uw-acme/NANO_QLASER/documents/Diagrams/readme.md

This directory is for user-created documents such as Visio block diagrams, pdfs of those diagrams, Excel spreadsheets for board-to-board connections.
Basically, any useful documentation that we create.
