uw-acme/NANO_QLASER/documents/Diagrams/qlaser-clocks.pdf

## FMC216 Board

# ZCU102 and FMC216 clock, sync connections [HPC0]

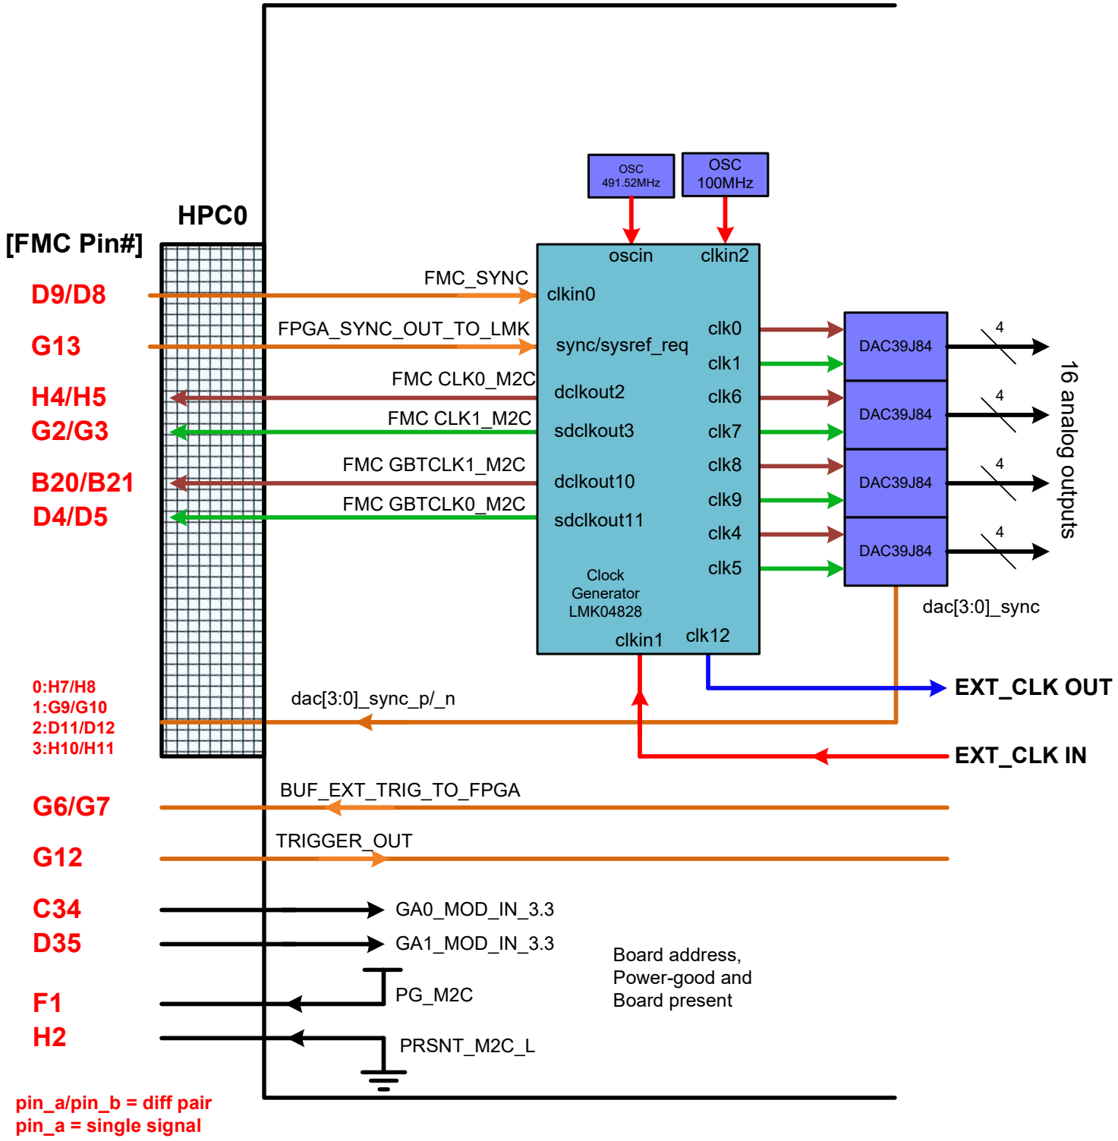
[picture p10: figure]
HPC0; DAC39J84; OSC 100MHz; EXT_CLK IN; EXT_CLK OUT; OSC 491.52MHz; FMC_SYNC; FPGA_SYNC_OUT_TO_LMK; FMC CLK1_M2C; FMC CLK0_M2C; FMC GBTCLK0_M2C; FMC GBTCLK1_M2C; dac[3:0]_sync; dac[3:0]_sync_p/_n 0:H7/H8 1:G9/G10 2:D11/D12 3:H10/H11; TRIGGER_OUT; PRSNT_M2C_L; GA1_MOD_IN_3.3; GA0_MOD_IN_3.3; clkin2; clkin1; oscin; clkin0; dclkout2; sdclkout3; dclkout10; sdclkout11; sync/sysref_req; BUF_EXT_TRIG_TO_FPGA G6/G7; clk12; clk0; clk1; clk6; clk7; clk8; clk9; clk4; clk5 Clock; Generator LMK04828; Board address, Power-good and; Board present; 16 analog outputs; [FMC Pin#]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
