uw-acme/NANO_QLASER/documents/Diagrams/FMC_connector_pinout.xlsx

Sheet: FMC216_connector_pinout
AV57.1 | FMC Pin | FMC216 Signal | FMC216 Dir | FPGA Pin | FPGA name | ZCU102 Net | I/O Stndrd | Notes
FMC0
CLK0_M2C_P | H4 | LLMK_DCLKOUT_2_P | Out | AA7 | P_FMC0_CLK0_M2C_P | FMC_HPC0_CLK0_M2C_P | LVDS | D-Clock
CLK0_M2C_N | H5 | LLMK_DCLKOUT_2_N | Out | AA6 | P_FMC0_CLK0_M2C_N | FMC_HPC0_CLK0_M2C_N | LVDS | D-Clock
CLK1_M2C_P | G2 | LLMK_SDCLKOUT_3_P | Out | T8 | P_FMC0_CLK1_M2C_P | FMC_HPC0_CLK1_M2C_P | LVDS | S-Clock
CLK1_M2C_N | G3 | LLMK_SDCLKOUT_3_N | Out | R8 | P_FMC0_CLK1_M2C_P | FMC_HPC0_CLK1_M2C_P | LVDS | S-Clock
GBTCLK0_M2C_P | D4 | LMK_SDCLK11_M2C_TO_FPGA_P | Out | G8 | P_FMC0_GBTCLK0_M2C_P | FMC_HPC0_GBTCLK0_M2C_P | LVDS | S-Clock
GBTCLK0_M2C_P | D5 | LMK_SDCLK11_M2C_TO_FPGA_N | Out | G7 | P_FMC0_GBTCLK0_M2C_N | FMC_HPC0_GBTCLK0_M2C_N | LVDS | S-Clock
GBTCLK1_M2C_P | B20 | LMK_DCLK10_M2C_TO_FPGA_P | Out | L8 | P_FMC0_GBTCLK1_M2C_P | FMC_HPC0_GBTCLK1_M2C_P | LVDS | DCLKOUT10_P is routed to the FPGA GBTCLK1_M2C_P
GBTCLK1_M2C_P | B21 | LMK_DCLK10_M2C_TO_FPGA_N | Out | L7 | P_FMC0_GBTCLK1_M2C_N | FMC_HPC0_GBTCLK1_M2C_N | LVDS | DCLKOUT10_N is routed to the FPGA GBTCLK1_M2C_N
DP0_C2M_P | C2 | DP0_C2M_P | In | G4 | P_FMC0_TXP_P[0] | FMC_HPC0_DP0_C2M_P | CML | DAC0_LANE0_P
DP0_C2M_N | C3 | DP0_C2M_N | In | G3 | P_FMC0_TXP_N[0] | FMC_HPC0_DP0_C2M_N | CML | DAC0_LANE0_N
DP1_C2M_P | A22 | DP1_C2M_P | In | H6 | P_FMC0_TXP_P[1] | FMC_HPC0_DP1_C2M_P | CML | DAC1_LANE0_P
DP1_C2M_N | A23 | DP1_C2M_N | In | H5 | P_FMC0_TXP_N[1] | FMC_HPC0_DP1_C2M_N | CML | DAC1_LANE0_N
DP2_C2M_P | A26 | DP2_C2M_P | In | F6 | P_FMC0_TXP_P[2] | FMC_HPC0_DP2_C2M_P | CML | DAC2_LANE0_P
DP2_C2M_N | A27 | DP2_C2M_N | In | F5 | P_FMC0_TXP_N[2] | FMC_HPC0_DP2_C2M_N | CML | DAC2_LANE0_N
DP3_C2M_P | A30 | DP3_C2M_P | In | K6 | P_FMC0_TXP_P[3] | FMC_HPC0_DP3_C2M_P | CML | DAC3_LANE0_P
DP3_C2M_N | A31 | DP3_C2M_N | In | K5 | P_FMC0_TXP_N[3] | FMC_HPC0_DP3_C2M_N | CML | DAC3_LANE0_N
DP4_C2M_P | A34 | DP4_C2M_P | In | M6 | P_FMC0_TXP_P[4] | FMC_HPC0_DP4_C2M_P | CML | DAC0_LANE1_P
DP4_C2M_N | A35 | DP4_C2M_N | In | M5 | P_FMC0_TXP_N[4] | FMC_HPC0_DP4_C2M_N | CML | DAC0_LANE1_N
DP5_C2M_P | A38 | DP5_C2M_P | In | P6 | P_FMC0_TXP_P[5] | FMC_HPC0_DP5_C2M_P | CML | DAC1_LANE1_P
DP5_C2M_N | A39 | DP5_C2M_N | In | P5 | P_FMC0_TXP_N[5] | FMC_HPC0_DP5_C2M_N | CML | DAC1_LANE1_N
DP6_C2M_P | B36 | DP6_C2M_P | In | R4 | P_FMC0_TXP_P[6] | FMC_HPC0_DP6_C2M_P | CML | DAC2_LANE1_P
DP6_C2M_N | B37 | DP6_C2M_N | In | R3 | P_FMC0_TXP_N[6] | FMC_HPC0_DP6_C2M_N | CML | DAC2_LANE1_N
DP7_C2M_P | B32 | DP7_C2M_P | In | N4 | P_FMC0_TXP_P[7] | FMC_HPC0_DP7_C2M_P | CML | DAC3_LANE1_P
DP7_C2M_N | B33 | DP7_C2M_N | In | N3 | P_FMC0_TXP_N[7] | FMC_HPC0_DP7_C2M_N | CML | DAC3_LANE1_N
LA00_P_CC | G6 | BUF_EXT_TRIG_TO_FPGA_P | Out | Y4 | P_FMC0_EXT_TRIG_IN_P | FMC_HPC0_LA00_CC_P | LVDS | From external trigger to FPGA
LA00_N_CC | G7 | BUF_EXT_TRIG_TO_FPGA_N | Out | Y3 | P_FMC0_EXT_TRIG_IN_N | FMC_HPC0_LA00_CC_N | LVDS | From external trigger to FPGA
LA01_P_CC | D8 | FPGA_SYNC_OUT_P | In | AB4 | P_FMC0_SYNC_OUT_P | FMC_HPC0_LA01_CC_P | LVDS | From FPGA to clock tree trigger
LA01_N_CC | D9 | FPGA_SYNC_OUT_N | In | AC4 | P_FMC0_SYNC_OUT_N | FMC_HPC0_LA01_CC_N | LVDS | From FPGA to clock tree trigger
LA02_P | H7 | DAC0_SYNC_P | Out | V2 | P_FMC0_SYNC_P[0] | FMC_HPC0_LA02_P | LVDS | Synchronization request to FPGA
LA02_N | H8 | DAC0_SYNC_N | Out | V1 | P_FMC0_SYNC_N[0] | FMC_HPC0_LA02_N | LVDS | Synchronization request to FPGA
LA03_P | G9 | DAC1_SYNC_P | Out | Y2 | P_FMC0_SYNC_P[1] | FMC_HPC0_LA03_P | LVDS | Synchronization request to FPGA
LA03_N | G10 | DAC1_SYNC_N | Out | Y1 | P_FMC0_SYNC_N[1] | FMC_HPC0_LA03_N | LVDS | Synchronization request to FPGA
LA04_P | H10 | DAC3_SYNC_P | Out | AA2 | P_FMC0_SYNC_P[3] | FMC_HPC0_LA04_P | LVDS | Synchronization request to FPGA
LA04_N | H11 | DAC3_SYNC_N | Out | AA1 | P_FMC0_SYNC_N[3] | FMC_HPC0_LA04_N | LVDS | Synchronization request to FPGA
LA05_P | D11 | DAC2_SYNC_P | Out | AB3 | P_FMC0_SYNC_P[2] | FMC_HPC0_LA05_P | LVDS | Synchronization request to FPGA
LA05_N | D12 | DAC2_SYNC_N | Out | AC3 | P_FMC0_SYNC_N[2] | FMC_HPC0_LA05_N | LVDS | Synchronization request to FPGA
LA06_P | C10 | FMC_CPLD_CTRL0_VADJ | I/O | AC2 | ? | FMC_HPC0_LA06_P | LVCMOS | CPLD Control Signal
LA06_N | C11 | FMC_CPLD_CTRL1_VADJ | I/O | AC1 | ? | FMC_HPC0_LA06_N | LVCMOS | CPLD Control Signal
LA07_P | H13 | FMC_CPLD_CTRL2_VADJ | I/O | U5 | ? | FMC_HPC0_LA07_P | LVCMOS | CPLD Control Signal
LA07_N | H14 | FMC_CPLD_CTRL3_VADJ | I/O | U4 | ? | FMC_HPC0_LA07_N | LVCMOS | CPLD Control Signal
LA08_P | G12 | TRIGGER_OUT | In | V4 | P_FMC0_TRIG_OUT ? | FMC_HPC0_LA08_P | LVCMOS | External Trigger output from FPGA
LA08_N | G13 | FPGA_SYNC_OUT_TO_LMK | In | V3 | P_FMC0_SYNC_LMK ? | FMC_HPC0_LA08_N | LVCMOS | SYNC from FPGA, connects to SYNC/SYSREF_REQ of LMK
GA0 | C34 | GA0_MOD_IN_3.3 | In | GND |  |  | LVCMOS | Card Global Address 0 from mezzanine connector
GA1 | D35 | GA1_MOD_IN_3.3 | In | GND |  |  | LVCMOS | Card Global Address 1 from mezzanine connector
GA0 | C34 | GA0_CC_OUT_3.3 | Out | GND |  |  | LVCMOS | Card Global Address 0 from CPLD to carrier connector
GA1 | D35 | GA1_CC_OUT_3.3 | Out | GND |  |  | LVCMOS | Card Global Address 1 from CPLD to carrier connector
TSRT_L | D34 | TRST_L | In | - | - |  | LVTTL | JTAG Reset in, (also passed through)
TCK | D29 | TCK | In | - | - |  | LVTTL | JTAG Clock in, (also passed through)
TMS | D33 | TMS | In | - | - |  | LVTTL | JTAG Test Mode Select (also passed through)
TDI | D30 | TDI | In | - | - |  | LVTTL | JTAG Data in (also passed through)
TDO | D31 | TDO | Out | - | - |  | LVTTL | JTAG Data Out (also passed through)
PRSNT_M2C_L | H2 | PRSNT_M2C_L | Out | - | - | FMC_HPC0_PRSNT_M2C_B | Ground | Tied to GND (FM216 is present). Controls JTAG switch.
PRSNT_M2C_L | H2 | PRSNT_M2C_CC_L | In | - | - |  | LVCMOS | Indicates that a stacked card is present (from carrier connector to CPLD)
PG_M2C | F1 | PG_M2C | Out | - | - | FMC_HPC0_PG_M2C | Open Drain | Indicate FMC216 power good status to carrier (4.7K pullup to 3.3V)
PG_C2M | D1 | PG_C2M | Out | - | - |  | CMOS | Indicates that Carrier power is OK
I2C_SCL | C30 | I2C_SCL | In | - | - |  | CMOS | I2C Bus Clock (also passed through)
I2C_SDA | C31 | I2C_SDA | I/O | - | - |  | Open | Drain I2C Bus Data (also passed through)
RES0 | B40 | RES0 | n/a | - | - |  | n/a | Passed thru no connection
CLK_DIR | B1 | CLK_DIR | Out | - | - |  | CMOS* | Driven by mezzanine, *pop option to tie high or low
Remapped
CLK2_BIDR_P | H4 | CLK0_M2C_P | I/O |  |  |  | LVDS | remapped signal for stacked operation
CLK2_BIDR_N | H5 | CLK0_M2C_N | I/O |  |  |  | LVDS | remapped signal for stacked operation
CLK3_BIDR_P | G2 | CLK1_M2C_P | I/O |  |  |  | LVDS | remapped signal for stacked operation
CLK3_BIDR_N | G3 | CLK1_M2C_N | I/O |  |  |  | LVDS | remapped signal for stacked operation
HA17_P_CC | G6 | LA00_P_CC | I/O |  |  |  | LVDS | remapped signal for stacked operation
HA17_N_CC | G7 | LA00_N_CC | I/O |  |  |  | LVDS | remapped signal for stacked operation
HA18_P | D8 | LA01_P_CC | I/O |  |  |  | LVDS | remapped signal for stacked operation
HA18_N | D9 | LA01_N_CC | I/O |  |  |  | LVDS | remapped signal for stacked operation
HA10_P | H7 | LA02_P | I/O |  |  |  | LVDS | remapped signal for stacked operation
HA10_N | H8 | LA02_N | I/O |  |  |  | LVDS | remapped signal for stacked operation
HA11_P | G9 | LA03_P | I/O |  |  |  | LVDS | remapped signal for stacked operation
HA11_N | G10 | LA03_N | I/O |  |  |  | LVDS | remapped signal for stacked operation
HA12_P | H10 | LA04_P | I/O |  |  |  | LVDS | remapped signal for stacked operation
HA12_N | H11 | LA04_N | I/O |  |  |  | LVDS | remapped signal for stacked operation
HA13_P | D11 | LA05_P | I/O |  |  |  | LVDS | remapped signal for stacked operation
HA13_N | D12 | LA05_N | I/O |  |  |  | LVDS | remapped signal for stacked operation
HA14_P | C10 | LA06_P | I/O |  |  |  | LVDS | remapped signal for stacked operation
HA14_N | C11 | LA06_N | I/O |  |  |  | LVDS | remapped signal for stacked operation
HA15_P | H13 | LA07_P | I/O |  |  |  | LVDS | remapped signal for stacked operation
HA15_N | H14 | LA07_N | I/O |  |  |  | LVDS | remapped signal for stacked operation
HA16_P | G12 | LA08_P | I/O |  |  |  | LVDS | remapped signal for stacked operation
HA16_N | G13 | LA08_N | I/O |  |  |  | LVDS | remapped signal for stacked operation

Sheet: FMC0-1-fpga-conn
AV57.1 | FMC Pin | FMC216 Signal | FMC216 Dir | FPGA Pin | FPGA name | ZCU102 Net | I/O Stndrd | Notes
FMC0
CLK0_M2C_P | H4 | LLMK_DCLKOUT_2_P | Out | AA7 | P_FMC0_CLK0_M2C_P | FMC_HPC0_CLK0_M2C_P | LVDS | D-Clock (for stacked card)
CLK0_M2C_N | H5 | LLMK_DCLKOUT_2_N | Out | AA6 | P_FMC0_CLK0_M2C_N | FMC_HPC0_CLK0_M2C_N | LVDS | D-Clock
CLK1_M2C_P | G2 | LLMK_SDCLKOUT_3_P | Out | T8 | P_FMC0_CLK1_M2C_P | FMC_HPC0_CLK1_M2C_P | LVDS | S-Clock (for stacked card)
CLK1_M2C_N | G3 | LLMK_SDCLKOUT_3_N | Out | R8 | P_FMC0_CLK1_M2C_P | FMC_HPC0_CLK1_M2C_P | LVDS | S-Clock
GBTCLK0_M2C_P | D4 | LMK_SDCLK11_M2C_TO_FPGA_P | Out | G8 | P_FMC0_GBTCLK0_M2C_P | FMC_HPC0_GBTCLK0_M2C_P | LVDS | S-Clock (REFCLK?)
GBTCLK0_M2C_P | D5 | LMK_SDCLK11_M2C_TO_FPGA_N | Out | G7 | P_FMC0_GBTCLK0_M2C_N | FMC_HPC0_GBTCLK0_M2C_N | LVDS | S-Clock
GBTCLK1_M2C_P | B20 | LMK_DCLK10_M2C_TO_FPGA_P | Out | L8 | P_FMC0_GBTCLK1_M2C_P | FMC_HPC0_GBTCLK1_M2C_P | LVDS | DCLKOUT10_P is routed to the FPGA GBTCLK1_M2C_P
GBTCLK1_M2C_P | B21 | LMK_DCLK10_M2C_TO_FPGA_N | Out | L7 | P_FMC0_GBTCLK1_M2C_N | FMC_HPC0_GBTCLK1_M2C_N | LVDS | DCLKOUT10_N is routed to the FPGA GBTCLK1_M2C_N
DP0_C2M_P | C2 | DP0_C2M_P | In | G4 | P_FMC0_TXP_P[0] | FMC_HPC0_DP0_C2M_P | CML | DAC0_LANE0_P
DP0_C2M_N | C3 | DP0_C2M_N | In | G3 | P_FMC0_TXP_N[0] | FMC_HPC0_DP0_C2M_N | CML | DAC0_LANE0_N
DP1_C2M_P | A22 | DP1_C2M_P | In | H6 | P_FMC0_TXP_P[1] | FMC_HPC0_DP1_C2M_P | CML | DAC1_LANE0_P
DP1_C2M_N | A23 | DP1_C2M_N | In | H5 | P_FMC0_TXP_N[1] | FMC_HPC0_DP1_C2M_N | CML | DAC1_LANE0_N
DP2_C2M_P | A26 | DP2_C2M_P | In | F6 | P_FMC0_TXP_P[2] | FMC_HPC0_DP2_C2M_P | CML | DAC2_LANE0_P
DP2_C2M_N | A27 | DP2_C2M_N | In | F5 | P_FMC0_TXP_N[2] | FMC_HPC0_DP2_C2M_N | CML | DAC2_LANE0_N
DP3_C2M_P | A30 | DP3_C2M_P | In | K6 | P_FMC0_TXP_P[3] | FMC_HPC0_DP3_C2M_P | CML | DAC3_LANE0_P
DP3_C2M_N | A31 | DP3_C2M_N | In | K5 | P_FMC0_TXP_N[3] | FMC_HPC0_DP3_C2M_N | CML | DAC3_LANE0_N
DP4_C2M_P | A34 | DP4_C2M_P | In | M6 | P_FMC0_TXP_P[4] | FMC_HPC0_DP4_C2M_P | CML | DAC0_LANE1_P
DP4_C2M_N | A35 | DP4_C2M_N | In | M5 | P_FMC0_TXP_N[4] | FMC_HPC0_DP4_C2M_N | CML | DAC0_LANE1_N
DP5_C2M_P | A38 | DP5_C2M_P | In | P6 | P_FMC0_TXP_P[5] | FMC_HPC0_DP5_C2M_P | CML | DAC1_LANE1_P
DP5_C2M_N | A39 | DP5_C2M_N | In | P5 | P_FMC0_TXP_N[5] | FMC_HPC0_DP5_C2M_N | CML | DAC1_LANE1_N
DP6_C2M_P | B36 | DP6_C2M_P | In | R4 | P_FMC0_TXP_P[6] | FMC_HPC0_DP6_C2M_P | CML | DAC2_LANE1_P
DP6_C2M_N | B37 | DP6_C2M_N | In | R3 | P_FMC0_TXP_N[6] | FMC_HPC0_DP6_C2M_N | CML | DAC2_LANE1_N
DP7_C2M_P | B32 | DP7_C2M_P | In | N4 | P_FMC0_TXP_P[7] | FMC_HPC0_DP7_C2M_P | CML | DAC3_LANE1_P
DP7_C2M_N | B33 | DP7_C2M_N | In | N3 | P_FMC0_TXP_N[7] | FMC_HPC0_DP7_C2M_N | CML | DAC3_LANE1_N
LA00_P_CC | G6 | BUF_EXT_TRIG_TO_FPGA_P | Out | Y4 | P_FMC0_EXT_TRIG_IN_P | FMC_HPC0_LA00_CC_P | LVDS | From external trigger to FPGA
LA00_N_CC | G7 | BUF_EXT_TRIG_TO_FPGA_N | Out | Y3 | P_FMC0_EXT_TRIG_IN_N | FMC_HPC0_LA00_CC_N | LVDS | From external trigger to FPGA
LA01_P_CC | D8 | FPGA_SYNC_OUT_P | In | AB4 | P_FMC0_SYNC_OUT_P | FMC_HPC0_LA01_CC_P | LVDS | From FPGA to clock tree trigger
LA01_N_CC | D9 | FPGA_SYNC_OUT_N | In | AC4 | P_FMC0_SYNC_OUT_N | FMC_HPC0_LA01_CC_N | LVDS | From FPGA to clock tree trigger
LA02_P | H7 | DAC0_SYNC_P | Out | V2 | P_FMC0_SYNC_P[0] | FMC_HPC0_LA02_P | LVDS | Synchronization request to FPGA
LA02_N | H8 | DAC0_SYNC_N | Out | V1 | P_FMC0_SYNC_N[0] | FMC_HPC0_LA02_N | LVDS | Synchronization request to FPGA
LA03_P | G9 | DAC1_SYNC_P | Out | Y2 | P_FMC0_SYNC_P[1] | FMC_HPC0_LA03_P | LVDS | Synchronization request to FPGA
LA03_N | G10 | DAC1_SYNC_N | Out | Y1 | P_FMC0_SYNC_N[1] | FMC_HPC0_LA03_N | LVDS | Synchronization request to FPGA
LA04_P | H10 | DAC3_SYNC_P | Out | AA2 | P_FMC0_SYNC_P[3] | FMC_HPC0_LA04_P | LVDS | Synchronization request to FPGA
LA04_N | H11 | DAC3_SYNC_N | Out | AA1 | P_FMC0_SYNC_N[3] | FMC_HPC0_LA04_N | LVDS | Synchronization request to FPGA
LA05_P | D11 | DAC2_SYNC_P | Out | AB3 | P_FMC0_SYNC_P[2] | FMC_HPC0_LA05_P | LVDS | Synchronization request to FPGA
LA05_N | D12 | DAC2_SYNC_N | Out | AC3 | P_FMC0_SYNC_N[2] | FMC_HPC0_LA05_N | LVDS | Synchronization request to FPGA
LA06_P | C10 | FMC_CPLD_CTRL0_VADJ | I/O | AC2 | ? | FMC_HPC0_LA06_P | LVCMOS | CPLD Control Signal
LA06_N | C11 | FMC_CPLD_CTRL1_VADJ | I/O | AC1 | ? | FMC_HPC0_LA06_N | LVCMOS | CPLD Control Signal
LA07_P | H13 | FMC_CPLD_CTRL2_VADJ | I/O | U5 | ? | FMC_HPC0_LA07_P | LVCMOS | CPLD Control Signal
LA07_N | H14 | FMC_CPLD_CTRL3_VADJ | I/O | U4 | ? | FMC_HPC0_LA07_N | LVCMOS | CPLD Control Signal
LA08_P | G12 | TRIGGER_OUT | In | V4 | P_FMC0_TRIG_OUT ? | FMC_HPC0_LA08_P | LVCMOS | External Trigger output from FPGA
LA08_N | G13 | FPGA_SYNC_OUT_TO_LMK | In | V3 | P_FMC0_SYNC_LMK ? | FMC_HPC0_LA08_N | LVCMOS | SYNC from FPGA, connects to SYNC/SYSREF_REQ of LMK
GA0 | C34 | GA0_MOD_IN_3.3 | In | GND |  |  | LVCMOS | Card Global Address 0 from mezzanine connector
GA1 | D35 | GA1_MOD_IN_3.3 | In | GND |  |  | LVCMOS | Card Global Address 1 from mezzanine connector
GA0 | C34 | GA0_CC_OUT_3.3 | Out | GND |  |  | LVCMOS | Card Global Address 0 from CPLD to carrier connector
GA1 | D35 | GA1_CC_OUT_3.3 | Out | GND |  |  | LVCMOS | Card Global Address 1 from CPLD to carrier connector
TSRT_L | D34 | TRST_L | In | - | - |  | LVTTL | JTAG Reset in, (also passed through)
TCK | D29 | TCK | In | - | - |  | LVTTL | JTAG Clock in, (also passed through)
TMS | D33 | TMS | In | - | - |  | LVTTL | JTAG Test Mode Select (also passed through)
TDI | D30 | TDI | In | - | - |  | LVTTL | JTAG Data in (also passed through)
TDO | D31 | TDO | Out | - | - |  | LVTTL | JTAG Data Out (also passed through)
PRSNT_M2C_L | H2 | PRSNT_M2C_L | Out | - | - | FMC_HPC0_PRSNT_M2C_B | Ground | Tied to GND (FM216 is present). Controls JTAG switch.
PRSNT_M2C_L | H2 | PRSNT_M2C_CC_L | In | - | - |  | LVCMOS | Indicates that a stacked card is present (from carrier connector to CPLD)
PG_M2C | F1 | PG_M2C | Out | - | - | FMC_HPC0_PG_M2C | Open Drain | Indicate FMC216 power good status to carrier (4.7K pullup to 3.3V)
PG_C2M | D1 | PG_C2M | Out | - | - |  | CMOS | Indicates that Carrier power is OK
I2C_SCL | C30 | I2C_SCL | In | - | - |  | CMOS | I2C Bus Clock (also passed through)
I2C_SDA | C31 | I2C_SDA | I/O | - | - |  | Open | Drain I2C Bus Data (also passed through)
RES0 | B40 | RES0 | n/a | - | - |  | n/a | Passed thru no connection
CLK_DIR | B1 | CLK_DIR | Out | - | - |  | CMOS* | Driven by mezzanine, *pop option to tie high or low
FMC1
CLK0_M2C_P | H4 | LLMK_DCLKOUT_2_P | Out | AE7 | P_FMC1_CLK0_M2C_P | FMC_HPC1_CLK0_M2C_P | LVDS | D-Clock
CLK0_M2C_N | H5 | LLMK_DCLKOUT_2_N | Out | AF7 | P_FMC1_CLK0_M2C_N | FMC_HPC1_CLK0_M2C_N | LVDS | D-Clock
CLK1_M2C_P | G2 | LLMK_SDCLKOUT_3_P | Out | P10 | P_FMC1_CLK1_M2C_P | FMC_HPC1_CLK1_M2C_P | LVDS | S-Clock
CLK1_M2C_N | G3 | LLMK_SDCLKOUT_3_N | Out | P9 | P_FMC1_CLK1_M2C_P | FMC_HPC1_CLK1_M2C_P | LVDS | S-Clock
GBTCLK0_M2C_P | D4 | LMK_SDCLK11_M2C_TO_FPGA_P | Out | G27 | P_FMC1_GBTCLK0_M2C_P | FMC_HPC1_GBTCLK0_M2C_P | LVDS | S-Clock
GBTCLK0_M2C_P | D5 | LMK_SDCLK11_M2C_TO_FPGA_N | Out | G28 | P_FMC1_GBTCLK0_M2C_N | FMC_HPC1_GBTCLK0_M2C_N | LVDS | S-Clock
GBTCLK1_M2C_P | B20 | LMK_DCLK10_M2C_TO_FPGA_P | Out | E27 | P_FMC1_GBTCLK1_M2C_P | FMC_HPC1_GBTCLK1_M2C_P | LVDS | DCLKOUT10_P is routed to the FPGA GBTCLK1_M2C_P
GBTCLK1_M2C_P | B21 | LMK_DCLK10_M2C_TO_FPGA_N | Out | E28 | P_FMC1_GBTCLK1_M2C_N | FMC_HPC1_GBTCLK1_M2C_N | LVDS | DCLKOUT10_N is routed to the FPGA GBTCLK1_M2C_N
DP0_C2M_P | C2 | DP0_C2M_P | In | F29 | P_FMC1_TXP_P[0] | FMC_HPC1_DP0_C2M_P | CML | DAC0_LANE0_P
DP0_C2M_N | C3 | DP0_C2M_N | In | F30 | P_FMC1_TXP_N[0] | FMC_HPC1_DP0_C2M_N | CML | DAC0_LANE0_N
DP1_C2M_P | A22 | DP1_C2M_P | In | D29 | P_FMC1_TXP_P[1] | FMC_HPC1_DP1_C2M_P | CML | DAC1_LANE0_P
DP1_C2M_N | A23 | DP1_C2M_N | In | D30 | P_FMC1_TXP_N[1] | FMC_HPC1_DP1_C2M_N | CML | DAC1_LANE0_N
DP2_C2M_P | A26 | DP2_C2M_P | In | B29 | P_FMC1_TXP_P[2] | FMC_HPC1_DP2_C2M_P | CML | DAC2_LANE0_P
DP2_C2M_N | A27 | DP2_C2M_N | In | B30 | P_FMC1_TXP_N[2] | FMC_HPC1_DP2_C2M_N | CML | DAC2_LANE0_N
DP3_C2M_P | A30 | DP3_C2M_P | In | A31 | P_FMC1_TXP_P[3] | FMC_HPC1_DP3_C2M_P | CML | DAC3_LANE0_P
DP3_C2M_N | A31 | DP3_C2M_N | In | A32 | P_FMC1_TXP_N[3] | FMC_HPC1_DP3_C2M_N | CML | DAC3_LANE0_N
DP4_C2M_P | A34 | DP4_C2M_P | In | K29 | P_FMC1_TXP_P[4] | FMC_HPC1_DP4_C2M_P | CML | DAC0_LANE1_P
DP4_C2M_N | A35 | DP4_C2M_N | In | K30 | P_FMC1_TXP_N[4] | FMC_HPC1_DP4_C2M_N | CML | DAC0_LANE1_N
DP5_C2M_P | A38 | DP5_C2M_P | In | J31 | P_FMC1_TXP_P[5] | FMC_HPC1_DP5_C2M_P | CML | DAC1_LANE1_P
DP5_C2M_N | A39 | DP5_C2M_N | In | J32 | P_FMC1_TXP_N[5] | FMC_HPC1_DP5_C2M_N | CML | DAC1_LANE1_N
DP6_C2M_P | B36 | DP6_C2M_P | In | H29 | P_FMC1_TXP_P[6] | FMC_HPC1_DP6_C2M_P | CML | DAC2_LANE1_P
DP6_C2M_N | B37 | DP6_C2M_N | In | H30 | P_FMC1_TXP_N[6] | FMC_HPC1_DP6_C2M_N | CML | DAC2_LANE1_N
DP7_C2M_P | B32 | DP7_C2M_P | In | G31 | P_FMC1_TXP_P[7] | FMC_HPC1_DP7_C2M_P | CML | DAC3_LANE1_P
DP7_C2M_N | B33 | DP7_C2M_N | In | G32 | P_FMC1_TXP_N[7] | FMC_HPC1_DP7_C2M_N | CML | DAC3_LANE1_N
LA00_P_CC | G6 | BUF_EXT_TRIG_TO_FPGA_P | Out | AE5 | P_FMC1_EXT_TRIG_IN_P | FMC_HPC1_LA00_CC_P | LVDS | From external trigger to FPGA
LA00_N_CC | G7 | BUF_EXT_TRIG_TO_FPGA_N | Out | AF5 | P_FMC1_EXT_TRIG_IN_N | FMC_HPC1_LA00_CC_N | LVDS | From external trigger to FPGA
LA01_P_CC | D8 | FPGA_SYNC_OUT_P | In | AJ6 | P_FMC1_SYNC_OUT_P | FMC_HPC1_LA01_CC_P | LVDS | From FPGA to clock tree trigger
LA01_N_CC | D9 | FPGA_SYNC_OUT_N | In | AJ5 | P_FMC1_SYNC_OUT_N | FMC_HPC1_LA01_CC_N | LVDS | From FPGA to clock tree trigger
LA02_P | H7 | DAC0_SYNC_P | Out | AD2 | P_FMC1_SYNC_P[0] | FMC_HPC1_LA02_P | LVDS | Synchronization request to FPGA
LA02_N | H8 | DAC0_SYNC_N | Out | AD1 | P_FMC1_SYNC_N[0] | FMC_HPC1_LA02_N | LVDS | Synchronization request to FPGA
LA03_P | G9 | DAC1_SYNC_P | Out | AH1 | P_FMC1_SYNC_P[1] | FMC_HPC1_LA03_P | LVDS | Synchronization request to FPGA
LA03_N | G10 | DAC1_SYNC_N | Out | AJ1 | P_FMC1_SYNC_N[1] | FMC_HPC1_LA03_N | LVDS | Synchronization request to FPGA
LA04_P | H10 | DAC3_SYNC_P | Out | AF2 | P_FMC1_SYNC_P[3] | FMC_HPC1_LA04_P | LVDS | Synchronization request to FPGA
LA04_N | H11 | DAC3_SYNC_N | Out | AF1 | P_FMC1_SYNC_N[3] | FMC_HPC1_LA04_N | LVDS | Synchronization request to FPGA
LA05_P | D11 | DAC2_SYNC_P | Out | AG3 | P_FMC1_SYNC_P[2] | FMC_HPC1_LA05_P | LVDS | Synchronization request to FPGA
LA05_N | D12 | DAC2_SYNC_N | Out | AH3 | P_FMC1_SYNC_N[2] | FMC_HPC1_LA05_N | LVDS | Synchronization request to FPGA
LA06_P | C10 | FMC_CPLD_CTRL0_VADJ | I/O | AH2 | ? | FMC_HPC1_LA06_P | LVCMOS | CPLD Control Signal
LA06_N | C11 | FMC_CPLD_CTRL1_VADJ | I/O | AJ2 | ? | FMC_HPC1_LA06_N | LVCMOS | CPLD Control Signal
LA07_P | H13 | FMC_CPLD_CTRL2_VADJ | I/O | AD4 | ? | FMC_HPC1_LA07_P | LVCMOS | CPLD Control Signal
LA07_N | H14 | FMC_CPLD_CTRL3_VADJ | I/O | AE4 | ? | FMC_HPC1_LA07_N | LVCMOS | CPLD Control Signal
LA08_P | G12 | TRIGGER_OUT | In | AD4 | P_FMC1_TRIG_OUT ? | FMC_HPC1_LA08_P | LVCMOS | External Trigger output from FPGA
LA08_N | G13 | FPGA_SYNC_OUT_TO_LMK | In | AE4 | P_FMC1_SYNC_LMK ? | FMC_HPC1_LA08_N | LVCMOS | SYNC from FPGA, connects to SYNC/SYSREF_REQ of LMK
GA0 | C34 | GA0_MOD_IN_3.3 | In | GND |  |  | LVCMOS | Card Global Address 0 from mezzanine connector
GA1 | D35 | GA1_MOD_IN_3.3 | In | GND |  |  | LVCMOS | Card Global Address 1 from mezzanine connector
GA0 | C34 | GA0_CC_OUT_3.3 | Out | GND |  |  | LVCMOS | Card Global Address 0 from CPLD to carrier connector
GA1 | D35 | GA1_CC_OUT_3.3 | Out | GND |  |  | LVCMOS | Card Global Address 1 from CPLD to carrier connector
TSRT_L | D34 | TRST_L | In | - | - |  | LVTTL | JTAG Reset in, (also passed through)
TCK | D29 | TCK | In | - | - |  | LVTTL | JTAG Clock in, (also passed through)
TMS | D33 | TMS | In | - | - |  | LVTTL | JTAG Test Mode Select (also passed through)
TDI | D30 | TDI | In | - | - |  | LVTTL | JTAG Data in (also passed through)
TDO | D31 | TDO | Out | - | - |  | LVTTL | JTAG Data Out (also passed through)
PRSNT_M2C_L | H2 | PRSNT_M2C_L | Out | - | - | FMC_HPC0_PRSNT_M2C_B | Ground | Tied to GND (FM216 is present). Controls JTAG switch.
PRSNT_M2C_L | H2 | PRSNT_M2C_CC_L | In | - | - |  | LVCMOS | Indicates that a stacked card is present (from carrier connector to CPLD)
PG_M2C | F1 | PG_M2C | Out | - | - | FMC_HPC0_PG_M2C | Open Drain | Indicate FMC216 power good status to carrier (4.7K pullup to 3.3V)
PG_C2M | D1 | PG_C2M | Out | - | - |  | CMOS | Indicates that Carrier power is OK
I2C_SCL | C30 | I2C_SCL | In | - | - |  | CMOS | I2C Bus Clock (also passed through)
I2C_SDA | C31 | I2C_SDA | I/O | - | - |  | Open | Drain I2C Bus Data (also passed through)
RES0 | B40 | RES0 | n/a | - | - |  | n/a | Passed thru no connection
CLK_DIR | B1 | CLK_DIR | Out | - | - |  | CMOS* | Driven by mezzanine, *pop option to tie high or low
