uw-acme/NANO_QLASER/documents/VhdlCodingStyle.docx

Title: | VHDL Coding Styles

CHANGE HISTORY:

Revision | Description of Change | Effective Date
A | Initial release. | Initial Release

# 1. Introduction

### Purpose

The purpose of the following guidelines is to ensure that code is developed in a way that is easy to maintain and understand by different engineers.

### Scope

This document is intended to be used by engineers that are developing FPGA and ASIC code in VHDL although the general principles also apply to writing Verilog code (if you enjoy spending time debugging instead of letting the compiler do it for you. 😊.)

# 2. VHDL CODING Guidelines

## Language version

Write code that complies with VHDL-2008. [Or whatever version supersedes it]

## Naming

Naming is very important. A good name helps the reader understand your code with less effort. We all make assumptions when we see a name. If our assumptions are correct, then we can read code more smoothly. If your assumptions are incorrect then when we discover that fact, we must pause and mentally adjust. Try to build names so that the most important information comes first.

Example: The data output bus from a FIFO in the bs block should be named ‘bs_fifo_dout’ not ‘dout_bs_fifo’ or ‘dout_fifo_bs’. Think of the name as having a hierarchy of its own from most important to least important, or most general to most specific.

A name should indicate the purpose or function of the object and not its type.

Example: an 8-bit loadable counter used for addressing should be called cnt_address (its function) rather than ‘cnt_load8’ (its type).

All names shall be lower case except for constants, generics and enumerations, which shall be upper case.

### Signal Names

Use all lowercase letters and underscores "_" to improve legibility.

Use _i as the ending for internal nets in a block that also drive an output port. Do not use _i for interrupts or integers. Use _intr or _interrupt at the end for an interrupt.

Use _n for active low signals. (…but never use them.)

Use _d to add to the end of a signal which has been delayed by one clock. Use d1, d2, etc., for additional pipeline delays. But in general, use an array if there are more than 2 delays.

All clock names should begin with clk_ if it is followed by an alpha numeric name. The underscore is optional for clk followed by a number (i.e. clk100). Don't hide ‘clk’ in the middle or at the end. Use clk_in, clk_pci, clk_avi, clk_1, clk_2, clk_192d, clk40mhz, etc., not pciclk, mclock, sclk, etc. If a signal is a clock, then that is its most important feature and you want to know that first. What it is clocking is the next most important feature. The clock frequency is the least important piece of information and can often change during the design process so avoid using it as a part of the name whenever possible.

Within a block with only one clock you can just use the name clk.

To identify signals in a block that are coming from another clock domain and need to be synchronized, you can use _clk_name suffix to indicate a signal that is in the clk_name domain.

Use *_msync for identifying metastability synchronizers. Ideally, there would be a function in a common package that would implement the metastability synchronizers. This would ensure a consistent name style that would make it easy to search and find all synchronizers.

For differential signal pairs, assign the positive polarity signal without any suffix. Have the tool insert the negative polarity signal.

### Port Name

Use _pad and _core for I/O block names, rather than using _in or _out suffixes on port names just to indicate the ports direction. It’s ok to use in and _out if they are describing function and not just port direction such as data_in and data_out since they distinguish between the data going in and the data going out.

Port names across the hierarchy do not have to match exactly, but there should be consistency in the name and the differences should make sense. In general, as a name goes up the hierarchy it needs to become more specific to identify which block it is generated from.

Opinions vary on whether it is a good idea to try to keep net names and therefore port names the same across different levels of hierarchy. I don't think that it's necessary. If it adds to readability, then fine but does a top level block really need to know that the error port on a major block at the top level of a design is ‘ps_fifo_xyz_overflow_err’ or just that it is the ps block error output.(‘ps_err’)

### Variables

Use v_ prefix for variable names.

Don’t use variables in a process unless it makes the code simpler and easier to understand. Variables can’t be seen in the simulator waveform, so they make debugging more difficult. With today’s optimized compilers having signals don’t make the compiler slow down appreciably.

### Type and Record Type Names

Type definitions begin with t_ and record type definitions begin with t_rec_.

Type definitions of an array for a specific purpose can use the t_arr_ prefix, e.g:

constant MAX_BURST_LEN : integer := 32; -- 16-bit words

type t_arr_burst is array (0 to MAX_BURST_LEN-1) of std_logic_vector(31 downto 0);

Arrays of standard logic vectors can be defined for a more general use. These can be defined in a common package and might be used for different sorts of signals in more than one place. These can be defined using the format t_arr_slv<bits>, where <bits> is the vector size. For example:

type t_arr_slv32 is array (natural range <>) of std_logic_vector(31 downto 0);

type t_arr_slv16 is array (natural range <>) of std_logic_vector(15 downto 0);

signal my_arr : t_arr_slv32(5 downto 0);

The naming is still general to detailed. When you see t_arr_slv32 you think - "It’s a type, it’s an array, it’s a sort of std_logic_vector and the words are 32-bit".

### Constants, Generics and Enumerated Types

Constants, Generics and Enumerations should always be UPPER CASE.

It is recommended to always use the ‘G_’ prefix for generics.

It is recommended to always use the ‘S_’ prefix for enumerations that are state-machine state names.

A ‘C_’ prefix could be used for constant names but if we restrict upper-case usage to constants, generics and enumerated type values then the ‘C_’ is not really required.

Constant names should start by telling you something about the constant e.g.

-- Block select bits

constant BSEL_VID : integer := 0;

constant BSEL_SDCARD : integer := 1;

constant BSEL_INTERRUPT : integer := 2;

-- Register addresses

constant ADR_REG_CTRL : std_logic_vector(15 downto 0):= 0x1000; -- address of control reg

constant ADR_REG_STATUS : std_logic_vector(15 downto 0):= 0x1800; -- address of status reg

constant ADR_REG_TIMER0 : std_logic_vector(15 downto 0):= 0x2000; -- address of...

constant ADR_DRV_TIMER1 : std_logic_vector(15 downto 0):= 0x2800; -- address of...

Enumerated types

type t_state_sys is (S_SYS_START, S_SYS_WAIT, S_SYS_SHUTDOWN, S_SYS_SHUT_DONE);

There should not be hardcoded numbers ('magic numbers') embedded in the code. Instead use constants instead of putting in the code. All zero and all one values are the only exceptions.

Instead of this:

reg_avo_length_pframe <= "1001110000";

Do this: define a constant at the top of the file then assign the constant in the original line.

constant FRAME_LENGTH_MAX : std_logic_vector( 9 downto 0) := conv_std_logic_vector(624, 10);

reg_avo_length_pframe <= FRAME_LENGTH_MAX;

To avoid magic numbers in the constant declaration, define the constant as an integer and set the width at the time of assignment.

constant RD_FIFO_ALMOST_EMPTY : integer := 8;

if (fifo_level <= to_unsigned(RD_FIFO_ALMOST_EMPTY, fifo_level’length)) then

### Types, Constants and Packages

Types and constants that are only used within one file should be declared in that file (not in a separate package).

Types and constants that are used by multiple files but are confined to a major block (whose files are in one directory or sub-directories) should be put in a package file in that block’s directory.

Types and constants that are used by multiple blocks that span different directories should be put in a package that resides in a separate top-level directory (i.e. packages).

### Name Declaration Comments

Every port, signal, constant, type, etc. (except obvious ones like clock and reset) should have a comment describing the purpose or function of that object.

### Process Names

Use prefix pr_ for process names. It is helpful if the rest of the process name refers to the output signal of the process, if there is just one, or to the overall function of the process. Spend some time picking names. This will pay off when looking at simulator or synthesis tool output transcripts when debugging.

If the clock frequency is important, do pr_clk_rate_function. For example, pr_clk_48_gen.

If a process is long, it helps readability to add the process name to the end statement. For example,

end process pr_clk_48_gen;

### Architecture Names

Use rtl as the architecture name for synthesizable code.

Do not use design. The name is trying to tell the reader something about the design style. Normally use ‘rtl’ (register transfer language) since this is the commonest coding style. Use ‘behave’ or ‘behavioral’ if that really is the style of code. You can use ‘struct’ or ‘structural’ for an architecture if the contents simply connect block instances together with no additional logic. If you have different architectures of RTL code, then use names like ‘rtl_ram4k’ and ‘rtl_ram8k’

If the code uses vendor-specific macrocells or attributes, then you can use the architecture rtl_vendor e.g. a file with a Xilinx DLL instantiated in it has the architecture name rtl_xilinx.

Use behave for an architecture name that is typically not synthesizable, such as a testbench model.

Use empty for architectures that do nothing except drive their outputs to 1s or 0s. The file name for this architecture should be entity_empty.vhd.

Use dummy for architectures that have limited functionality, i.e. a CPU that can read and write registers but nothing else. The file name for this architecture should be entity_dummy.vhd.

When creating a new entity – drive all outputs to some default value if the functionality is not completed yet.

### Packages

Package names should have _pkg suffix. Package file names should be xx_pkg.vhd

### Components & Instances

Use u_xx for the instantiated name of an instance of entity xx. (This is a common convention in board level schematics and some of us are old enough to have done ASIC and FPGA designs with schematics and we are used to it. So there. The ‘u_’ is also not typically used in any other way and makes it easy to search for instantiated components.

In general, it is better to infer components, unless there is some specific reason why you want to make sure you get a specific component.

Try to avoid component declarations – instead, use the entity type of component instantiation:

u_myblock: entity work.myblock;

For vendor tool generated IP, put the component declaration in either a component package or in the file in which it is instantiated, and use

u_ram_my_seq: ram_my_seq;

Use functional IP names rather generic names. For instance, if generating a 256-word x 8-bit RAM for a sequencer, use ram_my_seq, rather than ram_sp_256x8.

Port-to-signal connections in a component instantiation should be specified with named association rather than positional association.(Added especially for Verilog-using scum. You know who you are)

### Generated Logic

Use prefix g_ for generate block labels.

For example:

g_xxx : for I in 0 to 3 generate

### State Machines

State machines should use enumerated types to define the states using t_state or t_state_xxx to define the enumeration. The state variable should be named state or state_xxx if there is more than one state machine in the file.

e.g. : type t_state_sys is (S_SYS_START, S_SYS_WAIT, S_SYS_SHUTDOWN, S_SYS_DONE);

### Summary of Naming Prefixes

Prefix | Use/Meaning
u_ | Instantiated components
g_ | Generate block labels
pr_ | Process names
v_ | Variable names
t_ | Type definition names
trec_ | Record type definition names
clk_ | Port or signal clock names
reset_ | Port or signal reset names
cnt_xx | A counter signal. E.g. cnt_packet, cnt_addr
G_ | An entity generic
S_ | A state name in a state-machine enumerated type
C_ | A constant (optional)
tb_ | Testbench file names

### Summary of Naming Suffixes

Prefix | Use/Meaning
_pkg.vhd | Package file name
_clk_name | Signal belonging to clock domain clk_name
_d or _d1, _d2 | Pipeline delayed versions of a signal
_msync1, _msync2 | Metastabilizing synchronizer, or s_xx_d1, s_xx_d2
_n | Asserted low signal
_i | Internal signal
n | Integer-type signal e.g.

## Coding styles

In general, if the code seems to contain a lot of replication, then there is probably a better and more maintainable way of doing it.

### Whitespace

Use 4 spaces for indentation – DO NOT use tabs.

Use consistent indentation throughout your code. It can get very confusing to the reader when the indentation is incorrect.

Only put one statement per line.

Apply consistent use of blank lines. Aim for a clean look in your code

### Line Length

It is preferred to keep the line lengths to approximately 80 – 100 characters. Going over 140 characters can start to impact the readability of the code.

### Comments in General

Use them; they are as important as the code that is compiled. Make them accurate and maintain them. The only thing worse than no comments are incorrect comments. Comments like "-- architecture rtl of blocka" or “-- std_logic_vector(5 downto 0)” or “-- adds 1 to the count” do not add value. You can optionally put type declaration comments in component instantiations.

Every process should have a comment. You wrote this process for a reason. What is the reason?

Comments are meant to help others understand what the code is doing.

Do not add lots of comments that do not apply directly to the code in the file. Long descriptions probably belong in the FPGA Specification.

### Comments on Port Signals

Port signals in component packages do not need comments.

Port signals in entity declarations must have normal comments. Organize signals into functional groups. It’s good (but not required) to use a blank line between functional groups. The elements of each port declaration should align vertically in the same functional group, but each functional group may have independent alignment.

Port signals in instances do not have to have comments. However, it is often very helpful for someone new to the design to see ‘in’ or ‘out’ as a comment, especially for top-level ports.

### Resets

Reset should be named reset or have a reset_ prefix.

Registers should use synchronous resets when possible.

All registers should be reset, unless there is some compelling reason not to.

Sometimes it is desirable to have a software-controlled reset that resets all the state machines and logic except for registers that are programmed by the CPU. This signal shall be named reset_dp.

### Signal Definition

In RTL, signals should not be given initial values when the signal is defined. This design technique is not portable. If the signal is a register, initialize it using reset. It’s OK to do this in the testbench.

### Active Low Signals

Don't use active low signals unless absolutely necessary. If there are input pads that are active low, just invert them as soon as you can. If an IP block has an active low port, then make sure you use _n on the end of the signal even if the IP port name doesn't. Some Xilinx memory blocks have an active low reset called reset. Drive this with a signal called reset_n.

### State machines

Use enumerated types for the state variable or signal. Then you can see the state names in the simulator and SignalTap or ChipScope. The type name is the state variable name with a t_ prefix. You can still get specific bit patterns for each state if you want to use them for debugging. The state names begin with S_ (enumerations are uppercase). If there is only one state machine in a file, use state for the variable name, otherwise use state_<name> format, where <name> describes the state machine.

-- Enumerated type for the system state variable

type t_state_sys is (S_SYS_START, S_SYS_WAIT, S_SYS_SHUTDOWN, S_SYS_DONE);

attribute enum_encoding of t_state_sys : type is "00 01 10 11"; -- optional

signal state_sys : t_state_sys;

There are two main methods of writing finite state machines (FSMs) in VHDL:

- Single synchronous process that does everything using one state variable signal.
- Two processes, one synch, one combinational, using a current state and a next state signal.

In general, use the first method. If practical, include registered control logic in the FSM process, so that the branch condition code is not duplicated in 2 process and so that the code is easier to understand.

Use two handshaking FSMs rather than an FSM within an FSM, unless trivial.

The main point is that the state machine is understandable and maintainable by someone other than you. Styles that make the code size smaller are generally better and more maintainable. If a single state machine is getting long and complicated, then maybe it’s better to break it up into smaller ones.

State machines should have all states defined. When using enum types and case statements have a “when others” state. This provides a way for the state machine to recover if ever gets in an undefined state.

### Port Record Types

Port record types should be used sparingly and only when they will aid in the use and understanding of the design. They should not be use in the ports of the top-level entity.

A record type for a CPU bus:

-- Record type for the CPU bus

type t_rec_cpubus is record

cs : std_logic_vector(15 downto 0);

rd : std_logic;

wr : std_logic;

adr : std_logic_vector(27 downto 0);

idat : std_logic_vector(31 downto 0);

odat : std_logic_vector(31 downto 0);

ack : std_logic;

end record;

signal cpubus : t_rec_cpubus;

### Process Sensitivity Lists

Clocked processes with a synchronous reset should only have the clock in the sensitivity list.

Clocked processes with an asynchronous reset should only have the clock and the async reset in the sensitivity list before the clock. NOTE: this is stated for completeness, but in general, all registers should use synchronous resets, not asynchronous resets.

Avoid inferred latches with a complete list or use ‘process (all)’.

Write processes so that they do not need a huge sensitivity list.

### Common Functions Like Rounding and Saturation

Common functions should be put into a package so that multiple blocks can use the same functions. This will ensure that there is a consistency in the way that rounding and saturation are done.

### Common Error & Status Strategy

Implement a common way across the ASIC/FPGAs in a product to latch and report error and status conditions. Ensure that the documentation makes it clear for the software engineer to be able to follow an interupt to all of its possible causes.

In general, prevent counters, pointers, FIFOs, etc from overflowing.

In general, attempt to detect and flag error conditions.

### Test Features and Overrides

Ensure that if there are lockout mechanisms, that there are also test features which allow the lockouts to be overridden.

### Stale or Commented Out Code

Remove old code and signals that are not used.

Do not just comment out code – remove it. Configuration management should be used to go back and look at prior versions of the code.

Preferably have a tool which checks this in simulation or a Linting tool which detects this.

### Signals in an Unknown State

In general, all signals should always be driven to known state unless there’s a good reason not to be. When this cannot be avoided, then attempt to control the spread of the unknown signals by conditioning those signals with ones that are known. For example, a RAM output may be unknown, so that RAM output should not be the default value muxed onto a CPU read back bus.

### Use Arrays and Loops

Use array variables instead of replicating variables. Also use looping with these arrays instead of having replicated code. Use upper-case for loop variables. For example, use:

Constant SC_MAX_LINE : integer := 4;

type t_arr_sc_lines is array (0 to SC_MAX_LINE) of std_logic_vector(31 downto 0);

signal arr_sc_lines : t_arr_sc_lines;

arr_sc_lines(0) <= new_line;

for I in 1 to SC_MAX_LINE loop

arr_sc_lines(I) <= arr_sc_lines(I – 1);

end loop;

Instead of:

signal sc_lines0 : std_logic_vector(31 downto 0);

signal sc_lines1 : std_logic_vector(31 downto 0);

signal sc_lines2 : std_logic_vector(31 downto 0);

signal sc_lines3 : std_logic_vector(31 downto 0);

sc_lines0 <= new_line;

sc_line1 <= sc_lines0;

scline2 <= sc_line1;

scline3 <= sc_line2;

### Generate Statements

Use generate statements to create arrays of components rather than individually replicating them. The purpose for doing this is to make the code more understandable and maintainable – if this causes the code to become convoluted due to strange port mapping of bit, then maybe a generate statement isn’t the way to go.

### File Naming

VHDL filenames should match the entity or package name with a .vhd extension.

If there is a file with an alternative architecture then it should append the architecture name to the basename of the file. For example, the file containing the dummy architecture for blocka would be blocka_dummy.vhd.

In general, the architecture and entity definitions for an entity should be in one file named entity.vhd. Names of testbench files should use the ‘tb_’ prefix.

### No Internal Tri-states

Enough said.

### Multiple Clocks

Preferably there is only one clock per entity. (Even better – only one clock in the entire FPGA.) If there is more than one clock, then the clock domains should be easily identifiable.

### RAM Enables

Enables on RAMs often provide a power down feature so the enables should always be controlled so that the RAMs are not enabled when they are not actively being read or written.

### Use of Libraries

When using packages from a library that the source is compiled into, use “work” instead of the library name:

use work.my_pkg;

Don’t use:

library quark;

use quark.my_pkg;

Work has the special meaning of the current library.

### Use of Clock Edge Functions for Clocked Processes

Clocked processes should use the newer rising_edge() and falling_edge() functions instead of the older “clk = 1 and clk’event”. The newer method is easier to read and is easier to search on to find clocked processes. It also makes it much easier to find negative edge clocked processes. Although the falling edge clocked processes should be avoided.

### Reasonable Limits on Process, Function and File Sizes

Excessively long processes, functions and/or file sizes are not very conducive to understanding or maintenance of the code. Break things up logically so they are easily understood by others.

### End of Lines

Each source code line should end with a Line Feed ASCII character (0x0A) only, instead of Carriage Return and Line Feed ASCII characters (0x0D 0x0A). Unix instead of DOS endings.

### Hold vs. Latch

When a synchronous process samples a signal at one time and clears it at another, it helps to name the signal with the suffix ‘_hold’. Do not use ‘_latch’. The string “latch” is misleading for a synchronous design.

## Coding Examples

Note use of whitespace and column alignment.

### CPU Registers – Read/Write Control

Use a single process to implement CPU reading and writing of registers.

Define your register addresses in constants either locally in the file, in a package for the block or in a package for the device.

At the top of the architecture:

-- Register addresses

constant ADR_CTLSTATUS : std_logic_vector (3 downto 0) := X"0";

constant ADR_CMDIDX : std_logic_vector (3 downto 0) := X"1";

constant ADR_CMDARG : std_logic_vector (3 downto 0) := X"2";

Register access process:

-- Write and read registers

pr_regs_rw : process(clk)

begin

if rising_edge(clk) then

if (reset = '1') then

reg_ctrlstatus <= (others=>'0');

reg_cmdidx <= (others=>'0');

reg_cmsarg <= (others=>'0');

regbus_rd_dat <= (others=>'0');

regbus_rd_dv <= '0';

elsif (regbus_sel = '1') and (regbus_wr = '1') then

case regbus_adr is

when ADR_CTLSTATUS => reg_ctrlstatus <= regbus_wr_dat(29 downto 0);

when ADR_CMDIDX => reg_cmdidx <= regbus_wr_dat(12 downto 0);

when ADR_CMDARG => reg_cmdarg <= regbus_wr_dat;

when others => null;

end case;

regbus_rd_dat <= (others=>'0');

elsif (sd_reg_sel = '1') and (regbus_wr = '0') then

case regbus_adr is

when ADR_CTLSTATUS => regbus_rd_dat <= reg_ctrlstatus;

when ADR_CMDIDX => regbus_rd_dat <= reg_cmdidx;

when ADR_CMDARG => regbus_rd_dat <= reg_cmdarg;

when others => regbus_rd_dat <= CODE_ERROR_ADR; -- (from package)

end case;

regbus_rd_dv <= '1';

else

regbus_rd_dv <= ‘0’;

end if;

end if;

end process;

Outside of the register read/write process assign the register bits to individual signals.

-- Assign register bits (37 signals)

sd_rdfifo_flush <= reg_ctrlstatus(29);

sd_wrfifo_flush <= reg_ctrlstatus(28);

clr_sd_xmit_dat_done <= reg_ctrlstatus(27);

clr_sd_rcv_dat_done <= reg_ctrlstatus(26);

sd_rate_select <= reg_ctrlstatus(25 downto 24);

rcvd_dat3_crc_err <= reg_ctrlstatus(23);

sd_fpga_core_en <= reg_ctrlstatus(0);

sd_cmd_go_reg <= reg_cmdidx(12);

sd_cmd_exp_resp(31) <= reg_cmdidx(8);

sd_cmd_index <= reg_cmdidx(5 downto 0);

sd_cmd_argument <= reg_cmdarg;

### Use ‘range for Signal Declarations

When creating signals that that are functionally related to another signal port (i.e. they will have the same bit width range), then use the ‘range to replicate the range of another signal or port.

entity top is

…

data_in : in std_logic_vector(12 downto 0);

…

signal my_data_in : std_logic_vector(data_in’range);

This will reduce the number of places that have to be modified if the width of the input changes.

### Use IEEE Standard Functions Where Possible

Don’t recreate a function that already exists in IEEE packages. However, see guidelines below for arithmetic functions. See appendix in this document.

### For Arithmetic Functions, Use ieee.numeric_std Package

For all arithmetic functions use the newer ieee.numeric_std package. It is preferred to declare all signals and ports that represent signed or unsigned values as the appropriate signed or unsigned types (except at the top level of the chip, where all ports should be std_logic or std_logic_vector). Doing so will minimize the amount of type conversion and help clarify the type of value that is represented.

numeric_std provides +, -, *, /, rem, mod, <, >, <=, >=, =, /=, shift_left, shift_right, rotate_left, rotate_right, resize and conversion functions.

### Do not Use std_logic_arith, std_logic_unsigned or std_logic_signed

These packages are non-standard and were deprecated in 1993 (!!). They were vendor specific libraries (from Cadence, Mentor or Synopsys) and should never have been compiled into the IEEE libraries.

### Use resize() to Extend Signals

When assigning a shorter signal to a longer one, use the resize() function rather than hard coding a fixed length bit vector of zeros. For example, use:

rd_dat <= resize(my_signed_val, 32);

rd_dat <= resize(my_unsigned_val, 32);

or better yet:

rd_dat <= resize(my_signed_val, rd_dat’length);

rd_dat <= resize(my_unsigned_val, rd_dat’length);

### Use *_reduce() Functions in IEEE Packages for std_logic_vectors

The std_logic_misc package defines the reduce logic functions for std_logic_vectors as follows:

any_bit_set <= or_reduce(my_slv)

## Productivity Tools

## Find X’s in Simulation - TODO

Have a script that can find and report all X’s a number of clocks after reset. The tool would need a way to know when to stop looking, so that it doesn’t go into vendor cells. It would also need a way to indicated known X’s – i.e. a suppression file.

# 3. IEEE Package Functions

PACKAGE std_logic_1164 IS

FUNCTION "and" ( l : std_ulogic; r : std_ulogic ) RETURN UX01;

FUNCTION "nand" ( l : std_ulogic; r : std_ulogic ) RETURN UX01;

FUNCTION "or" ( l : std_ulogic; r : std_ulogic ) RETURN UX01;

FUNCTION "nor" ( l : std_ulogic; r : std_ulogic ) RETURN UX01;

FUNCTION "xor" ( l : std_ulogic; r : std_ulogic ) RETURN UX01;

function "xnor" ( l : std_ulogic; r : std_ulogic ) return ux01;

FUNCTION "not" ( l : std_ulogic ) RETURN UX01;

FUNCTION "and" ( l, r : std_logic_vector ) RETURN std_logic_vector;

FUNCTION "and" ( l, r : std_ulogic_vector ) RETURN std_ulogic_vector;

FUNCTION "nand" ( l, r : std_logic_vector ) RETURN std_logic_vector;

FUNCTION "nand" ( l, r : std_ulogic_vector ) RETURN std_ulogic_vector;

FUNCTION "or" ( l, r : std_logic_vector ) RETURN std_logic_vector;

FUNCTION "or" ( l, r : std_ulogic_vector ) RETURN std_ulogic_vector;

FUNCTION "nor" ( l, r : std_logic_vector ) RETURN std_logic_vector;

FUNCTION "nor" ( l, r : std_ulogic_vector ) RETURN std_ulogic_vector;

FUNCTION "xor" ( l, r : std_logic_vector ) RETURN std_logic_vector;

FUNCTION "xor" ( l, r : std_ulogic_vector ) RETURN std_ulogic_vector;

function "xnor" ( l, r : std_logic_vector ) return std_logic_vector;

function "xnor" ( l, r : std_ulogic_vector ) return std_ulogic_vector;

FUNCTION "not" ( l : std_logic_vector ) RETURN std_logic_vector;

FUNCTION "not" ( l : std_ulogic_vector ) RETURN std_ulogic_vector;

FUNCTION To_bit ( s : std_ulogic; xmap : BIT := '0') RETURN BIT;

FUNCTION To_bitvector ( s : std_logic_vector ; xmap : BIT := '0') RETURN BIT_VECTOR;

FUNCTION To_bitvector ( s : std_ulogic_vector; xmap : BIT := '0') RETURN BIT_VECTOR;

FUNCTION To_StdULogic ( b : BIT ) RETURN std_ulogic;

FUNCTION To_StdLogicVector ( b : BIT_VECTOR ) RETURN std_logic_vector;

FUNCTION To_StdLogicVector ( s : std_ulogic_vector ) RETURN std_logic_vector;

FUNCTION To_StdULogicVector ( b : BIT_VECTOR ) RETURN std_ulogic_vector;

FUNCTION To_StdULogicVector ( s : std_logic_vector ) RETURN std_ulogic_vector;

FUNCTION To_X01 ( s : std_logic_vector ) RETURN std_logic_vector;

FUNCTION To_X01 ( s : std_ulogic_vector ) RETURN std_ulogic_vector;

FUNCTION To_X01 ( s : std_ulogic ) RETURN X01;

FUNCTION To_X01 ( b : BIT_VECTOR ) RETURN std_logic_vector;

FUNCTION To_X01 ( b : BIT_VECTOR ) RETURN std_ulogic_vector;

FUNCTION To_X01 ( b : BIT ) RETURN X01;

FUNCTION To_X01Z ( s : std_logic_vector ) RETURN std_logic_vector;

FUNCTION To_X01Z ( s : std_ulogic_vector ) RETURN std_ulogic_vector;

FUNCTION To_X01Z ( s : std_ulogic ) RETURN X01Z;

FUNCTION To_X01Z ( b : BIT_VECTOR ) RETURN std_logic_vector;

FUNCTION To_X01Z ( b : BIT_VECTOR ) RETURN std_ulogic_vector;

FUNCTION To_X01Z ( b : BIT ) RETURN X01Z;

FUNCTION To_UX01 ( s : std_logic_vector ) RETURN std_logic_vector;

FUNCTION To_UX01 ( s : std_ulogic_vector ) RETURN std_ulogic_vector;

FUNCTION To_UX01 ( s : std_ulogic ) RETURN UX01;

FUNCTION To_UX01 ( b : BIT_VECTOR ) RETURN std_logic_vector;

FUNCTION To_UX01 ( b : BIT_VECTOR ) RETURN std_ulogic_vector;

FUNCTION To_UX01 ( b : BIT ) RETURN UX01;

FUNCTION rising_edge (SIGNAL s : std_ulogic) RETURN BOOLEAN;

FUNCTION falling_edge (SIGNAL s : std_ulogic) RETURN BOOLEAN;

FUNCTION Is_X ( s : std_ulogic_vector ) RETURN BOOLEAN;

FUNCTION Is_X ( s : std_logic_vector ) RETURN BOOLEAN;

FUNCTION Is_X ( s : std_ulogic ) RETURN BOOLEAN;

END std_logic_1164;

package std_logic_misc is

function AND_REDUCE (ARG: STD_LOGIC_VECTOR) return UX01;

function NAND_REDUCE(ARG: STD_LOGIC_VECTOR) return UX01;

function OR_REDUCE (ARG: STD_LOGIC_VECTOR) return UX01;

function NOR_REDUCE (ARG: STD_LOGIC_VECTOR) return UX01;

function XOR_REDUCE (ARG: STD_LOGIC_VECTOR) return UX01;

function XNOR_REDUCE(ARG: STD_LOGIC_VECTOR) return UX01;

function AND_REDUCE (ARG: STD_ULOGIC_VECTOR) return UX01;

function NAND_REDUCE(ARG: STD_ULOGIC_VECTOR) return UX01;

function OR_REDUCE (ARG: STD_ULOGIC_VECTOR) return UX01;

function NOR_REDUCE (ARG: STD_ULOGIC_VECTOR) return UX01;

function XOR_REDUCE (ARG: STD_ULOGIC_VECTOR) return UX01;

function XNOR_REDUCE(ARG: STD_ULOGIC_VECTOR) return UX01;

end std_logic_misc;

PACKAGE numeric_std IS

function "abs" (ARG: SIGNED) return SIGNED;

function "-" (ARG: SIGNED) return SIGNED;

function "+" (L, R: UNSIGNED) return UNSIGNED;

function "+" (L, R: SIGNED) return SIGNED;

function "+" (L: UNSIGNED; R: NATURAL) return UNSIGNED;

function "+" (L: NATURAL; R: UNSIGNED) return UNSIGNED;

function "+" (L: INTEGER; R: SIGNED) return SIGNED;

function "+" (L: SIGNED; R: INTEGER) return SIGNED;

function "-" (L, R: UNSIGNED) return UNSIGNED;

function "-" (L, R: SIGNED) return SIGNED;

function "-" (L: UNSIGNED;R: NATURAL) return UNSIGNED;

function "-" (L: NATURAL; R: UNSIGNED) return UNSIGNED;

function "-" (L: SIGNED; R: INTEGER) return SIGNED;

function "-" (L: INTEGER; R: SIGNED) return SIGNED;

function "*" (L, R: UNSIGNED) return UNSIGNED;

function "*" (L, R: SIGNED) return SIGNED;

function "*" (L: UNSIGNED; R: NATURAL) return UNSIGNED;

function "*" (L: NATURAL; R: UNSIGNED) return UNSIGNED;

function "*" (L: SIGNED; R: INTEGER) return SIGNED;

function "*" (L: INTEGER; R: SIGNED) return SIGNED;

function "/" (L, R: UNSIGNED) return UNSIGNED;

function "/" (L, R: SIGNED) return SIGNED;

function "/" (L: UNSIGNED; R: NATURAL) return UNSIGNED;

function "/" (L: NATURAL; R: UNSIGNED) return UNSIGNED;

function "/" (L: SIGNED; R: INTEGER) return SIGNED;

function "/" (L: INTEGER; R: SIGNED) return SIGNED;

function "rem" (L, R: UNSIGNED) return UNSIGNED;

function "rem" (L, R: SIGNED) return SIGNED;

function "rem" (L: UNSIGNED; R: NATURAL) return UNSIGNED;

function "rem" (L: NATURAL; R: UNSIGNED) return UNSIGNED;

function "rem" (L: SIGNED; R: INTEGER) return SIGNED;

function "rem" (L: INTEGER; R: SIGNED) return SIGNED;

function "mod" (L, R: UNSIGNED) return UNSIGNED;

function "mod" (L, R: SIGNED) return SIGNED;

function "mod" (L: UNSIGNED; R: NATURAL) return UNSIGNED;

function "mod" (L: NATURAL; R: UNSIGNED) return UNSIGNED;

function "mod" (L: SIGNED; R: INTEGER) return SIGNED;

function "mod" (L: INTEGER; R: SIGNED) return SIGNED;

function ">" (L, R: UNSIGNED) return BOOLEAN;

function ">" (L, R: SIGNED) return BOOLEAN;

function ">" (L: NATURAL; R: UNSIGNED) return BOOLEAN;

function ">" (L: INTEGER; R: SIGNED) return BOOLEAN;

function ">" (L: UNSIGNED; R: NATURAL) return BOOLEAN;

function ">" (L: SIGNED; R: INTEGER) return BOOLEAN;

function "<" (L, R: UNSIGNED) return BOOLEAN;

function "<" (L, R: SIGNED) return BOOLEAN;

function "<" (L: NATURAL; R: UNSIGNED) return BOOLEAN;

function "<" (L: INTEGER; R: SIGNED) return BOOLEAN;

function "<" (L: UNSIGNED; R: NATURAL) return BOOLEAN;

function "<" (L: SIGNED; R: INTEGER) return BOOLEAN;

function "<=" (L, R: UNSIGNED) return BOOLEAN;

function "<=" (L, R: SIGNED) return BOOLEAN;

function "<=" (L: NATURAL; R: UNSIGNED) return BOOLEAN;

function "<=" (L: INTEGER; R: SIGNED) return BOOLEAN;

function "<=" (L: UNSIGNED; R: NATURAL) return BOOLEAN;

function "<=" (L: SIGNED; R: INTEGER) return BOOLEAN;

function ">=" (L, R: UNSIGNED) return BOOLEAN;

function ">=" (L, R: SIGNED) return BOOLEAN;

function ">=" (L: NATURAL; R: UNSIGNED) return BOOLEAN;

function ">=" (L: INTEGER; R: SIGNED) return BOOLEAN;

function ">=" (L: UNSIGNED; R: NATURAL) return BOOLEAN;

function ">=" (L: SIGNED; R: INTEGER) return BOOLEAN;

function "=" (L, R: UNSIGNED) return BOOLEAN;

function "=" (L, R: SIGNED) return BOOLEAN;

function "=" (L: NATURAL; R: UNSIGNED) return BOOLEAN;

function "=" (L: INTEGER; R: SIGNED) return BOOLEAN;

function "=" (L: UNSIGNED; R: NATURAL) return BOOLEAN;

function "=" (L: SIGNED; R: INTEGER) return BOOLEAN;

function "/=" (L, R: UNSIGNED) return BOOLEAN;

function "/=" (L, R: SIGNED) return BOOLEAN;

function "/=" (L: NATURAL; R: UNSIGNED) return BOOLEAN;

function "/=" (L: INTEGER; R: SIGNED) return BOOLEAN;

function "/=" (L: UNSIGNED; R: NATURAL) return BOOLEAN;

function "/=" (L: SIGNED; R: INTEGER) return BOOLEAN;

function SHIFT_LEFT (ARG: UNSIGNED; COUNT: NATURAL) return UNSIGNED;

function SHIFT_RIGHT (ARG: UNSIGNED; COUNT: NATURAL) return UNSIGNED;

function SHIFT_LEFT (ARG: SIGNED; COUNT: NATURAL) return SIGNED;

function SHIFT_RIGHT (ARG: SIGNED; COUNT: NATURAL) return SIGNED;

function ROTATE_LEFT (ARG: UNSIGNED; COUNT: NATURAL) return UNSIGNED;

function ROTATE_RIGHT (ARG: UNSIGNED; COUNT: NATURAL) return UNSIGNED;

function ROTATE_LEFT (ARG: SIGNED; COUNT: NATURAL) return SIGNED;

function ROTATE_RIGHT (ARG: SIGNED; COUNT: NATURAL) return SIGNED;

function "sll" (ARG: UNSIGNED; COUNT: INTEGER) return UNSIGNED;

function "sll" (ARG: SIGNED; COUNT: INTEGER) return SIGNED;

function "srl" (ARG: UNSIGNED; COUNT: INTEGER) return UNSIGNED;

function "srl" (ARG: SIGNED; COUNT: INTEGER) return SIGNED;

function "rol" (ARG: UNSIGNED; COUNT: INTEGER) return UNSIGNED;

function "rol" (ARG: SIGNED; COUNT: INTEGER) return SIGNED;

function "ror" (ARG: UNSIGNED; COUNT: INTEGER) return UNSIGNED;

function "ror" (ARG: SIGNED; COUNT: INTEGER) return SIGNED;

function RESIZE (ARG: SIGNED; NEW_SIZE: NATURAL) return SIGNED;

function RESIZE (ARG: UNSIGNED; NEW_SIZE: NATURAL) return UNSIGNED;

function TO_INTEGER (ARG: UNSIGNED) return NATURAL;

function TO_INTEGER (ARG: SIGNED) return INTEGER;

function TO_UNSIGNED (ARG, SIZE: NATURAL) return UNSIGNED;

function TO_SIGNED (ARG: INTEGER; SIZE: NATURAL) return SIGNED;

function "not" (L: UNSIGNED) return UNSIGNED;

function "and" (L, R: UNSIGNED) return UNSIGNED;

function "or" (L, R: UNSIGNED) return UNSIGNED;

function "nand" (L, R: UNSIGNED) return UNSIGNED;

function "nor" (L, R: UNSIGNED) return UNSIGNED;

function "xor" (L, R: UNSIGNED) return UNSIGNED;

function "xnor" (L, R: UNSIGNED) return UNSIGNED;

function "not" (L: SIGNED) return SIGNED;

function "and" (L, R: SIGNED) return SIGNED;

function "or" (L, R: SIGNED) return SIGNED;

function "nand" (L, R: SIGNED) return SIGNED;

function "nor" (L, R: SIGNED) return SIGNED;

function "xor" (L, R: SIGNED) return SIGNED;

function "xnor" (L, R: SIGNED) return SIGNED;

function STD_MATCH (L, R: STD_ULOGIC) return BOOLEAN;

function STD_MATCH (L, R: UNSIGNED) return BOOLEAN;

function STD_MATCH (L, R: SIGNED) return BOOLEAN;

function STD_MATCH (L, R: STD_LOGIC_VECTOR) return BOOLEAN;

function STD_MATCH (L, R: STD_ULOGIC_VECTOR) return BOOLEAN;

function TO_01 (S: UNSIGNED; XMAP: STD_LOGIC := '0') return UNSIGNED;

function TO_01 (S: SIGNED; XMAP: STD_LOGIC := '0') return SIGNED;

# 4. Appendix

## Abbreviations

General rule is not to abbreviate if the name is short or if it ends up cryptic. It’s OK to not abbreviate; for example, master vs. mstr. Do not remove one character to shorten a 5+ character word if it ends up being cryptic. For instance, changing ‘burst’ to ‘brst’ has one thinking of ‘b_reset’, ‘branch_state’, etc. and offers no significant savings in length.

Example abbreviations:

enable : ena

disable : dis

reset : rst

block : blk

control : ctrl

status : stat

command : cmd

register : reg

definition : defn

information : info

configuration : cfg/config

revision : rev

initialization : init

select : sel

clock : clk

address : addr/adr

data : data

strobe : stb

input : in

output : out

write : wr

read : rd

array : arr

pointer : ptr

index : idx

count : cnt

counter : cntr

header : hdr

delay : dly

coefficient : coef/coeff

format : fmt

sample : smp/smpl

trigger : trig

detection : det

threshold : thresh

round : rnd

saturate : sat

result : rslt

buffer : buff

burst : burst

blank : blank

compress : cmpr

decompress : decmpr

encode : enc

decode : dec if context clear from decrement : dec

load : ld

increment : inc/incr

decrement : dec/decr

decimate : decim

accumulator : acc

multiplier : mult

divisor : div

average : avg

interrupt : int

interval : interv

frequency : freq

period : per

amplitude : amp/ampl

random : rand not rndm

sequence : seq

period : per

count : cnt

length : len

size : size

width : width not wd, looks like word

filter : filter not flt, looks like float/fleet/fillet/flat

default : default not dflt, looks like deflate

notify : notify not ntfy, looks like not-fully/nifty

test : tst

shift : shift not shft

shift_reg : sreg

time : time perhaps use count instead

depth : depth

idle : idle

overflow : ovfl

underflow : undfl

empty : empty/mt

almostfull : af

full : full

master : mstr

slave : slave slv is standard_logic_vector

start : start not strt, looks like straight

stop : stop

flag : flag

data : data

error : err

locked : locked

software : sw

hardware : hw

request : req

grant : gnt

arbitrate : arb

packet : pkt

on : on

off : off

offset : ofs

wobbler : wob

calibration : cal

number : num

first : first/1

second : sec(time) or second/2(number)

Rev: A VHDL Coding Styles Page: 14 of 24
