uw-acme/NANO_QLASER/documents/PulseChannel.pdf

External Trigger
(pushbutton)

read addr

JESD204B
differential data to
HPC FMC
connector, then to
Abaco board

100 Mhz CPU bus for register setting and RAM loading

Common
to all
channels

read addr

JESD
204B

Tx,Phy AXI-STREAM

Pulse Channel Control
process pr_sm_pulse_channel

CPU Trigger
(from PS)

RAM
dout

RAM
dout

start_pulse

24-bit
counter

=

# Laser Control FPGA Block Diagram of one JESD DAC channel (FPGA contains 32 channels)

Pulse Position table is loaded with up to eight 24-bit pulse start times.
(Pulse durations too?)

Waveform table is loaded with up to 1024 16-bit DAC values that define the pulse shape.

Pulse Channel Control waits for a CPU trigger or an External trigger. Once a trigger is seen it reads address 0 from the PulsePosition table. When the external 24-bit count reached the table value a start_pulse is generated and the controller then reads the entire waveform table in one burst. The table output is converted into an AXI stream and sent to the JESD Transmit block.
The read address of the Pulse Position table is incremented and the Controller waits for the next start_pulse the outpus the waveform table again.

The data_to_stream block uses a FIFO to buffer the waveform data and supplies AXI-stream data to the JESD block. The JESD block could apply ‘backpressure’ using the axi_s bus tready signal to pause the data.

CPU bus
(cs,rd,wr,addr, din,dout

AXI-Stream bus

UW code blocks

Xilinx IP blocks (addnl license)

Xilinx IP blocks (Standard)

JESD bus

qlaser_dacs_pulse_channel

data_to_stream

comparator

RAM
PulsePosition
table
8w x 24-bit

axi_stream
t_ready

sm
fifo

FIFO RAM Waveform table
1024w x 16-bit

fifo_ready fifo_write

status?
