uw-acme/NANO_QLASER/documents/TB_PulseChannel.pdf

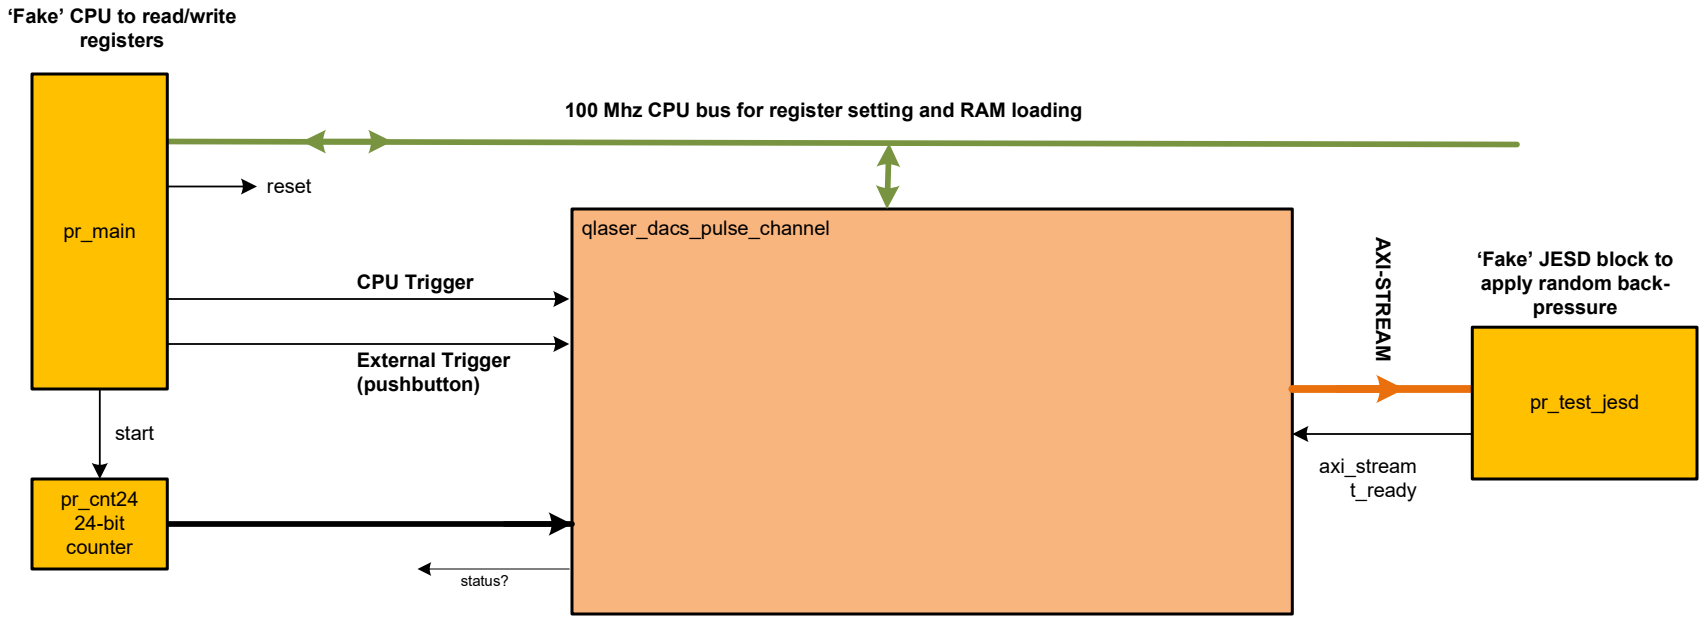
[picture p24: figure]
External Trigger (pushbutton); pr_cnt24 24-bit counter; axi_stream t_ready; status?; pr_test_jesd; ‘Fake’ JESD block to apply random back- pressure; pr_main; ‘Fake’ CPU to read/write registers; qlaser_dacs_pulse_channel; reset; start

100 Mhz CPU bus for register setting and RAM loading | AXI-STREAM CPU Trigger

# Laser Control FPGA Test bench for one JESD DAC channel

The pr_main proess:c

Generates the reset signal.
Tests the register and RAM read/write then programs the RAMs. Generates the counter ‘start’ and the trigger to the pulse_channel block.

Observe waveform data on AXI-Stream output.

pr_test_jesd block could keep ‘tready’ high initially then after intial debugging could apply backpressure to test that feature.

Second step would be to use a model of the JESD block to replace pr_test_jesd

Third step would be to use a VHDL generate statement to instantiate 32 copies of the pulse channel block.

CPU bus
(cs,rd,wr,addr, din,dout

AXI-Stream bus

UW code blocks

Xilinx IP blocks (addnl license)

Xilinx IP blocks (Standard)

Process to generate
100MHz clock for all
testbench blocks

pr_clk

clk
