uw-acme/NANO_QLASER/tools/xilinx/zcu102/jesd0.pdf

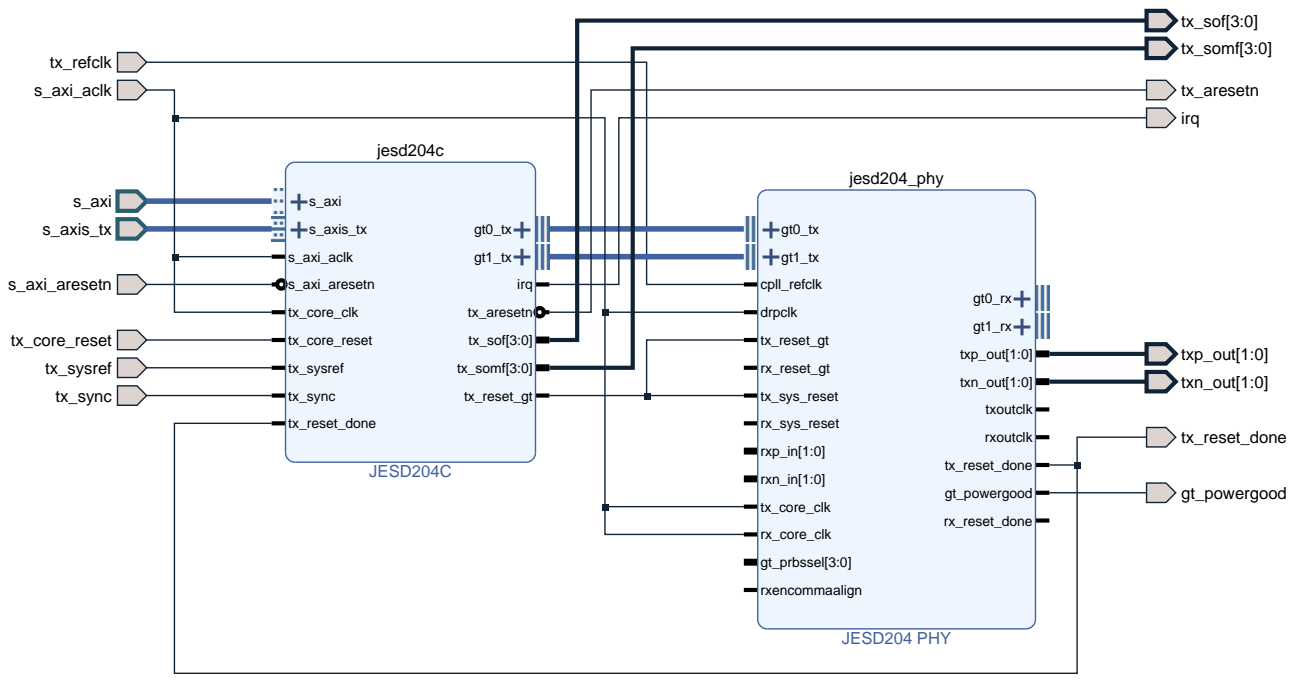
[picture p25: figure]
tx_refclk s_axi_aclk; s_axi s_axis_tx; s_axi_aresetn; tx_core_reset tx_sysref tx_sync; jesd204c; JESD204C; s_axi; s_axis_tx; s_axi_aclk; tx_core_clk; tx_core_reset; tx_sysref; irq; tx_aresetn; tx_sof[3:0]; tx_somf[3:0]; tx_sync; tx_reset_gt; tx_reset_done; jesd204_phy; JESD204 PHY; cpll_refclk; drpclk; rx_reset_gt; tx_sys_reset; rx_sys_reset; txp_out[1:0]; txn_out[1:0]; rxp_in[1:0]; rxn_in[1:0]; rx_core_clk; txoutclk; rxoutclk; gt_prbssel[3:0]; gt_powergood; rx_reset_done; rxencommaalign; tx_sof[3:0] tx_somf[3:0]; tx_aresetn irq; txp_out[1:0] txn_out[1:0]
