uw-acme/NANO_QLASER/documents/Laser-Control-Board-Usage.pdf

# Laser Control FPGA Block Diagram 32 DC 12-bit, 32 Pulse 0-1 (3.3V)

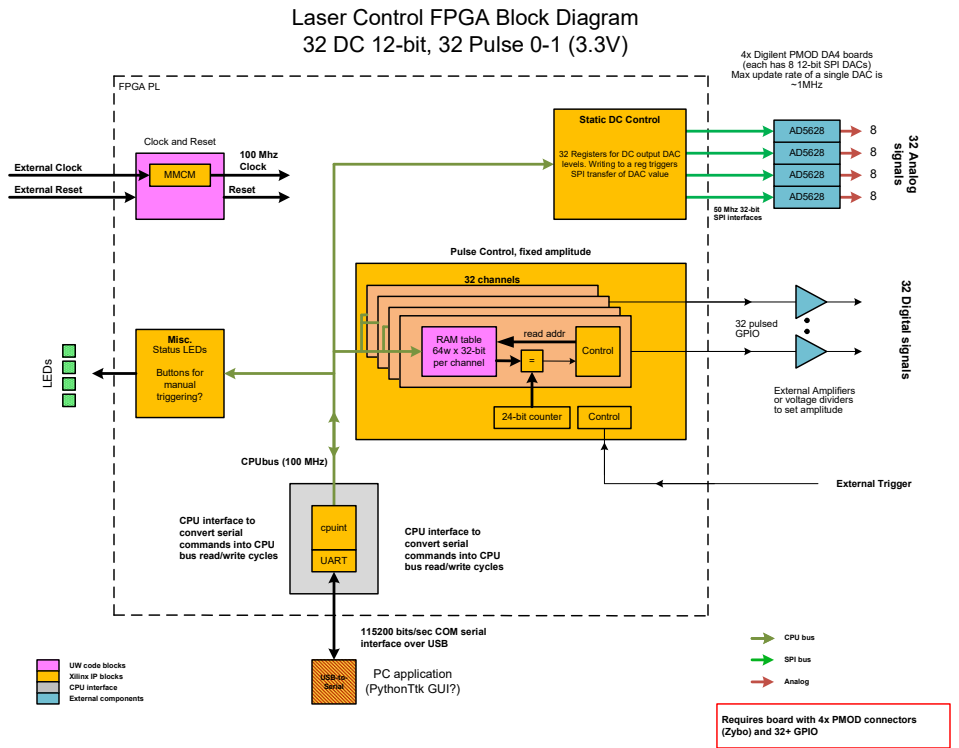
[picture p32: page 1]
USB-to- Serial; UART; FPGA PL; PC application (PythonTtk GUI?); 32 pulsed GPIO; CPUbus (100 MHz); 50 Mhz 32-bit; SPI interfaces; 32 Analog signals; ~1MHz; External Clock; External Reset; 100 Mhz Clock; Reset; SPI transfer of DAC value; 32 Digital signals; MMCM; External Trigger; cpuint; Status LEDs; Buttons for manual triggering?; Misc.; 24-bit counter; 32 channels LEDs; Control; RAM table 64w x 32-bit; per channel; read addr; CPU bus; SPI bus; Analog

4x Digilent PMOD DA4 boards
(each has 8 12-bit SPI DACs)
Max update rate of a single DAC is

Static DC Control

Clock and Reset

32 Registers for DC output DAC
levels. Writing to a reg triggers

Pulse Control, fixed amplitude

External Amplifiers
or voltage dividers
to set amplitude

CPU interface to
convert serial
commands into CPU
bus read/write cycles

115200 bits/sec COM serial
interface over USB

UW code blocks
Xilinx IP blocks
CPU interface
External components

Requires board with 4x PMOD connectors
(Zybo) and 32+ GPIO

# 32 DC 12-bit, 4 Pulse 14-bit

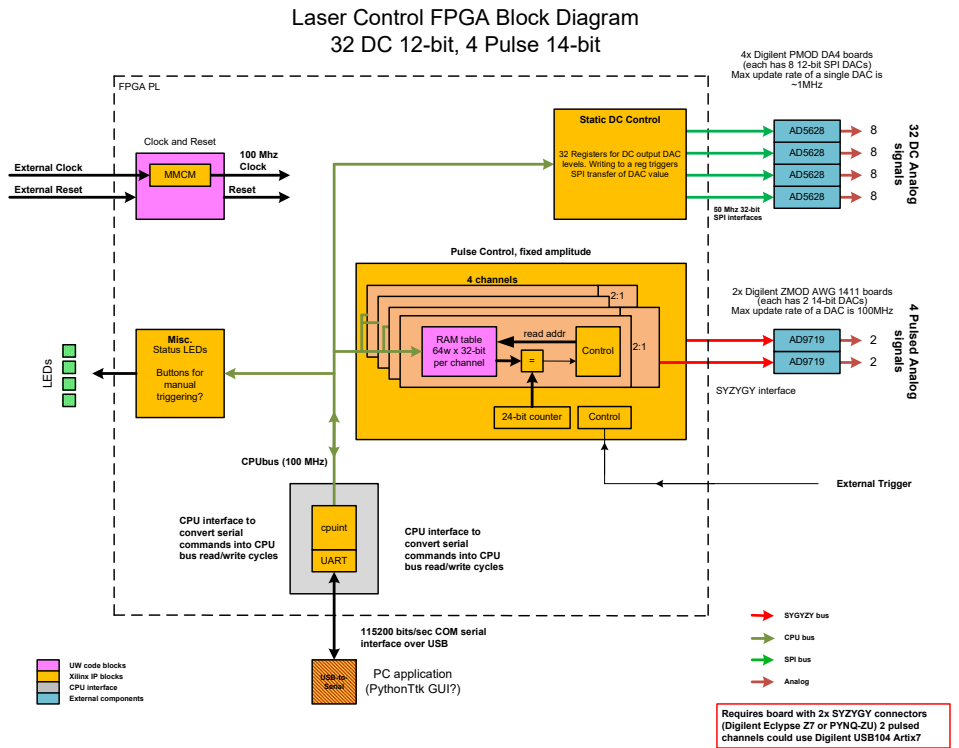
[picture p33: page 2]
USB-to-; UART; FPGA PL; PC application; CPUbus (100 MHz); CPU bus; 50 Mhz 32-bit; SPI interfaces; 32 DC Analog signals; ~1MHz; External Clock; External Reset; 100 Mhz Clock; Reset; SPI transfer of DAC value; 4 Pulsed Analog signals; MMCM; External Trigger; cpuint; Status LEDs; Buttons for manual triggering?; Misc.; 24-bit counter; 4 channels LEDs; Control; RAM table 64w x 32-bit; per channel; read addr; SYZYGY interface; SPI bus; Analog; SYGYZY bus

(each has 8 12-bit SPI DACs)
Max update rate of a single DAC is

Static DC Control

Clock and Reset

32 Registers for DC output DAC
levels. Writing to a reg triggers

Pulse Control, fixed amplitude

2x Digilent ZMOD AWG 1411 boards
(each has 2 14-bit DACs)
Max update rate of a DAC is 100MHz

CPU interface to
convert serial
commands into CPU
bus read/write cycles

115200 bits/sec COM serial
interface over USB

UW code blocks
Xilinx IP blocks

Requires board with 2x SYZYGY connectors
(Digilent Eclypse Z7 or PYNQ-ZU) 2 pulsed
channels could use Digilent USB104 Artix7

# 32 DC 12-bit, 32 Pulse 16-bit

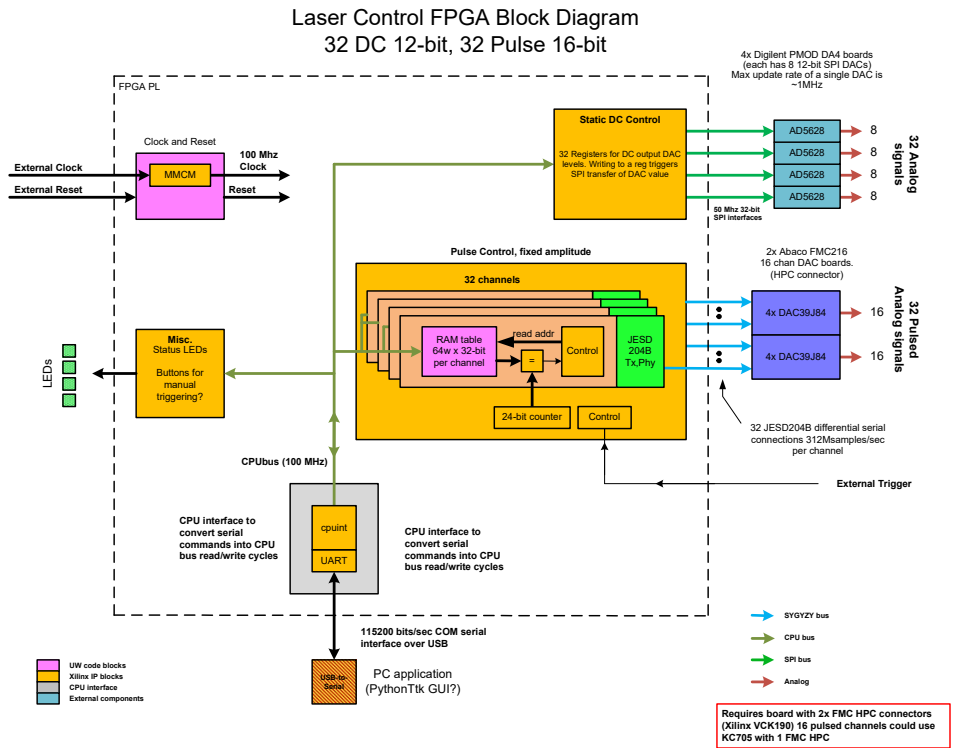
[picture p34: page 3]
JESD 204B Tx,Phy; USB-to-; UART; FPGA PL; PC application; CPUbus (100 MHz); CPU bus; SPI bus; Analog; 50 Mhz 32-bit; SPI interfaces; 32 Analog signals; ~1MHz; External Clock; External Reset; 100 Mhz Clock; Reset; SPI transfer of DAC value; 32 Pulsed Analog signals; MMCM; External Trigger; cpuint; Status LEDs; Buttons for manual triggering?; Misc.; 32 channels LEDs; Control; RAM table 64w x 32-bit; per channel; read addr; 24-bit counter; 4x DAC39J84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

(each has 8 12-bit SPI DACs)
Max update rate of a single DAC is

Static DC Control

Clock and Reset

32 Registers for DC output DAC
levels. Writing to a reg triggers

Pulse Control, fixed amplitude

2x Abaco FMC216
16 chan DAC boards.
(HPC connector)

CPU interface to
convert serial
commands into CPU
bus read/write cycles

115200 bits/sec COM serial
interface over USB

UW code blocks
Xilinx IP blocks

Requires board with 2x FMC HPC connectors
(Xilinx VCK190) 16 pulsed channels could use
KC705 with 1 FMC HPC

### 2x Digilent PMOD DA4 boards (each has 8 12-bit SPI DACs)

(4x $25)

8

AD5628

### 4 Pulsed Analog signals 2x Digilent ZMOD AWG 1411 boards (each has 2 14-bit DACs)

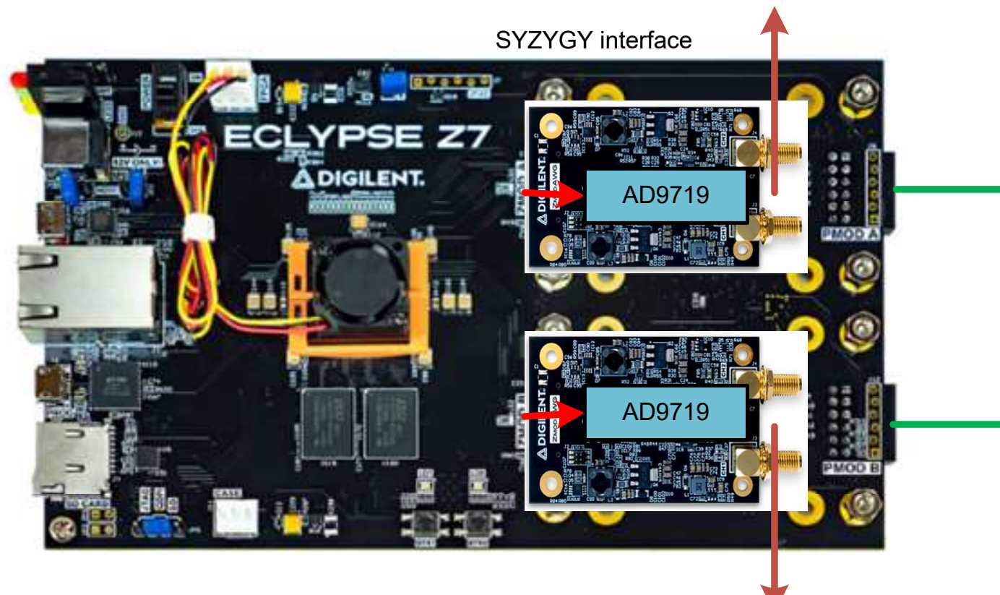
[picture p35: figure]
SYZYGY interface

2

2

8 16 DC Analog signalsAD5628

# Eclypse Z7 + 2x AWG1411 + 2x PMOD DA4 16 DC 12-bit, 4 Pulse 14-bit analog

### (Eclypse + 2x AWG1411 $600)

8

# Xilinx ZCU102 + 2x Abaco FMC216 + 4x PMOD DA4 32 DC 12-bit, 32 Pulse 16-bit analog

### 4x Digilent PMOD DA4 boards (each has 8 12-bit SPI DACs)

(4x $25)

8

AD5628

8 32 DC Analog signals

8

### 32 Pulsed Analog signals 2x Abaco FMC216 boards (each has 16 16-bit DACs)

(2x $6,000)
16 16

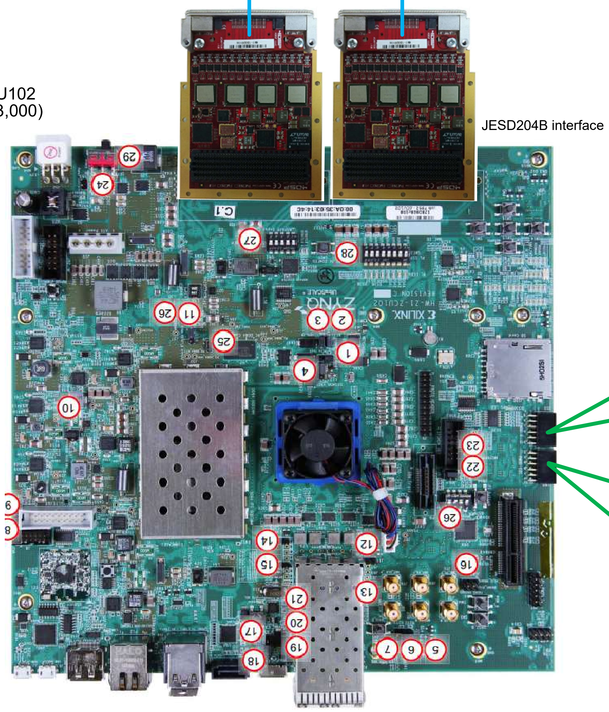
[picture p36: figure]
JESD204B interface

### Xilinx ZCU102 (Free or $3,000)

8

# Xilinx KC705 + 1x Abaco FMC216 + 4x PMOD DA4 32 DC 12-bit, 16 Pulse 16-bit analog

### 4x Digilent PMOD DA4 boards (each has 8 12-bit SPI DACs) Max update rate of a single DAC is ~1MHz

(4x $25)

8

AD5628

8 32 DC Analog signals

8

### 16 Pulsed Analog signals

### Abaco FMC216 board 16 16-bit DACs

### Xilinx XM105 FMC Debug header board ($160)

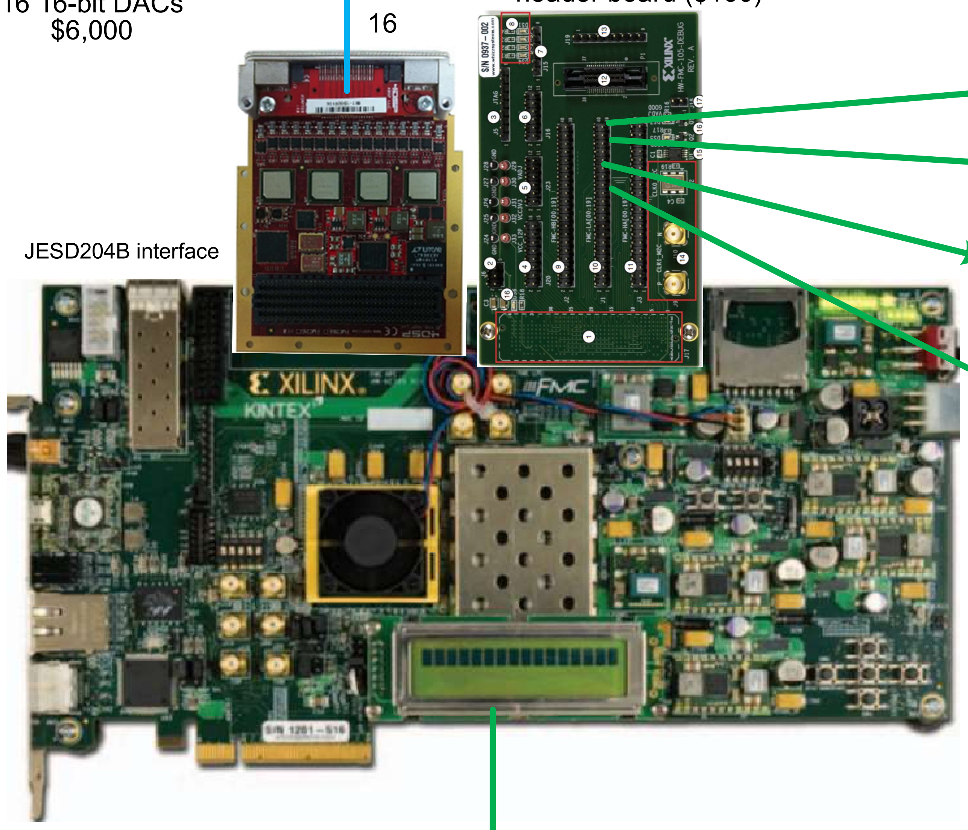
[picture p37: figure]
JESD204B interface

### 7 GPIO for PMODs also available on LCD header instead of XM105
