uw-acme/NANO_QLASER/src/python/Experiment1.xlsx

 | Dur1 | Amp1 | Dur2 | Amp2 | Dur3 | Amp3 | Dur4 | Amp4 | Dur5 | Amp5 | Dur6 | Amp6 | Dur7 | Amp7 | Dur8 | Amp8 | Dur9 | Amp9 | Dur10 | Amp10 | Dur11 | Amp11 | Dur12 | Amp12 | Dur13 | Amp13 | Dur14 | Amp14 | Dur15 | Amp15 | Dur16 | Amp16 | Dur17 | Amp17 | Dur18 | Amp18 | Dur19 | Amp19 | Dur20 | Amp20 | Dur21 | Amp21 | Dur22 | Amp22 | Dur23 | Amp23 | Dur24 | Amp24 | Dur25 | Amp25 | Dur26 | Amp26 | Dur27 | Amp27 | Dur28 | Amp28 | Dur29 | Amp29 | Dur30
Channel 0 | 5 | 1.1 | 10 | 0 | end
Channel 1 | 3 | 1.2 | end
Channel 2 | 5 | 1.3 | end
Channel 3 | 7 | 1.4 | end
Channel 4 | 9 | 1.5 | end
Channel 5 | 11 | 1.6 | end
Channel 6 | 13 | 1.7 | end
Channel 7 | 15 | 1.8 | end
Channel 8 | 17 | 1.9 | end
Channel 9 | 2 | 2 | end
Channel 10 | 2 | 2.1 | end
Channel 11 | 2 | 2.2 | end
Channel 12 | 2 | 2.3 | end
Channel 13 | 2 | 2.4 | end
Channel 14 | 2 | 2.5 | end
Channel 15 | 2 | 2.6 | end
Channel 16 | 2 | 2.7 | end
Channel 17 | 2 | 2.8 | end
Channel 18 | 2 | 2.9 | end
Channel 19 | 2 | 3 | end
Channel 20 | 2 | 3.1 | end
Channel 21 | 2 | 3.2 | end
Channel 22 | 2 | 3.3 | end
Channel 23 | 2 | 3.4 | end
Channel 24 | 2 | 3.5 | end
Channel 25 | 2 | 3.6 | end
Channel 26 | 2 | 3.7 | end
Channel 27 | 2 | 3.8 | end
Channel 28 | 2 | 3.9 | end
Channel 29 | 2 | 4 | end
Channel 30 | 2 | 4.1 | end
Channel 31 | 2 | 4.2 | end
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
