uw-acme/NANO_QLASER/(threads)

Thread 6 (2025-04-26):

sustain value shuold not be in rise/fall states

eyhc1, 2025-04-26:
selfnote:
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. The final value  should be in the sustain stage immediately. Right now that value will stay in rise for 1 extra cycle then to the flat top
