uw-acme/NANO_QLASER/documents/Project-overview.pdf

# Xilinx ZCU102 + 2x Abaco FMC216 + 4x PMOD DA4 32 DC 12-bit, 32 Pulse 16-bit analog

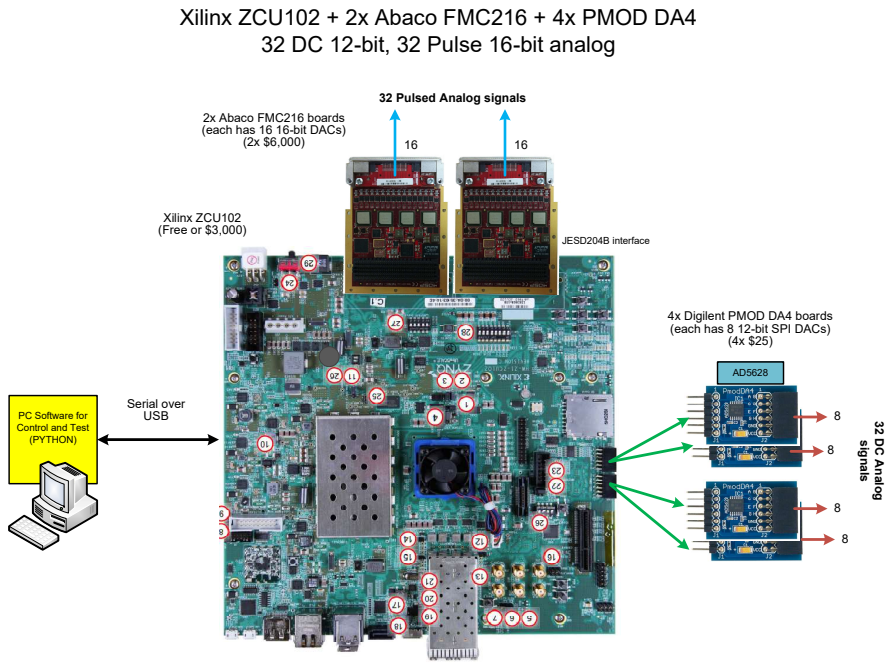
[picture p56: page 1]
8 32 DC Analog signals; JESD204B interface; Xilinx ZCU102 (Free or $3,000); Serial over USB

32 Pulsed Analog signals

2x Abaco FMC216 boards
(each has 16 16-bit DACs)

4x Digilent PMOD DA4 boards
(each has 8 12-bit SPI DACs)

PC Software for
Control and Test
(PYTHON)

# Eclypse Z7 + 2x AWG1411 + 2x PMOD DA4 16 DC 12-bit, (Optional 4 Pulse 14-bit analog)

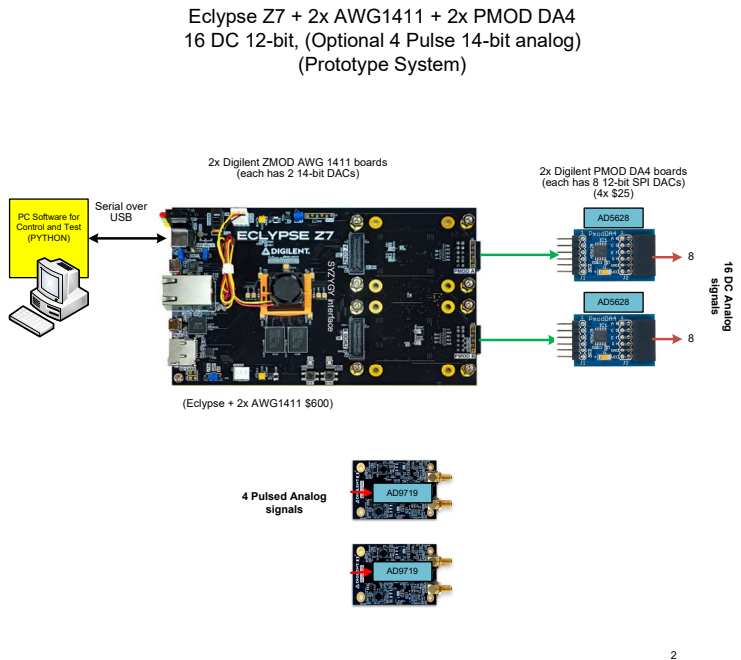
[picture p57: page 2]
4 Pulsed Analog signals; 8 16 DC Analog signalsAD5628; (Prototype System); (Eclypse + 2x AWG1411 $600); Serial over USB

2x Digilent ZMOD AWG 1411 boards
(each has 2 14-bit DACs)
AD9719 SYZYGY interface

2x Digilent PMOD DA4 boards
(each has 8 12-bit SPI DACs)

PC Software for
Control and Test
(PYTHON)

# (Backup) Xilinx KC705 + 1x Abaco FMC216 + 4x PMOD DA4 32 DC 12-bit, 16 Pulse 16-bit analog

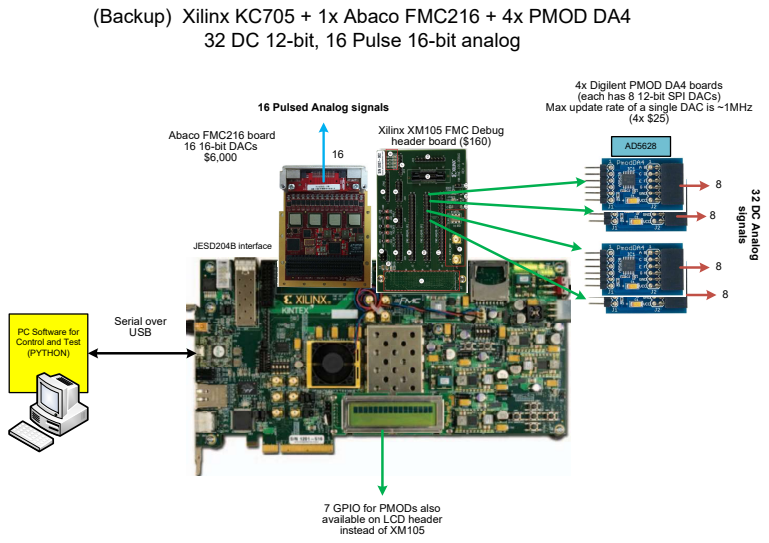
[picture p58: page 3]
8 32 DC Analog signals; Abaco FMC216 board 16 16-bit DACs $6,000; JESD204B interface; Serial over USB

4x Digilent PMOD DA4 boards
(each has 8 12-bit SPI DACs)
Max update rate of a single DAC is ~1MHz

16 Pulsed Analog signals

Xilinx XM105 FMC Debug
header board ($160)

PC Software for
Control and Test
(PYTHON)

7 GPIO for PMODs also
available on LCD header
instead of XM105

# Laser Control Project Components

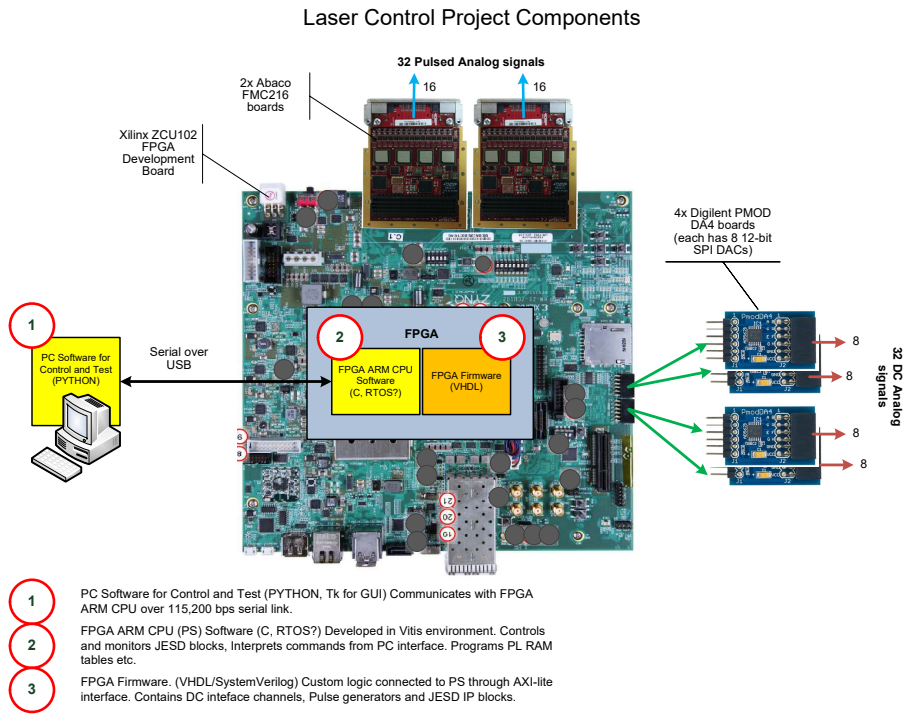
[picture p59: page 4]
8 32 DC Analog signals; Serial over USB; Xilinx ZCU102 FPGA Development Board; 2x Abaco FMC216 boards; FPGA Firmware (VHDL); FPGA

32 Pulsed Analog signals

4x Digilent PMOD
DA4 boards
(each has 8 12-bit
SPI DACs)

PC Software for
Control and Test
(PYTHON)

FPGA ARM CPU
Software
(C, RTOS?)

PC Software for Control and Test (PYTHON, Tk for GUI) Communicates with FPGA
ARM CPU over 115,200 bps serial link.
FPGA ARM CPU (PS) Software (C, RTOS?) Developed in Vitis environment. Controls
and monitors JESD blocks, Interprets commands from PC interface. Programs PL RAM
tables etc.
FPGA Firmware. (VHDL/SystemVerilog) Custom logic connected to PS through AXI-lite
interface. Contains DC inteface channels, Pulse generators and JESD IP blocks.

1. Xilinx (AMD) UltraScale+ FPGA data sheets. ZCU102 Development board user manual.
2. VHDL.
3. Vivado 2022.1 and Modelsim. Create project and bitfile to blink LED. Simulate then make bitfile to test.
4. Version Control with Github. Inspect existing code. Run simulations.
5. Initial use of a serial to parallel (cpuint) block in the FPGA to receive read/write commands.
6. Replacement by UART in hard CPU in the ZCU102 board.
7. Use of Python/Tkinter to create a user interface to control the system.
8. The use of the JESD serial interface standard to transfer data, at high speed, to 32 16-bit DACs. 64 signals

# replace 512 parallel data lines. JESD documents, Abaco FMC216 manual

9. The use of the I2C bus to program DACs and Clock generators on FMC216 boards. Embedded C programming. Xilinx IP manual, TRM. Datasheets for DAC and Clock generator.
10. The use of software running on the FPGA PS CPU to perform initial setup and interpret higher level commands instead of sending detailed register read/write commands serially from the PC.

# Things you need to know

# Project goal is to construct a pulse generator for controlling quantum computer elements

# Laser Control FPGA Block Diagram ZCU102, 32 DC 12-bit, 32 Pulse 16-bit

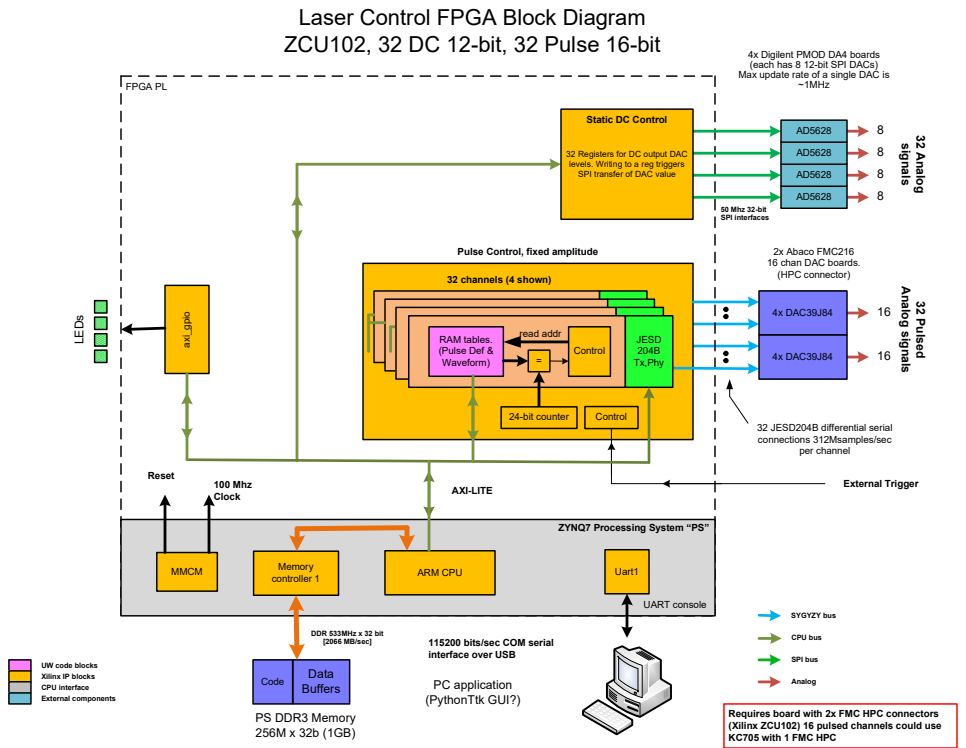
[picture p60: page 6]
JESD 204B Tx,Phy; FPGA PL; CPU bus; SPI bus; Analog; 50 Mhz 32-bit; SPI interfaces; 32 Analog signals; ~1MHz; 100 Mhz Clock; Reset; SPI transfer of DAC value; 32 Pulsed Analog signals; External Trigger axi_gpio; Control; RAM tables. (Pulse Def &; Waveform); read addr; 24-bit counter; 4x DAC39J84; 32 JESD204B differential serial connections 312Msamples/sec per channel; SYGYZY bus; Data Buffers Code; ARM CPU; PS DDR3 Memory 256M x 32b (1GB); Uart1; UART console; DDR 533MHz x 32 bit [2066 MB/sec]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

Static DC Control

32 Registers for DC output DAC
levels. Writing to a reg triggers

Pulse Control, fixed amplitude

2x Abaco FMC216
16 chan DAC boards.
(HPC connector)

32 channels (4 shown) LEDs

ZYNQ7 Processing System “PS”

115200 bits/sec COM serial
interface over USB

UW code blocks
Xilinx IP blocks
CPU interface
External components

Requires board with 2x FMC HPC connectors
(Xilinx ZCU102) 16 pulsed channels could use
KC705 with 1 FMC HPC

Pulse Channel Control
process pr_sm_pulse_channel External Trigger (pushbutton)

read addr

JESD204B
differential data to
HPC FMC
connector, then to
Abaco board

100 Mhz CPU bus for register setting and RAM loading

Common
to all
channels
read addr | AXI-STREAM

CPU Trigger
(from PS)

RAM
dout

RAM dout

start_pulse

24-bit
counter

=

Pulse Definition table is loaded with up to 256 128-bit pulse definitions. A pulse definition consists of :
Pulse start time
Pulse waveform table start address and table length.
Gain factor and time factor.

Waveform table is loaded with up to 4096 16-bit DAC values that define the pulse shape.

Pulse Channel Control waits for a CPU trigger or an External trigger. Once a trigger is seen it reads the first definition from the Pulse table. When the external 24-bit count reached the table value a start_pulse is generated and the controller then reads the requested waveform table using the start address and time factor from the definition table. The waveform table output is scaled by the gain factor and converted into an AXI stream and sent to the JESD Transmit block.

The read address of the Pulse definition table is incremented and the Controller waits for the next start_pulse to the output the next pulse.

The data_to_stream block uses a FIFO to buffer the waveform data and supplies AXI-stream data to the JESD block. The JESD block could apply ‘backpressure’ using the axi_s bus tready signal to pause the data.

CPU bus
(sel,wr,addr, din,dout

AXI-Stream bus

UW code blocks

Xilinx IP blocks (addnl license)

Xilinx IP blocks (Standard)

JESD bus

qlaser_dacs_pulse_channel

data_to_stream

comparator

axi_stream
t_ready

RAM Waveform table
4096w x 16-bit

fifo_write

status?

X

gain_factor Round

time_factor
waveform

RAM Pulse
Definition table
1024w x 128-bit

JESD
204B
Tx,Phy

# Laser Control FPGA Block Diagram of one JESD DAC channel

# Pulse Definition for JESD DAC channel

Pulse 0 | Pulse 1

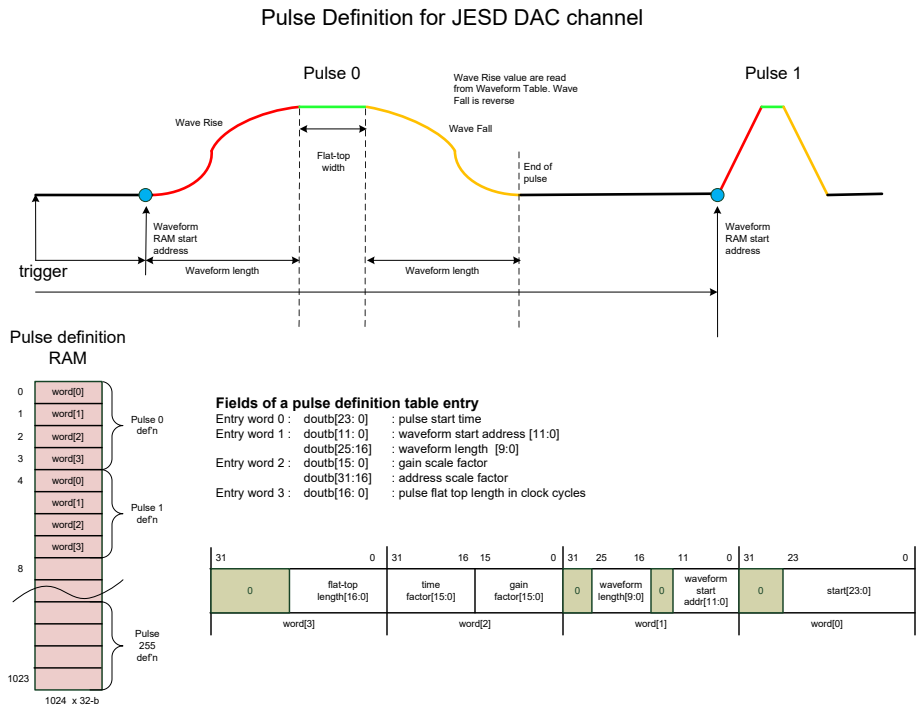
[picture p61: page 8]
Entry word 0 : doutb[23: 0]; : pulse start time; Entry word 1 : doutb[11: 0]; : waveform start address [11:0]; doutb[25:16]; : waveform length [9:0]; Entry word 2 : doutb[15: 0]; : gain scale factor; doutb[31:16]; : address scale factor; Entry word 3 : doutb[16: 0]; : pulse flat top length in clock cycles; word[3]; word[2]; word[1]; word[0]; waveform start addr[11:0]; start[23:0] waveform length[9:0]; gain factor[15:0]; flat-top length[16:0]; time factor[15:0]; Pulse 0 def’n; Pulse 1 def’n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

Wave Rise value are read
from Waveform Table. Wave
Fall is reverse

Wave Fall Wave Rise

Fields of a pulse definition table entry
