uw-acme/NANO_QLASER/documents/Qcontrol_FPGA_Block_Diagram.pdf

# Laser Control FPGA Block Diagram ZCU102, 32 DC 12-bit, 32 Pulse 16-bit

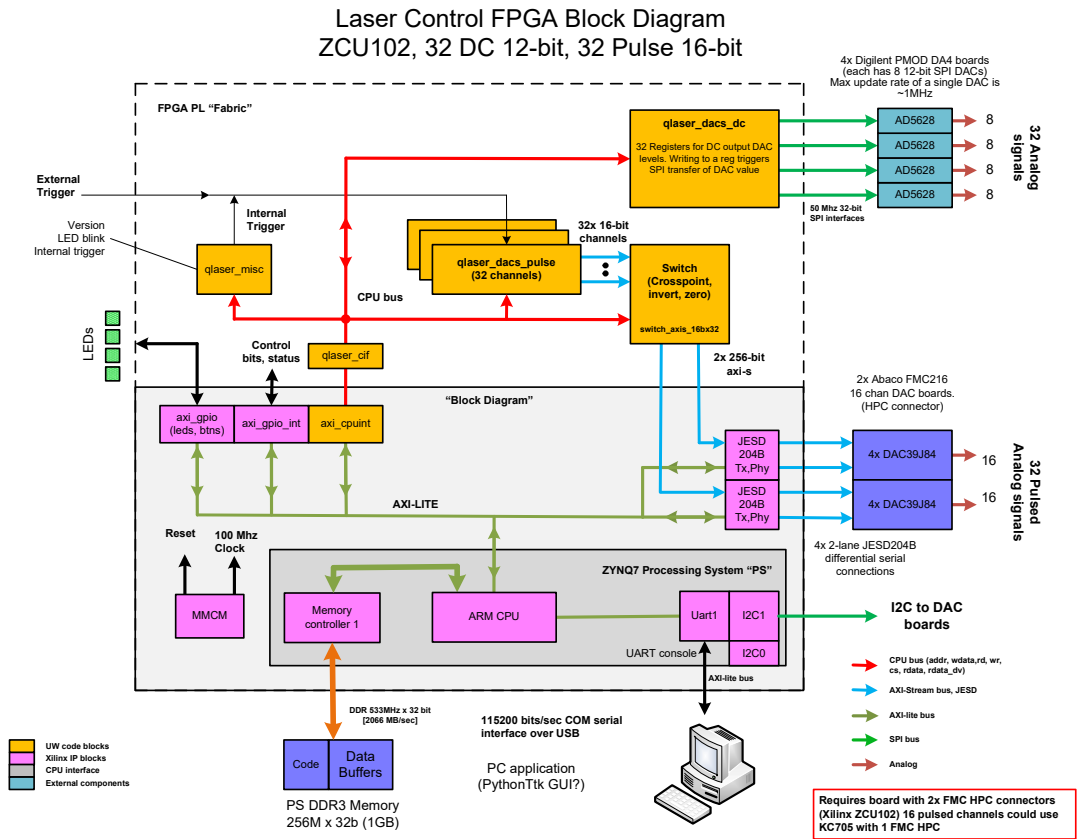
[picture p62: page 1]
SPI bus; Analog; 50 Mhz 32-bit; SPI interfaces; 32 Analog signals; ~1MHz; 100 Mhz Clock; Reset; SPI transfer of DAC value; 32 Pulsed Analog signals; qlaser_dacs_dc; External Trigger; 32x 16-bit channels LEDs; 16 ⁴x DAC39J84; 16 4x DAC39J84; 4x 2-lane JESD204B differential serial connections; Data Buffers Code; PS DDR3 Memory 256M x 32b (1GB); UART console; DDR 533MHz x 32 bit [2066 MB/sec]; Memory controller 1; AXI-LITE; PC application (PythonTtk GUI?); JESD 204B Tx,Phy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

FPGA PL “Fabric”

32 Registers for DC output DAC
levels. Writing to a reg triggers

2x Abaco FMC216
16 chan DAC boards.
(HPC connector)

ZYNQ7 Processing System “PS”

CPU bus (addr, wdata,rd, wr,
cs, rdata, rdata_dv)

AXI-lite bus

AXI-Stream bus, JESD

115200 bits/sec COM serial
interface over USB

UW code blocks
Xilinx IP blocks
CPU interface
External components

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
