uw-acme/NANO_QLASER/documents/eclypse_z7_sch_b2.pdf

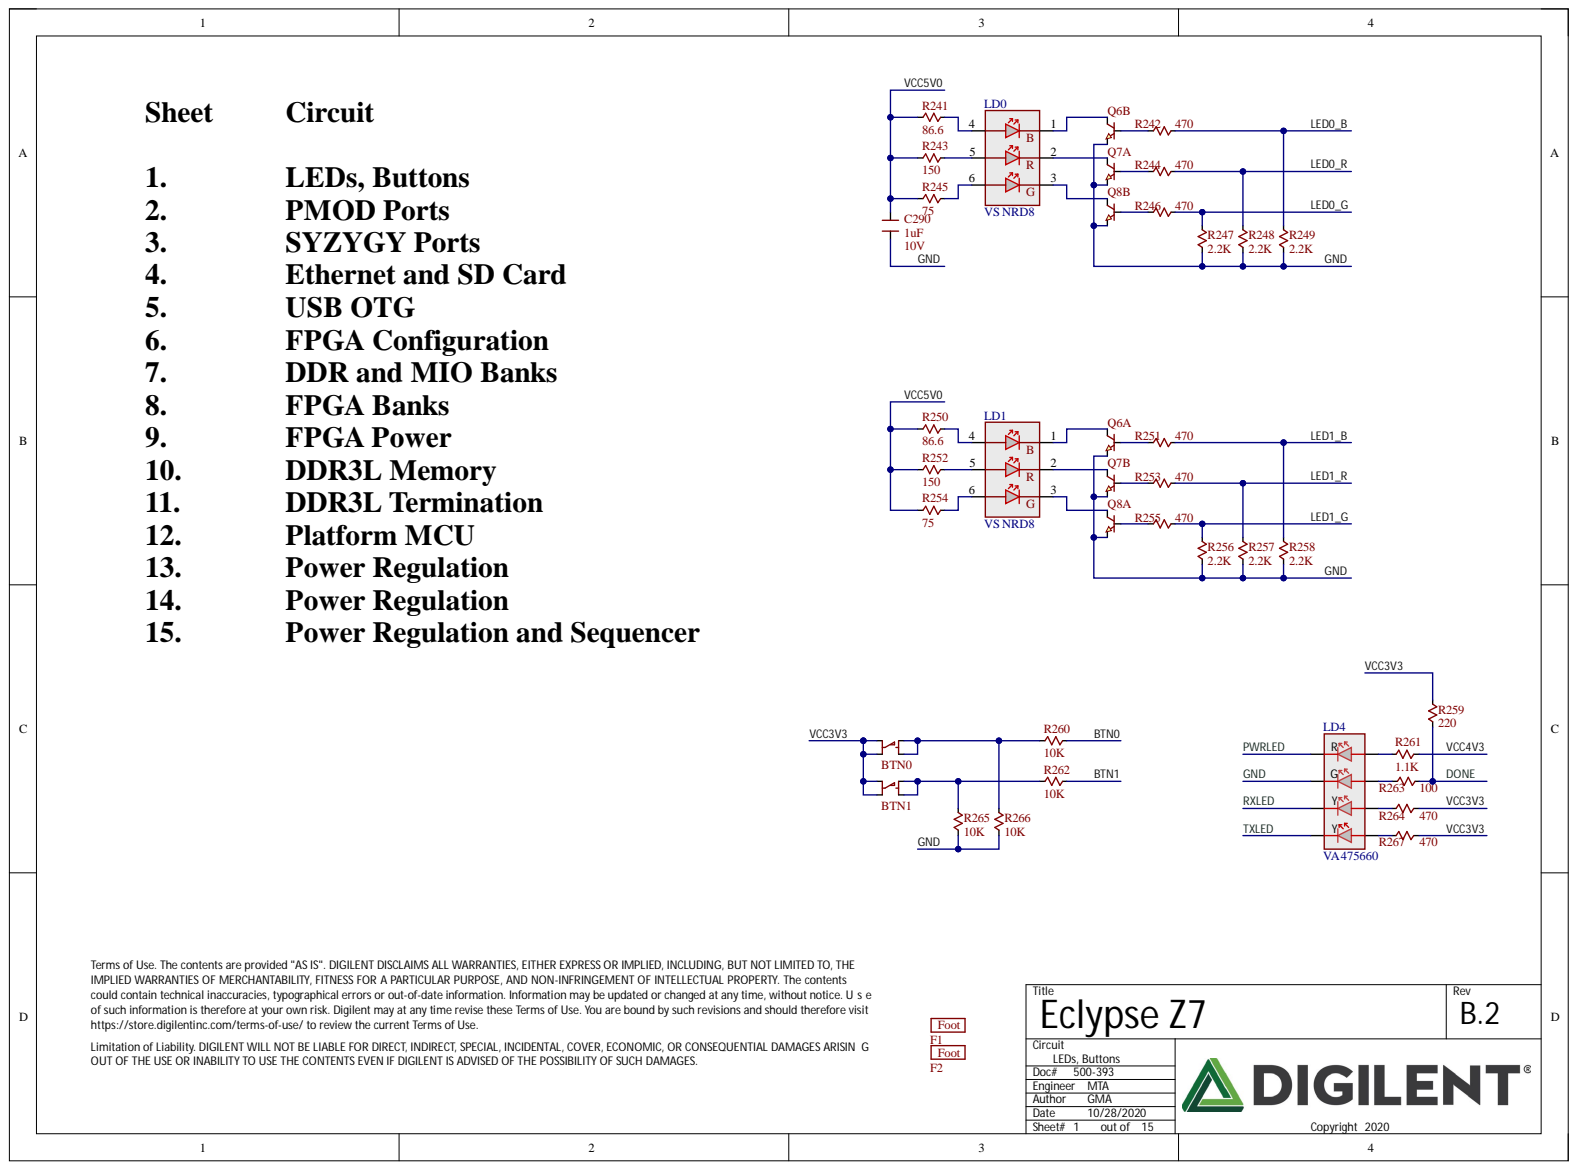
[picture p63: page 1]

1. LEDs, Buttons
2. PMOD Ports
3. SYZYGY Ports
4. Ethernet and SD Card
5. USB OTG
6. FPGA Configuration
7. DDR and MIO Banks
8. FPGA Banks
9. FPGA Power
10. DDR3L Memory
11. DDR3L Termination
12. Platform MCU

13. Power Regulation
14. Power Regulation
15. Power Regulation and Sequencer

Terms of Use. The contents are provided "AS IS". DIGILENT DISCLAIMS ALL WARRANTIES, EITHER EXPRESS OR IMPLIED, INCLUDING, BUT NOT LIMITED TO, THE
IMPLIED WARRANTIES OF MERCHANTABILITY, FITNESS FOR A PARTICULAR PURPOSE, AND NON-INFRINGEMENT OF INTELLECTUAL PROPERTY. The contents
could contain technical inaccuracies, typographical errors or out-of-date information. Information may be updated or changed at any time, without notice. Use
of such information is therefore at your own risk. Digilent may at any time revise these Terms of Use. You are bound by such revisions and should therefore visit
https://store.digilentinc.com/terms-of-use/ to review the current Terms of Use.
Limitation of Liability. DIGILENT WILL NOT BE LIABLE FOR DIRECT, INDIRECT, SPECIAL, INCIDENTAL, COVER, ECONOMIC, OR CONSEQUENTIAL DAMAGES ARISING
OUT OF THE USE OR INABILITY TO USE THE CONTENTS EVEN IF DIGILENT IS ADVISED OF THE POSSIBILITY OF SUCH DAMAGES.

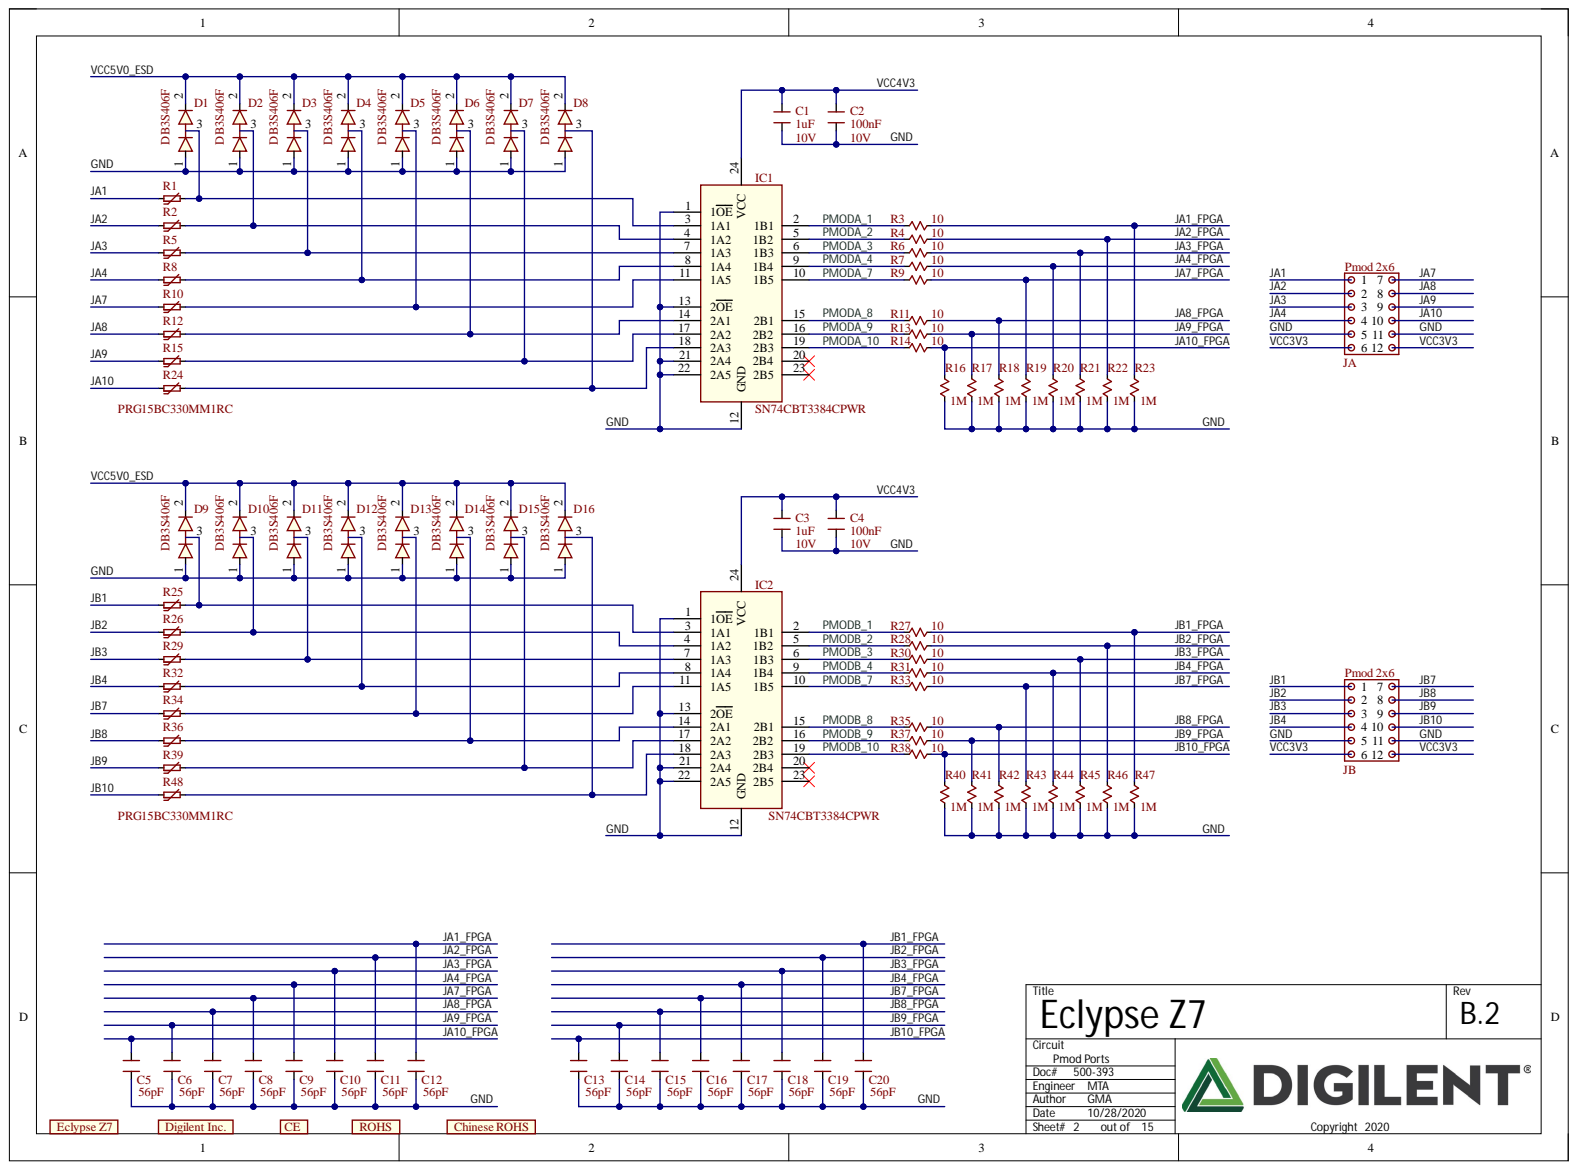
[picture p64: page 2]

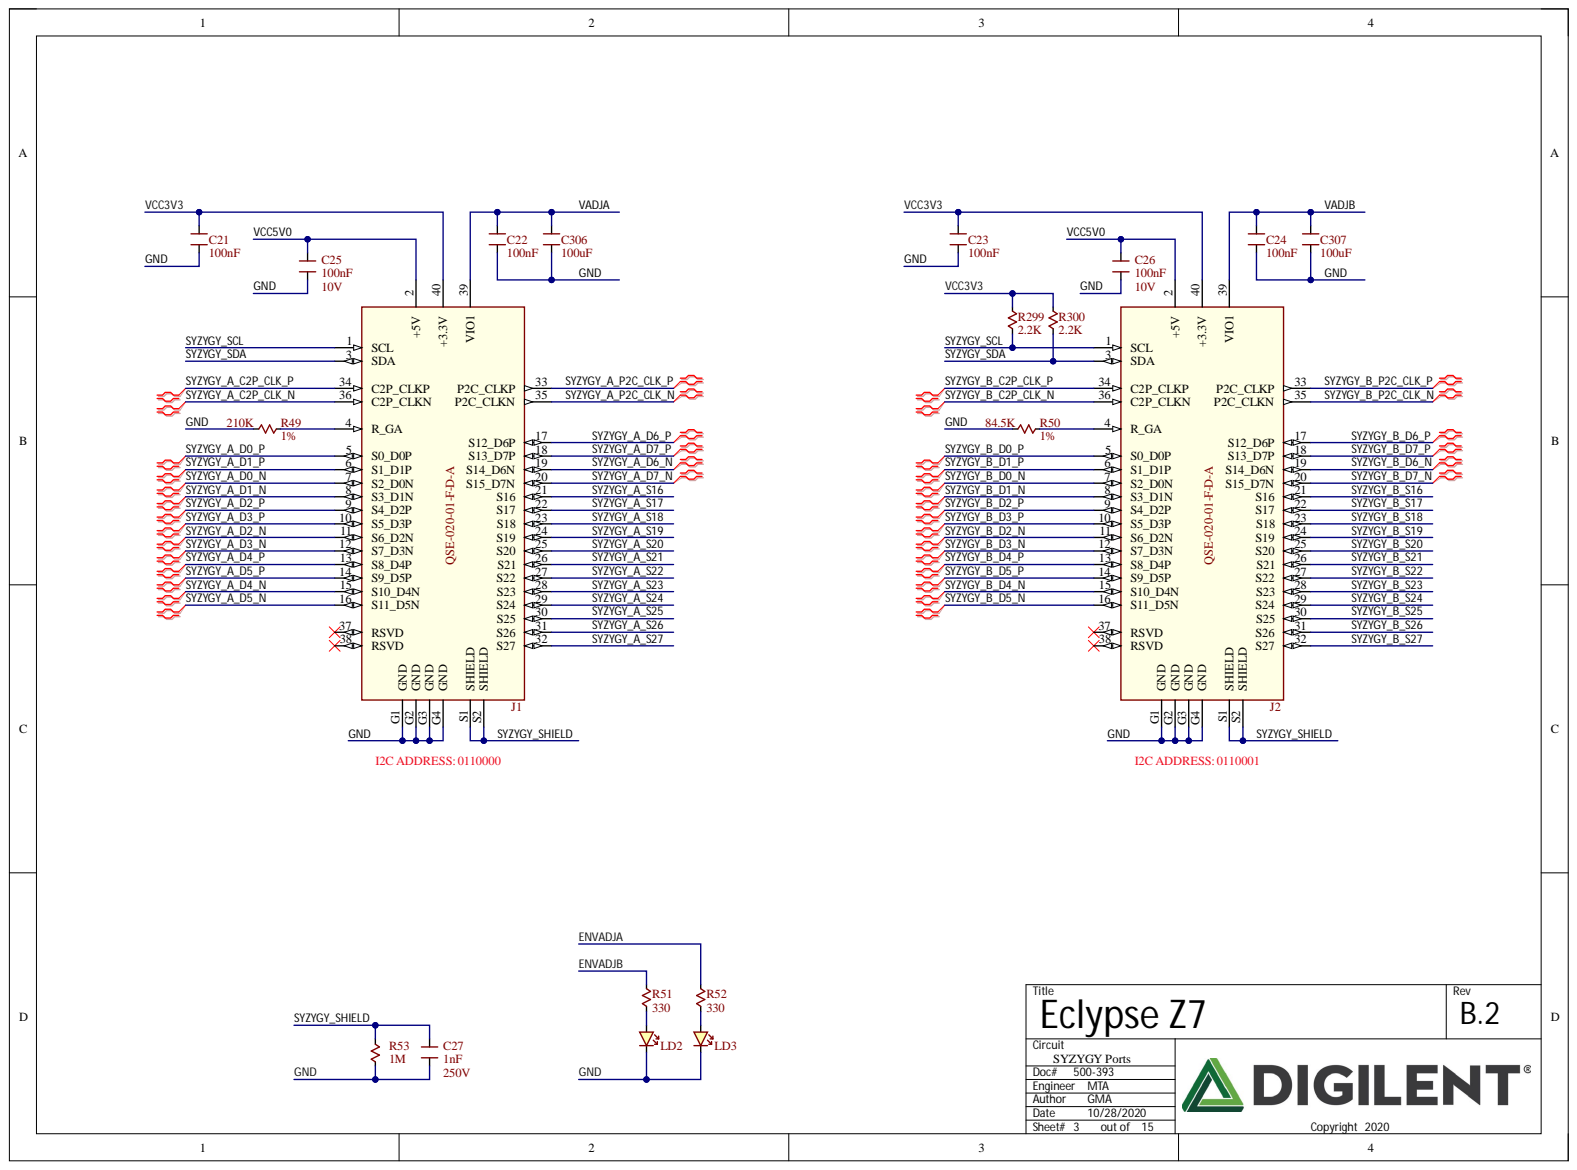
[picture p65: page 3]

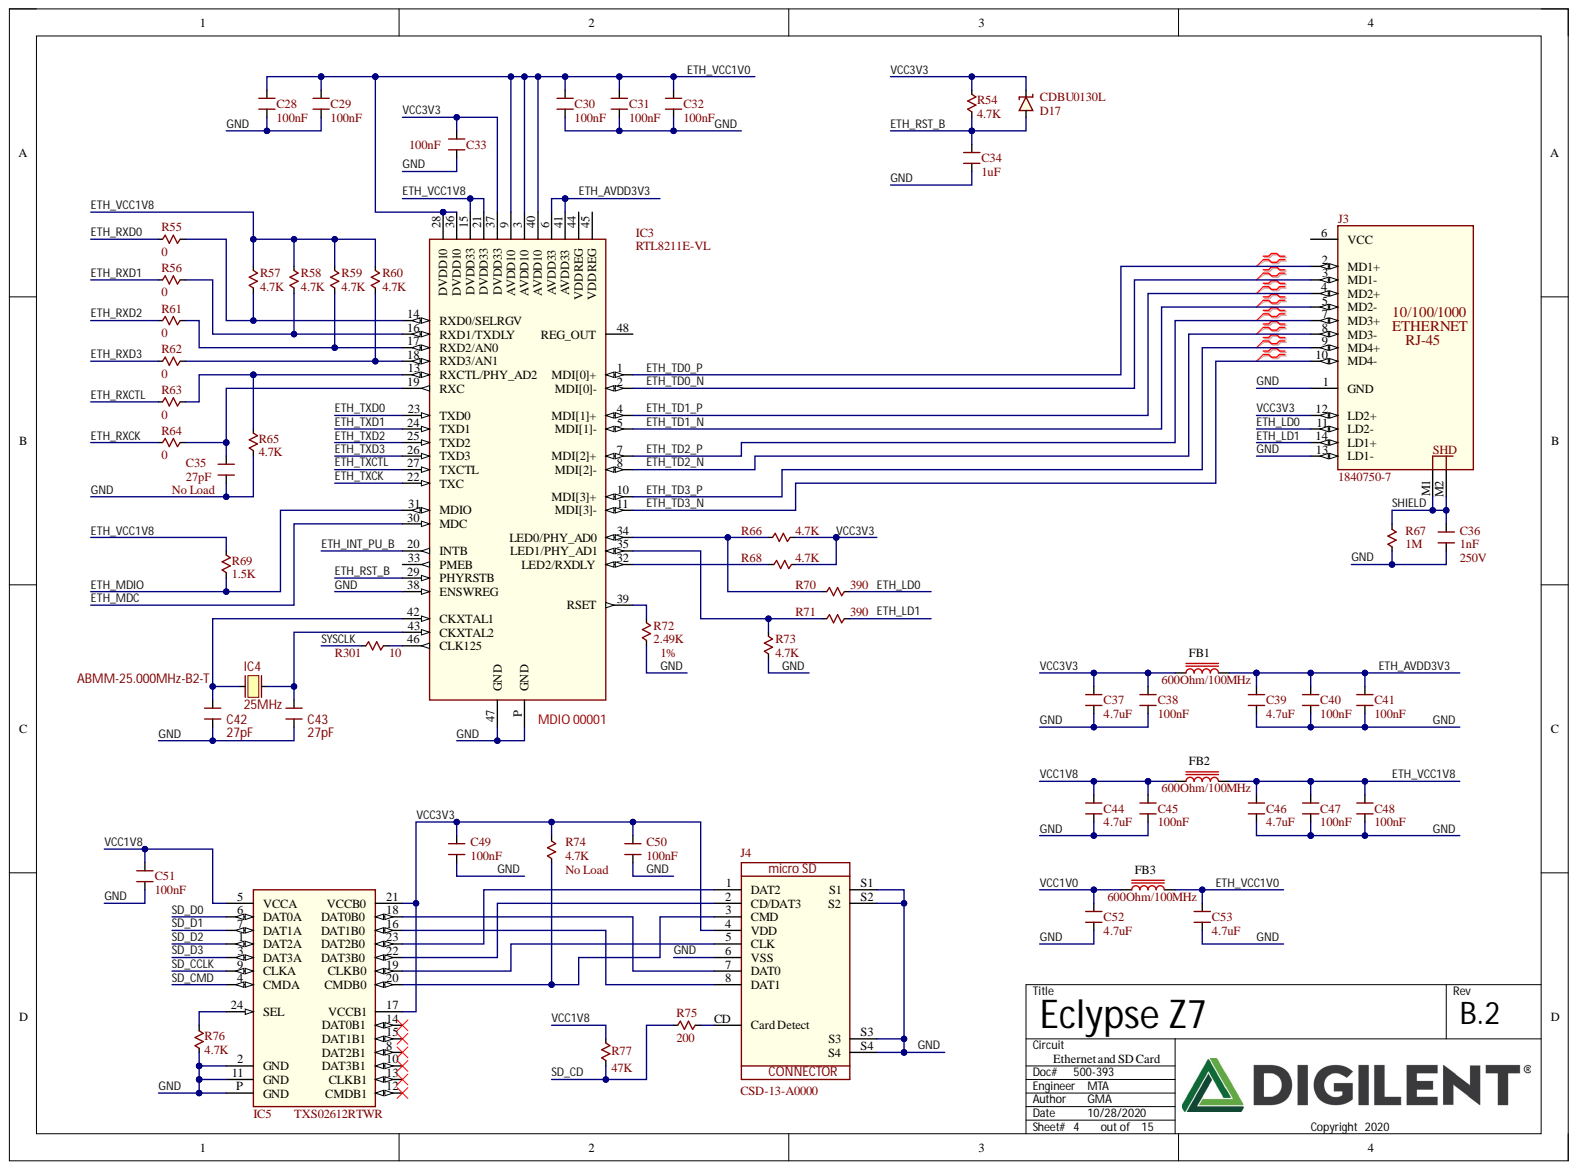
[picture p66: page 4]

RXC 19 | | ETH_TD0_N | | GND

ETH_TXD0 R65 | | TXD0 23 | | ETH_TD1_P | | VCC3V3 | LD2+ 12

Ethernet and SD Card 47K

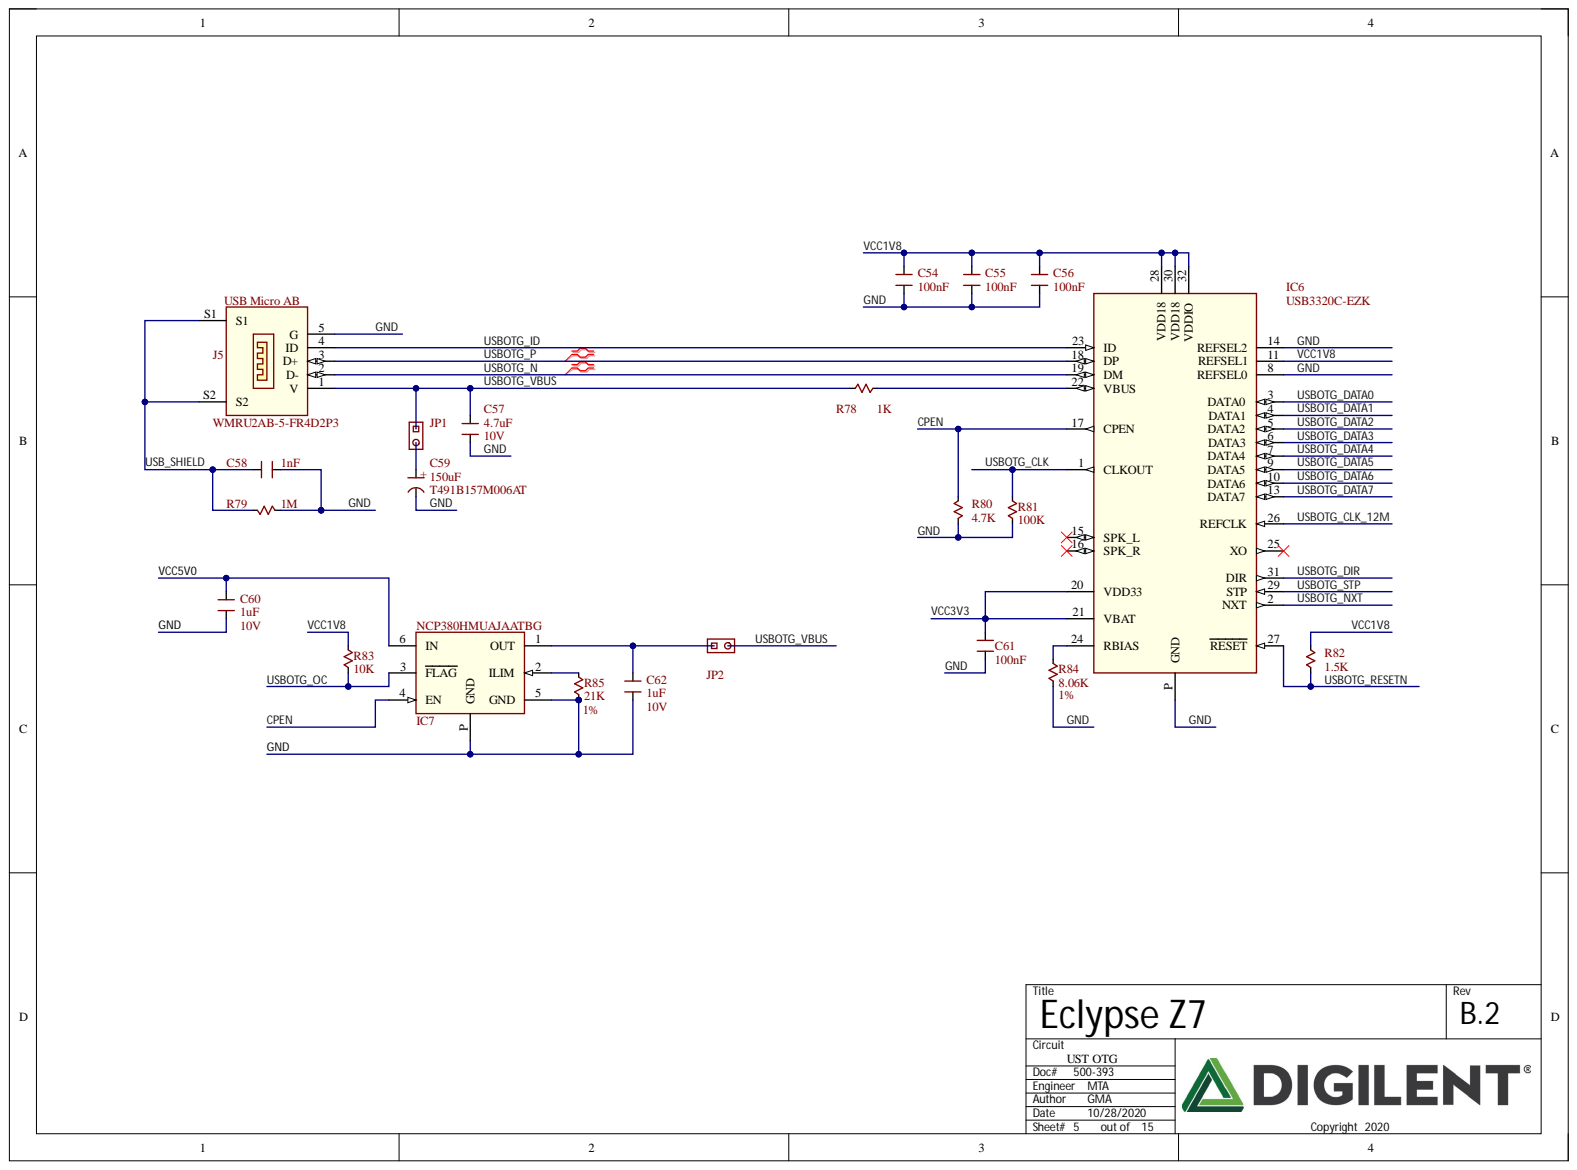
[picture p67: page 5]

GND

USB OTG_O C

Eclypse Z7
Author Date Doc# Circuit

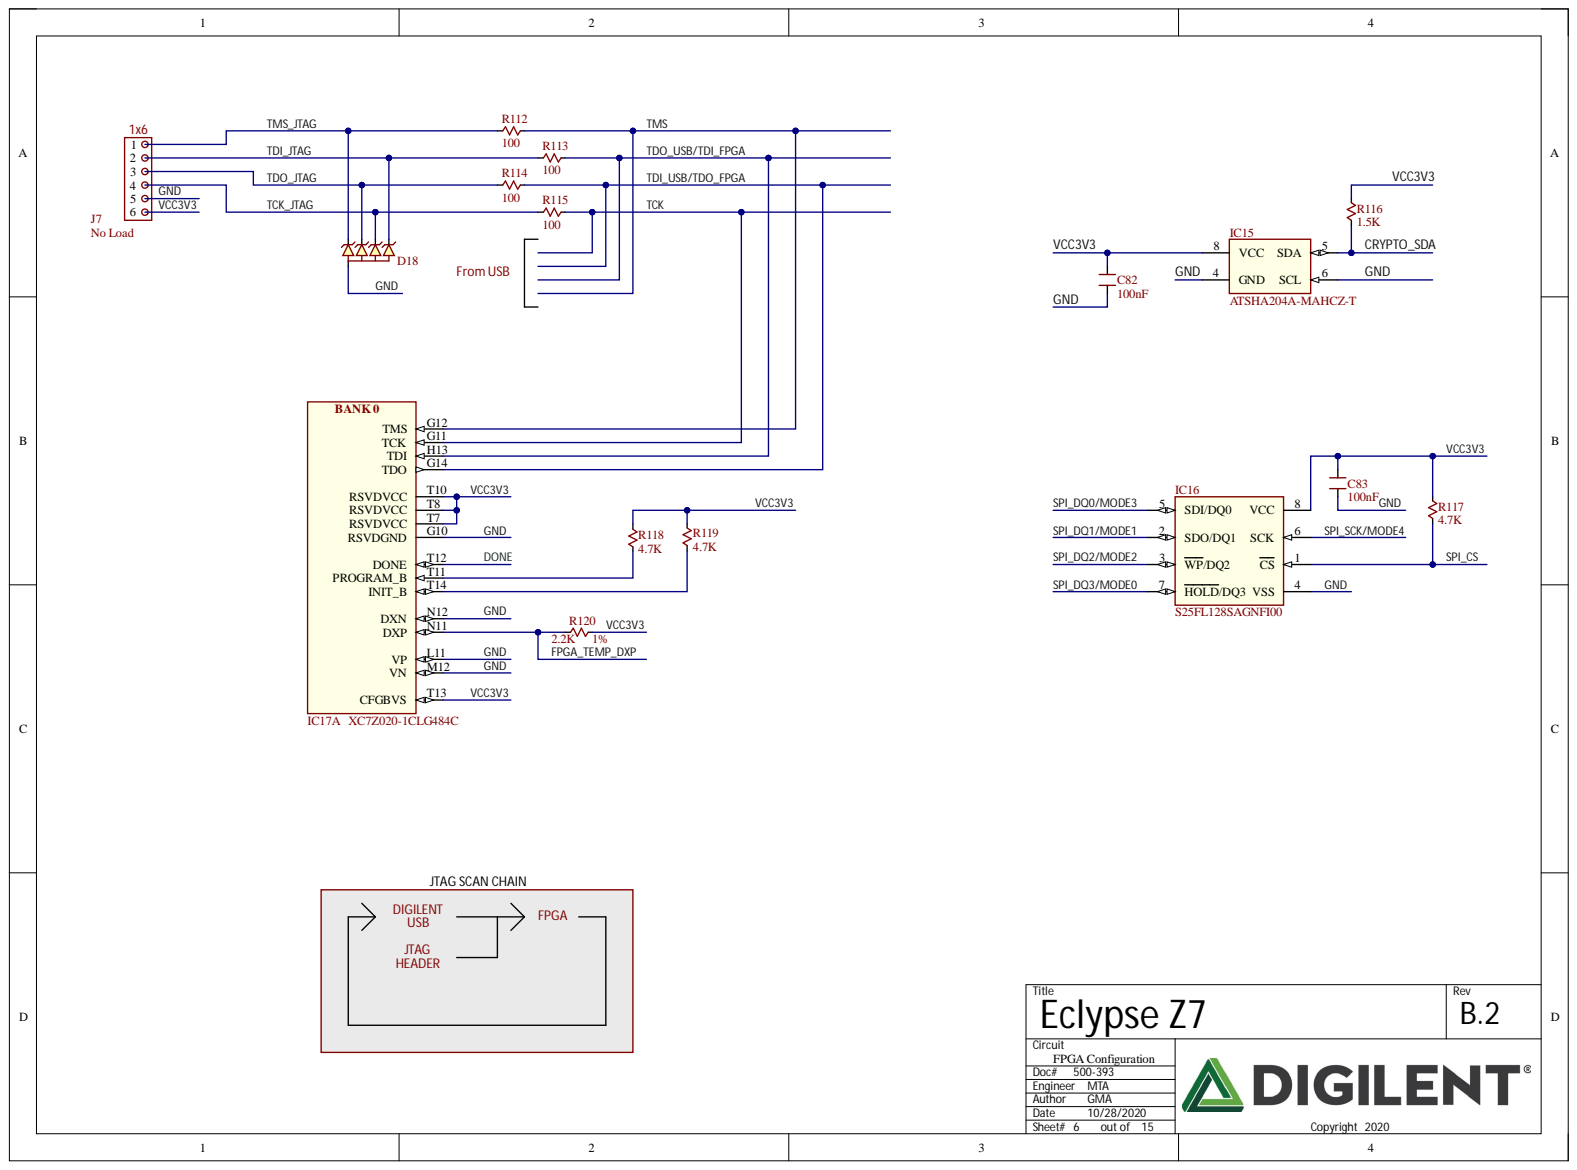
[picture p68: page 6]

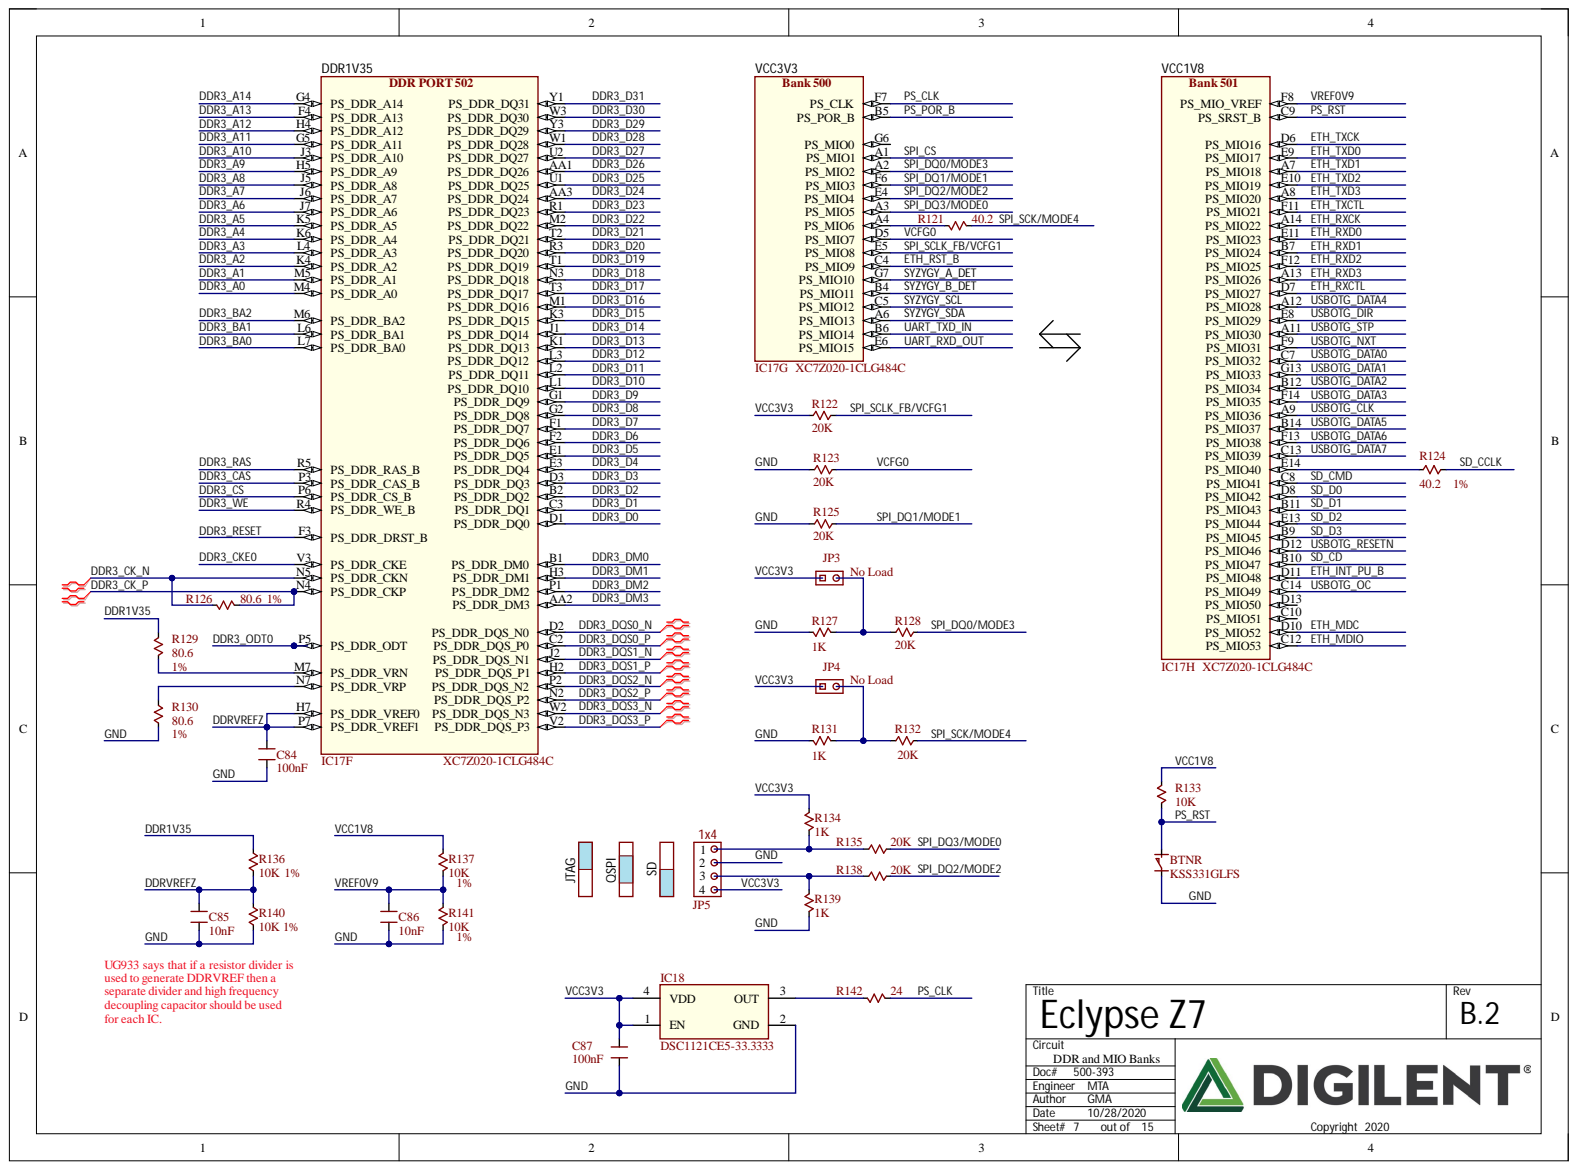
[picture p69: page 7]

Eclypse Z7
Author Date Doc# Circuit

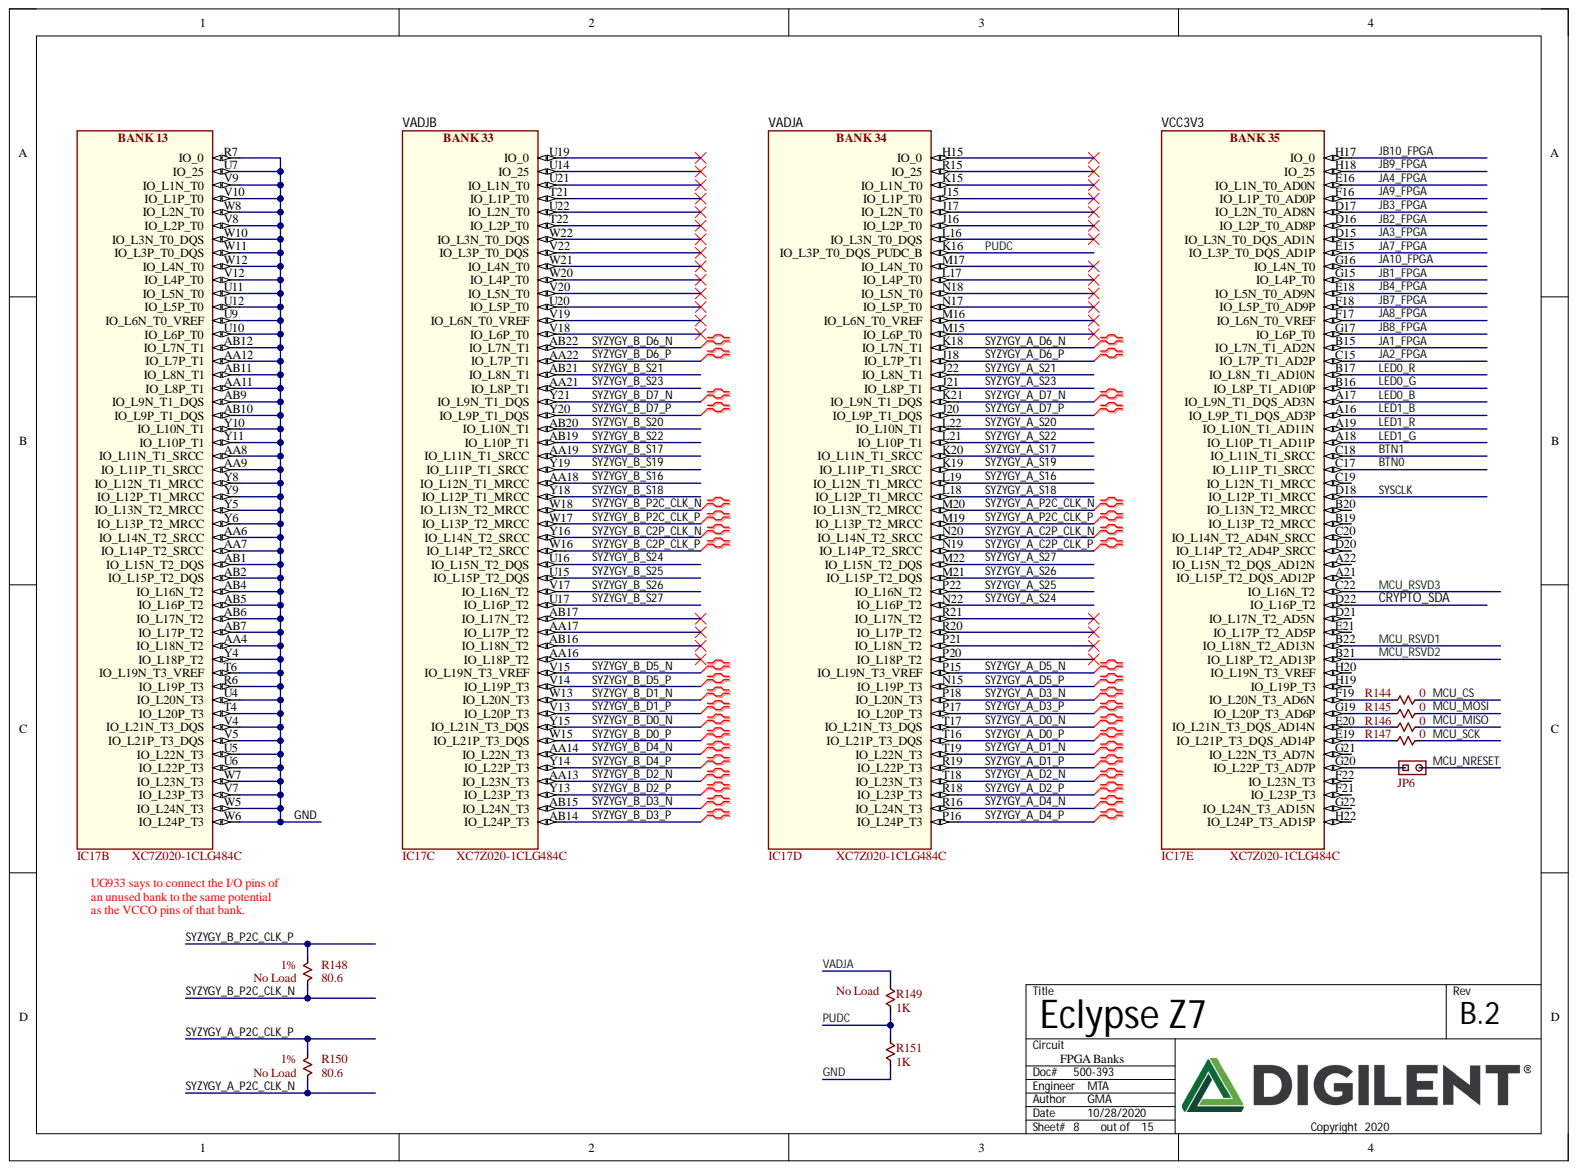
[picture p70: page 8]

UG933 says to
an unused bank to the same potenti
as the VC

CO pins of that bank.

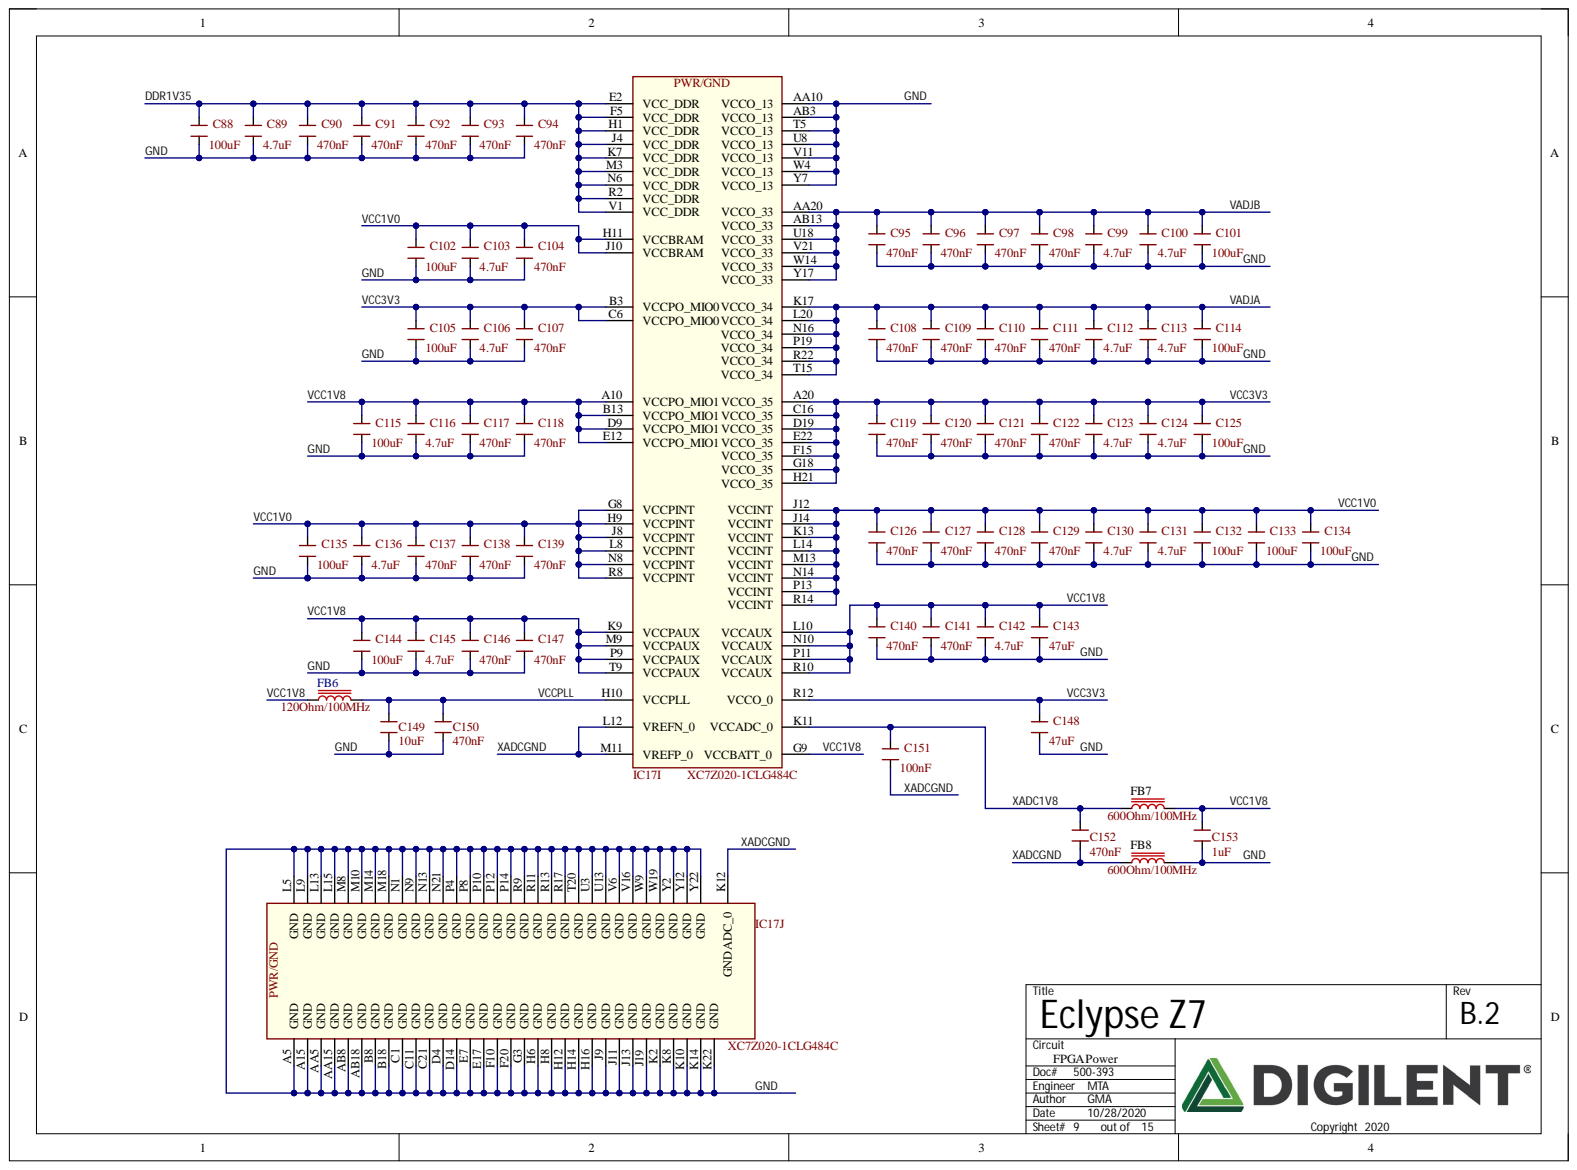
[picture p71: page 9]

VCCPO_MIO0 C6

VCCPO_MIO1 B13

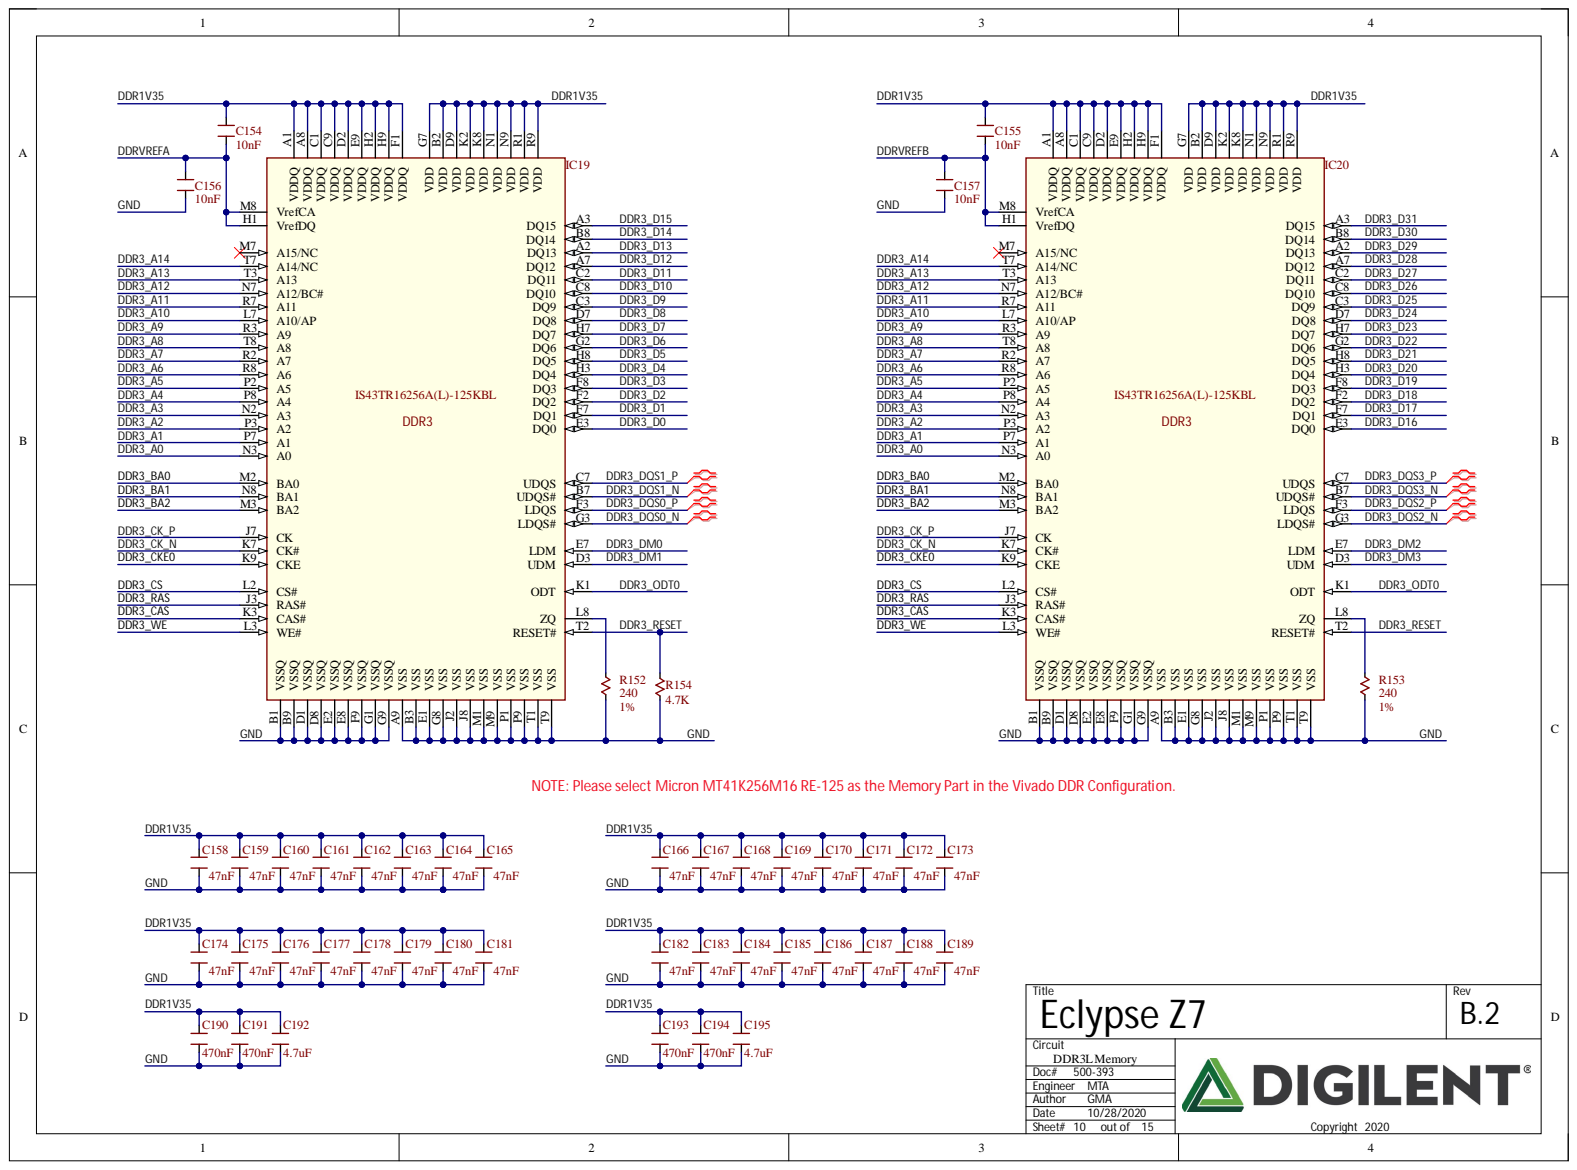
[picture p72: page 10]

NOTE: Please select Micron MT41K256M16 RE-125 as the Memory Part in the Vivado DDR Configuration.

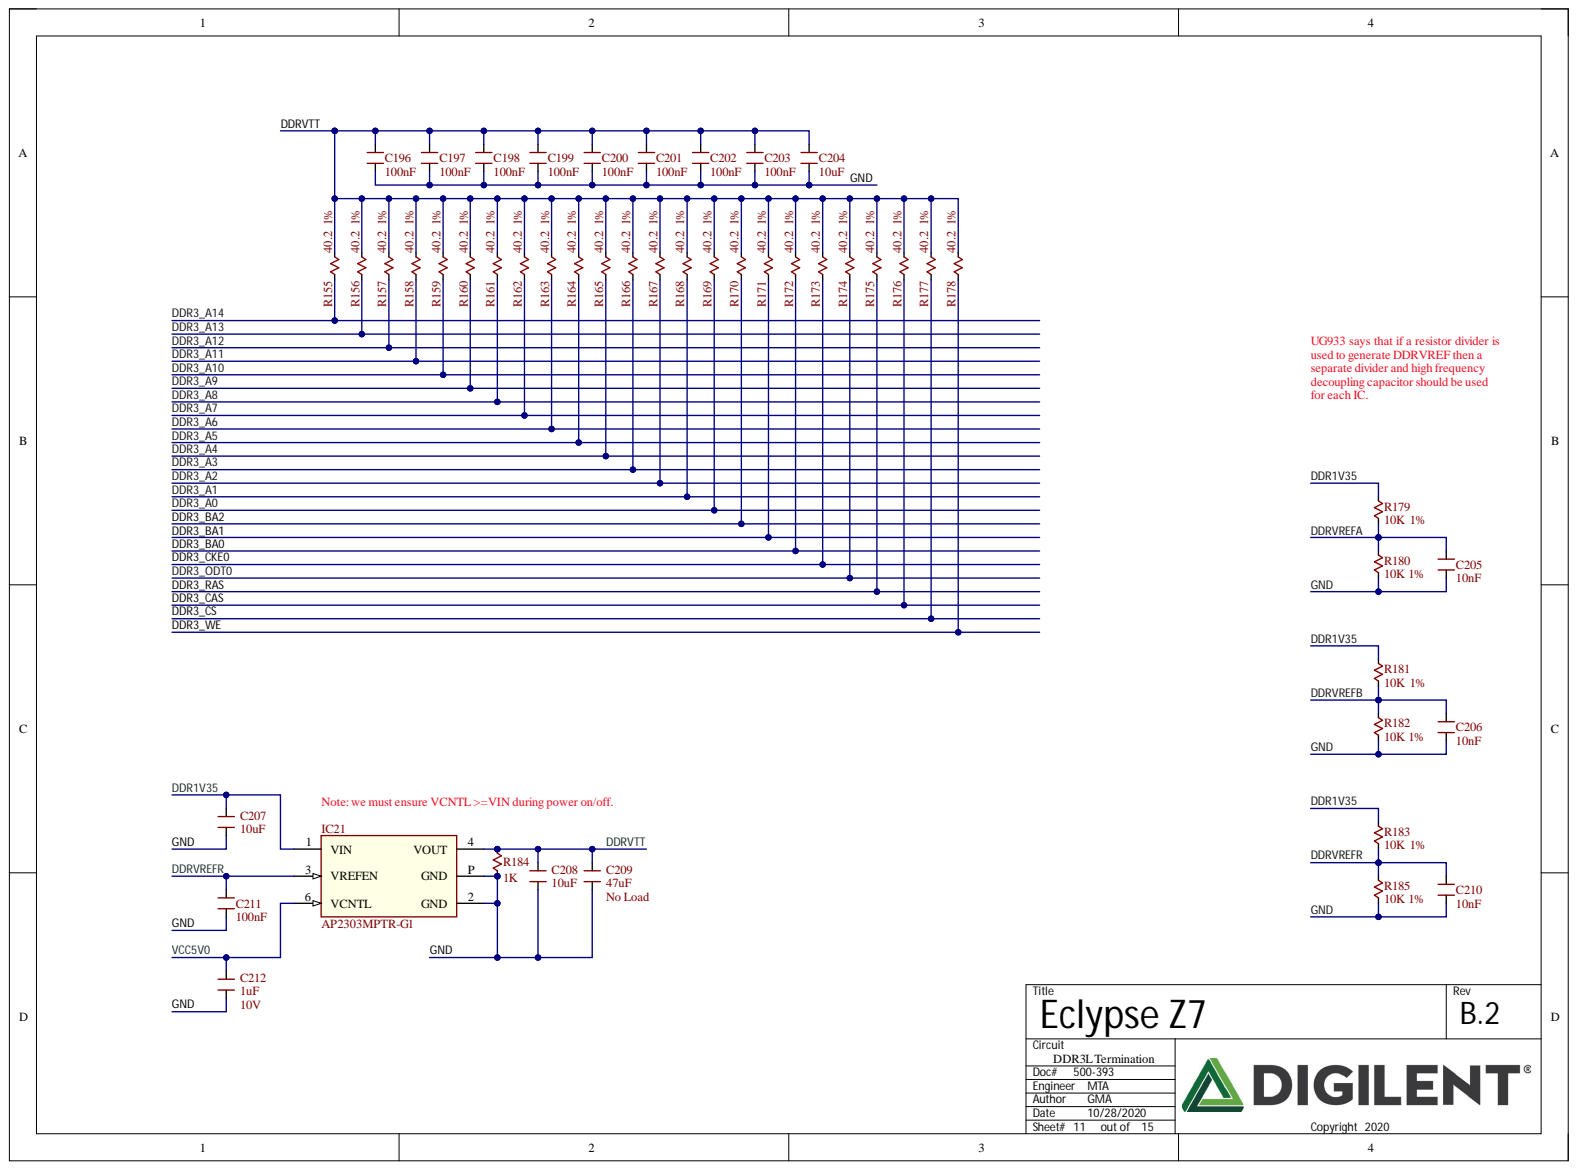
[picture p73: page 11]

UG933 says that if a resistor divider is
used to generate DDRVREF then a
separate divider and high frequency
decoupling capacitorshould be used
for each IC.

Note: we must ensure VCNTL >=VIN during power on/off.

GND

GND | GND

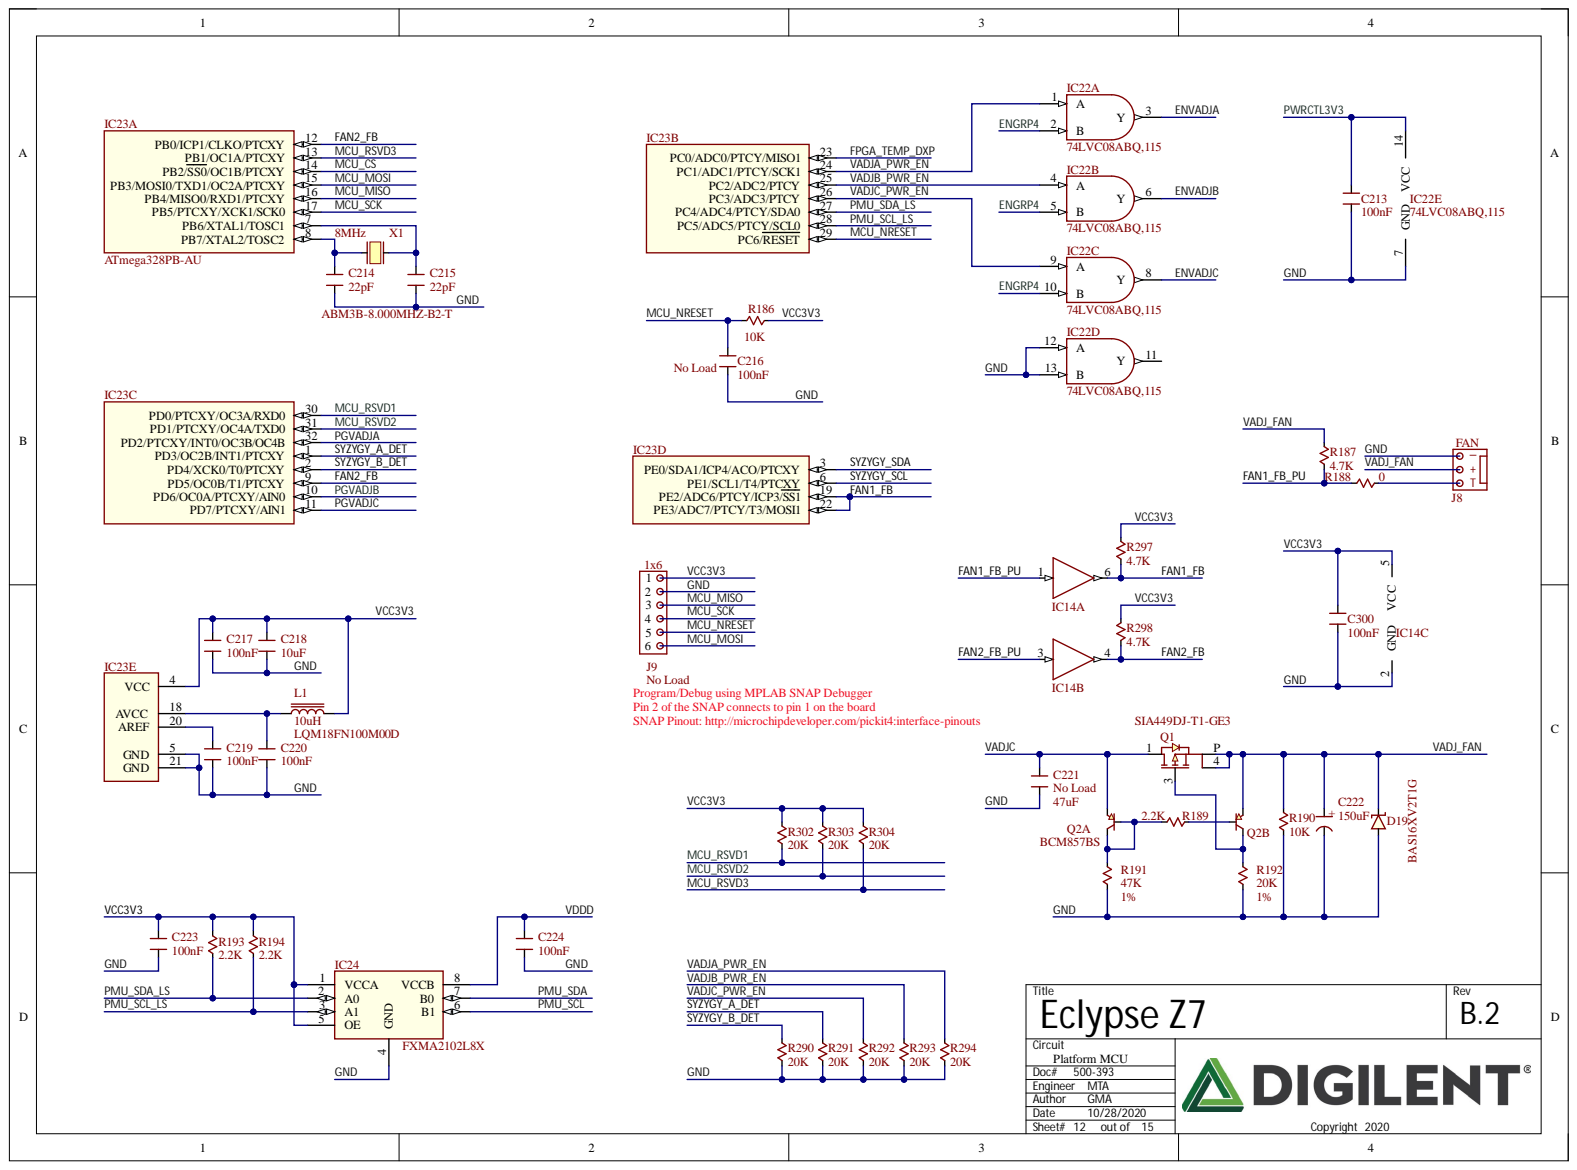
[picture p74: page 12]

No Load
Program/Debug using MPLAB SNAP Debugger
Pin 2 of the SNAP connects to pin 1 on the board
SNAP Pinout: http://microchipdeveloper.com/pickit4:interface-pinouts

A0 2 | PMU_SDA | VADJC_PWR_EN
A1 3 | PMU_SCL | SYZYGY_A_DET

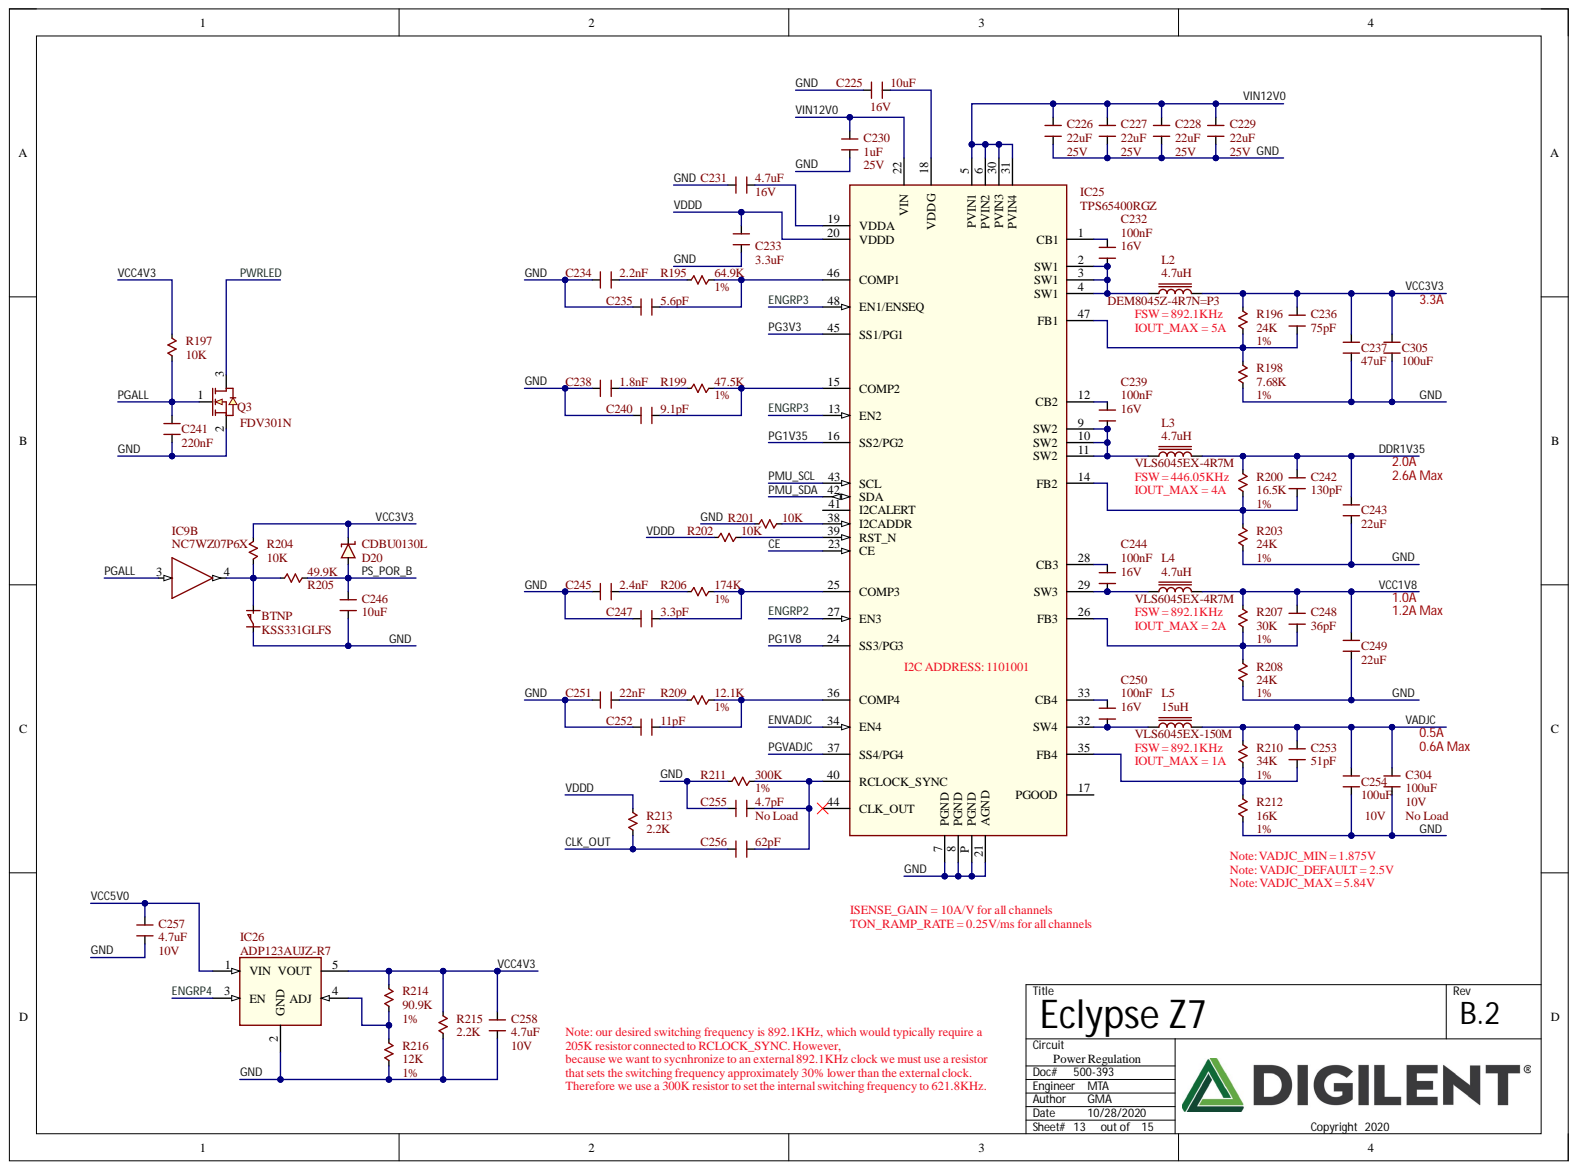
[picture p75: page 13]

ISENSE_GAIN = 10A/V for all channels
TON_RAMP_RATE = 0.25V/ms for all channels

Note: our desired switching frequency is 892.1KHz, which would typically require a
205K resistor connected to RCLOCK_SYNC. However,
because we want to sycnhronize to an external 892.1KHz clock we must use a resistor
that sets the switching frequency approximately 30% lower than the external clock.
Therefore we use a 300K resistor to set the internalswitching frequency to 621.8KHz.

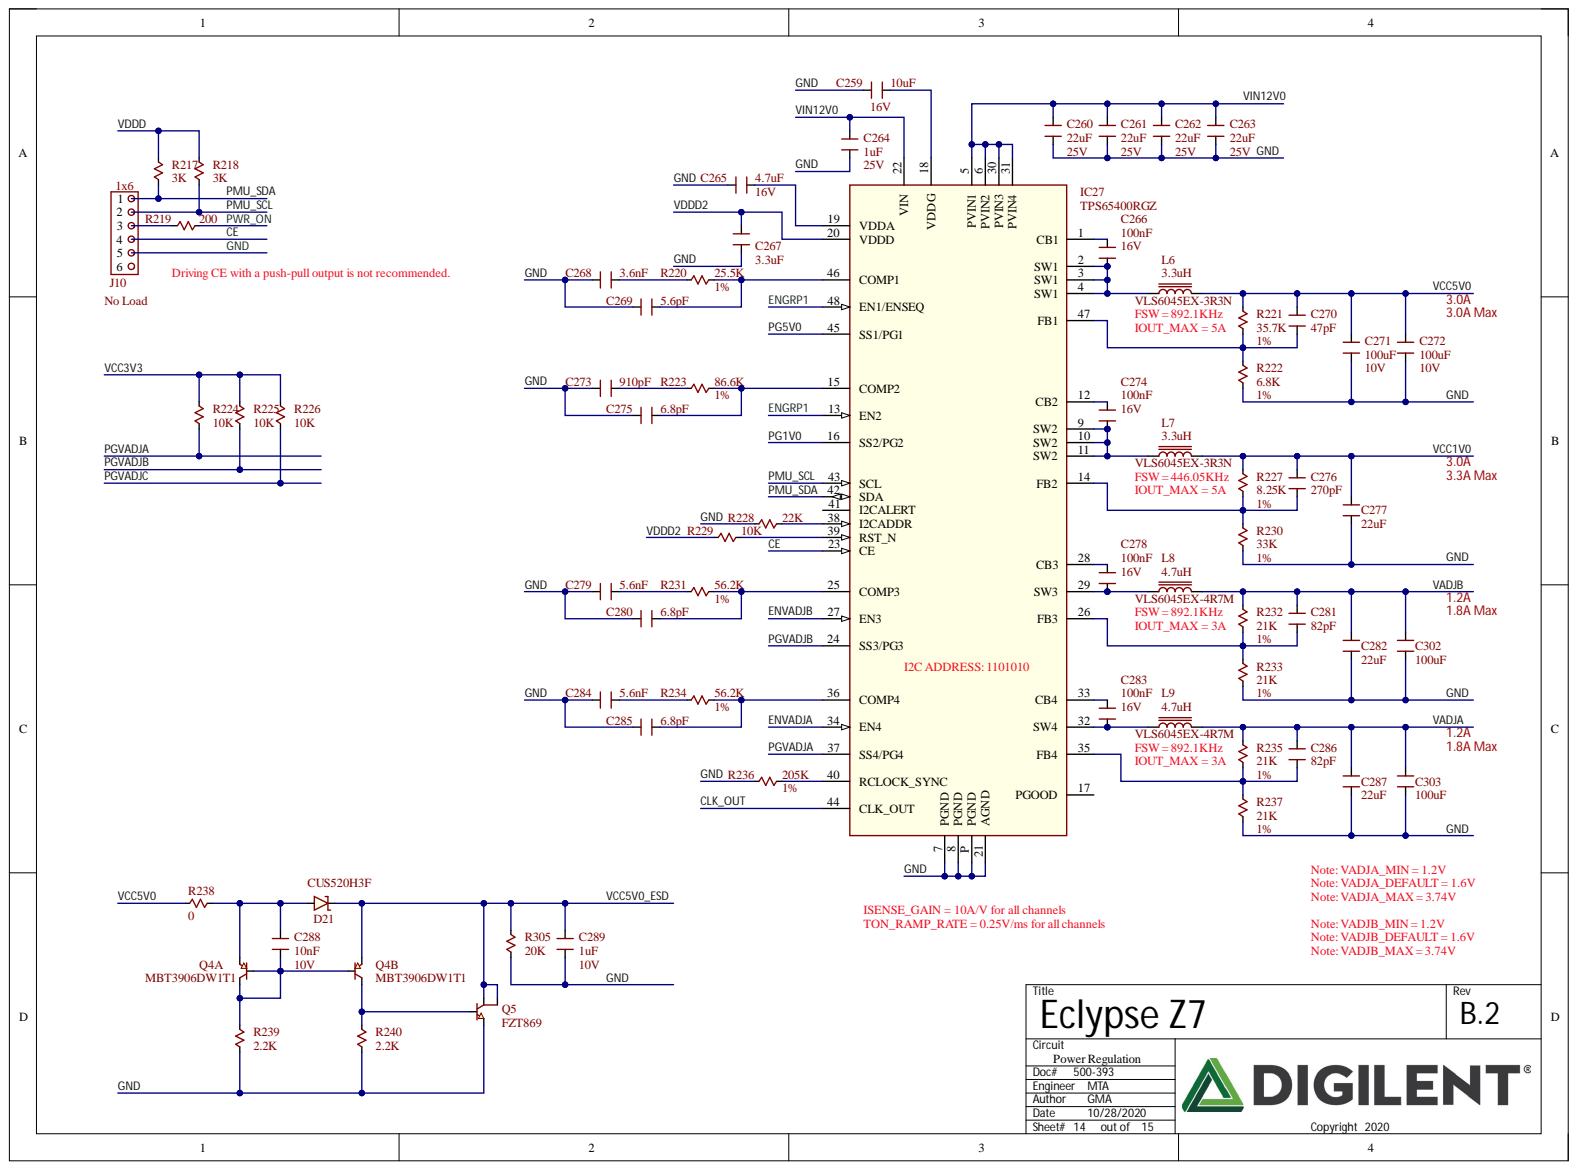
[picture p76: page 14]

Driving CE with a push-pull output is not recommended.

ISENSE_GAIN = 10A/V for all channels
TON_RAMP_RATE = 0.25V/ms for all channels

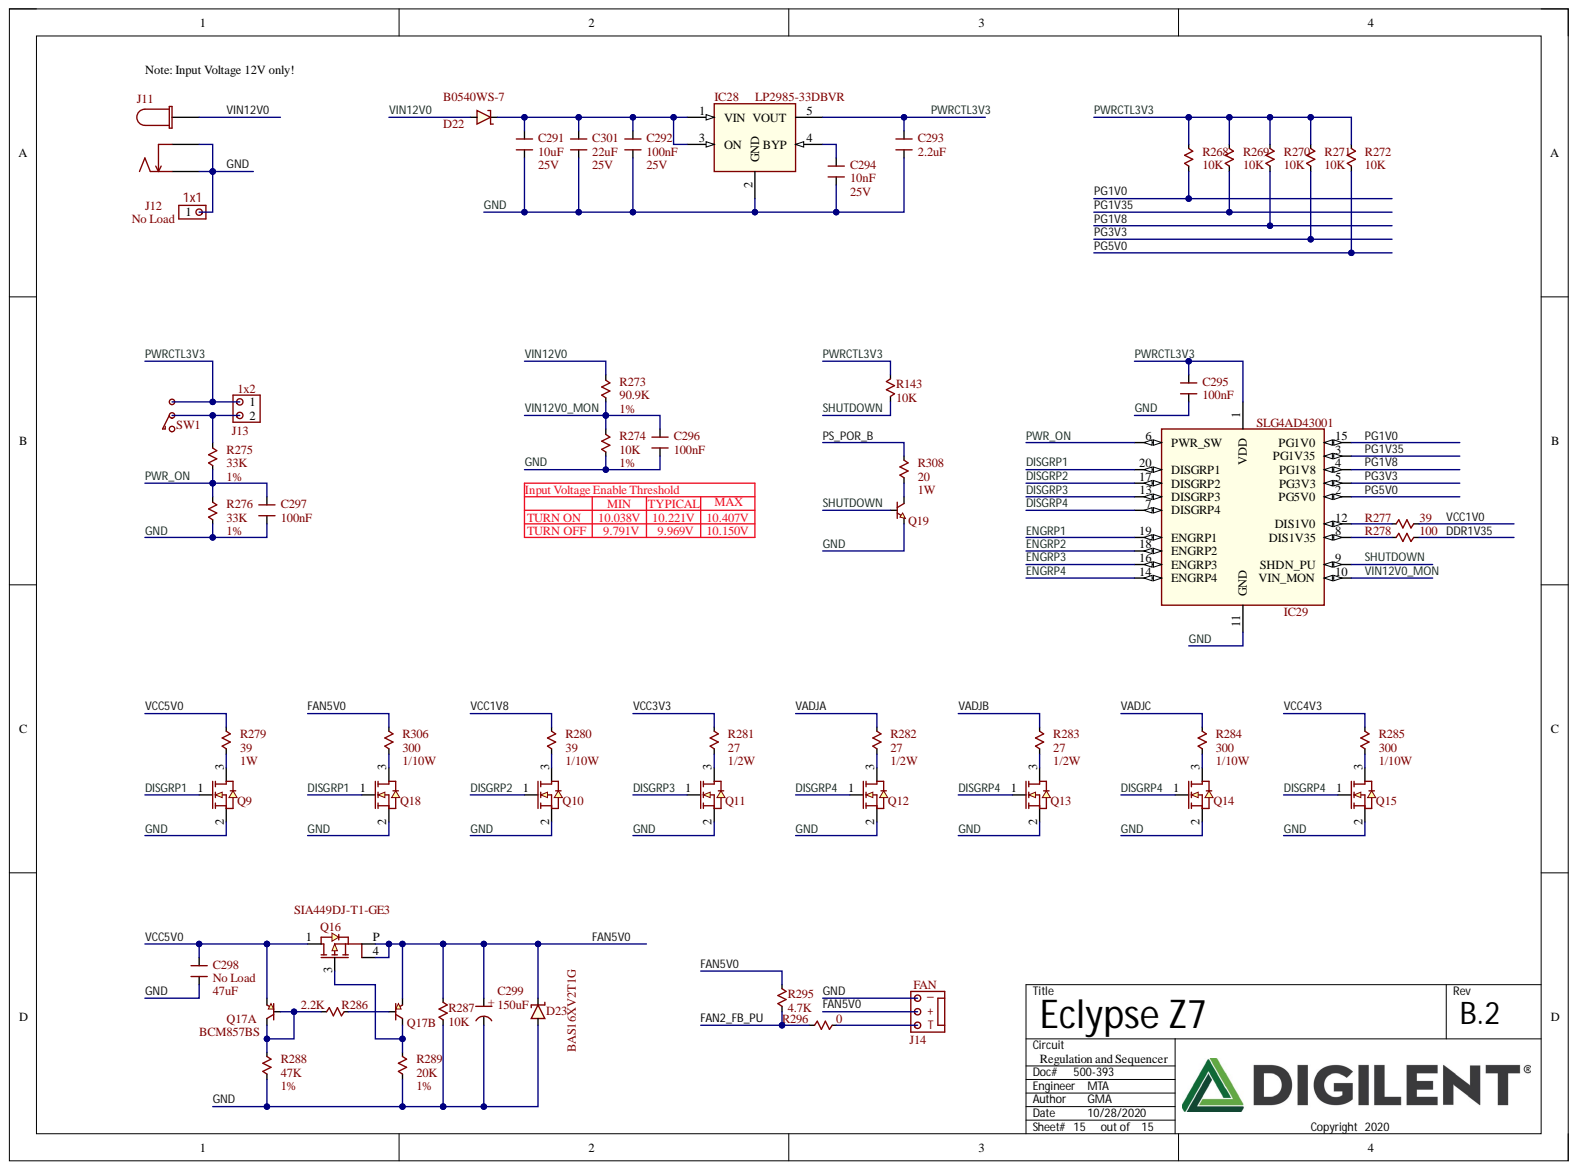
[picture p77: page 15]

Note: Input Voltage 12V only!

Input Voltage Enable Threshold
