uw-acme/NANO_QLASER/documents/Hardware/Xilinx/ps1_jesd_x2.pdf

## tx_core_clk must be 1/40 of line rate LMFS = 2441

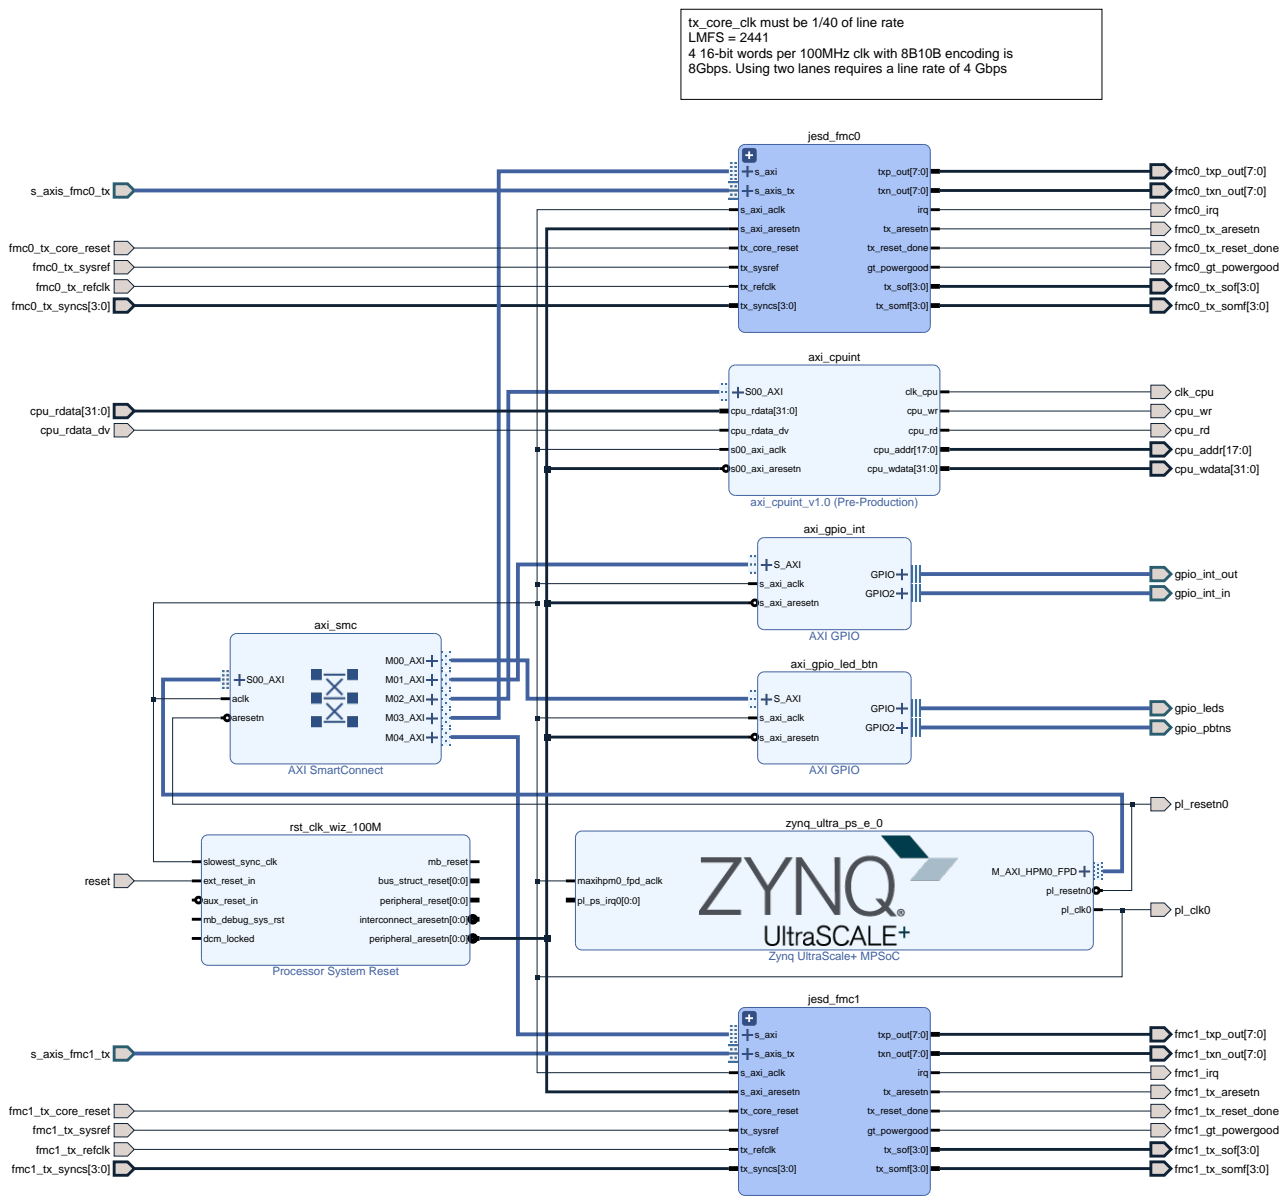
[picture p78: page 1]
axi_cpuint; axi_cpuint_v1.0 (Pre-Production); S00_AXI; clk_cpu; cpu_wr; cpu_rd; cpu_addr[17:0]; cpu_wdata[31:0]; cpu_rdata[31:0]; cpu_rdata_dv; s00_axi_aclk; s00_axi_aresetn; axi_gpio_int; AXI GPIO; S_AXI; GPIO; GPIO2; s_axi_aclk; s_axi_aresetn; axi_gpio_led_btn; axi_smc; AXI SmartConnect; M00_AXI; M01_AXI; M02_AXI; M03_AXI; M04_AXI; aclk; aresetn; fmc0_tx_sof[3:0]; fmc0_tx_syncs[3:0]; fmc0_tx_somf[3:0]; fmc0_txn_out[7:0]; fmc0_txp_out[7:0]; fmc1_tx_sof[3:0]; fmc1_tx_syncs[3:0]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

4 16-bit words per 100MHz clk with 8B10B encoding is
8Gbps. Using two lanes requires a line rate of 4 Gbps

Zynq UltraScale+ MPSoC

Processor System Reset
