uw-acme/NANO_QLASER/documents/Hardware/Xilinx/ps1.pdf

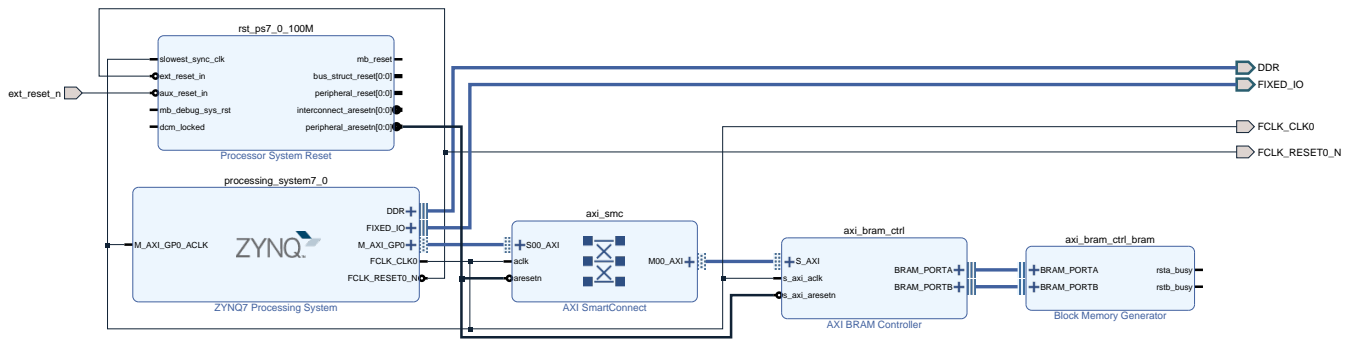
[picture p79: page 1]
ext_reset_n; rst_ps7_0_100M; slowest_sync_clk; ext_reset_in; aux_reset_in; mb_debug_sys_rst; dcm_locked; mb_reset; bus_struct_reset[0:0]; peripheral_reset[0:0]; interconnect_aresetn[0:0]; peripheral_aresetn[0:0]; processing_system7_0; ZYNQ7 Processing System; DDR; FIXED_IO; M_AXI_GP0_ACLK; M_AXI_GP0; FCLK_CLK0; FCLK_RESET0_N; axi_smc; AXI SmartConnect; S00_AXI; aclk; M00_AXI; aresetn; axi_bram_ctrl; S_AXI; BRAM_PORTA; BRAM_PORTB; s_axi_aclk; s_axi_aresetn; axi_bram_ctrl_bram; rsta_busy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

Processor System Reset

Block Memory Generator

AXI BRAM Controller
