uw-acme/NANO_QLASER/documents/JESD/JESD204/Demystifying-Deterministic-Latency-Within-JESD204B-Converters-MS-2626.pdf

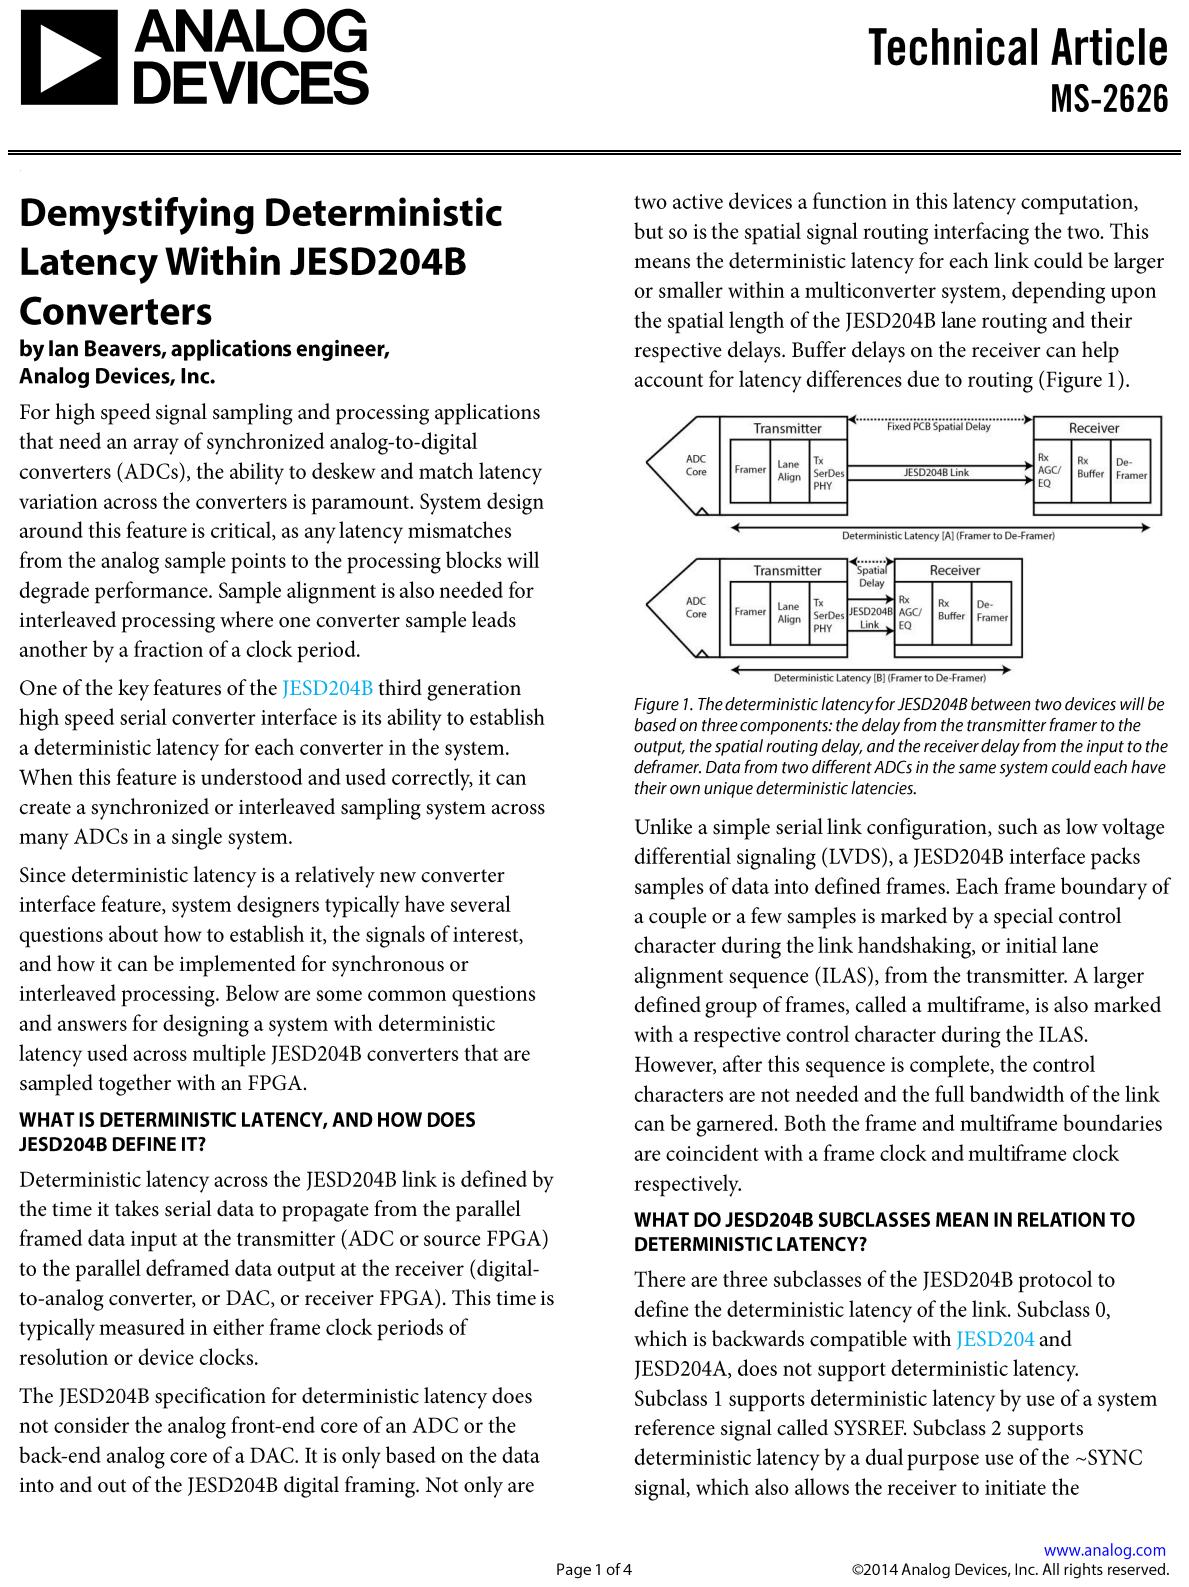
[picture p80: page 1]

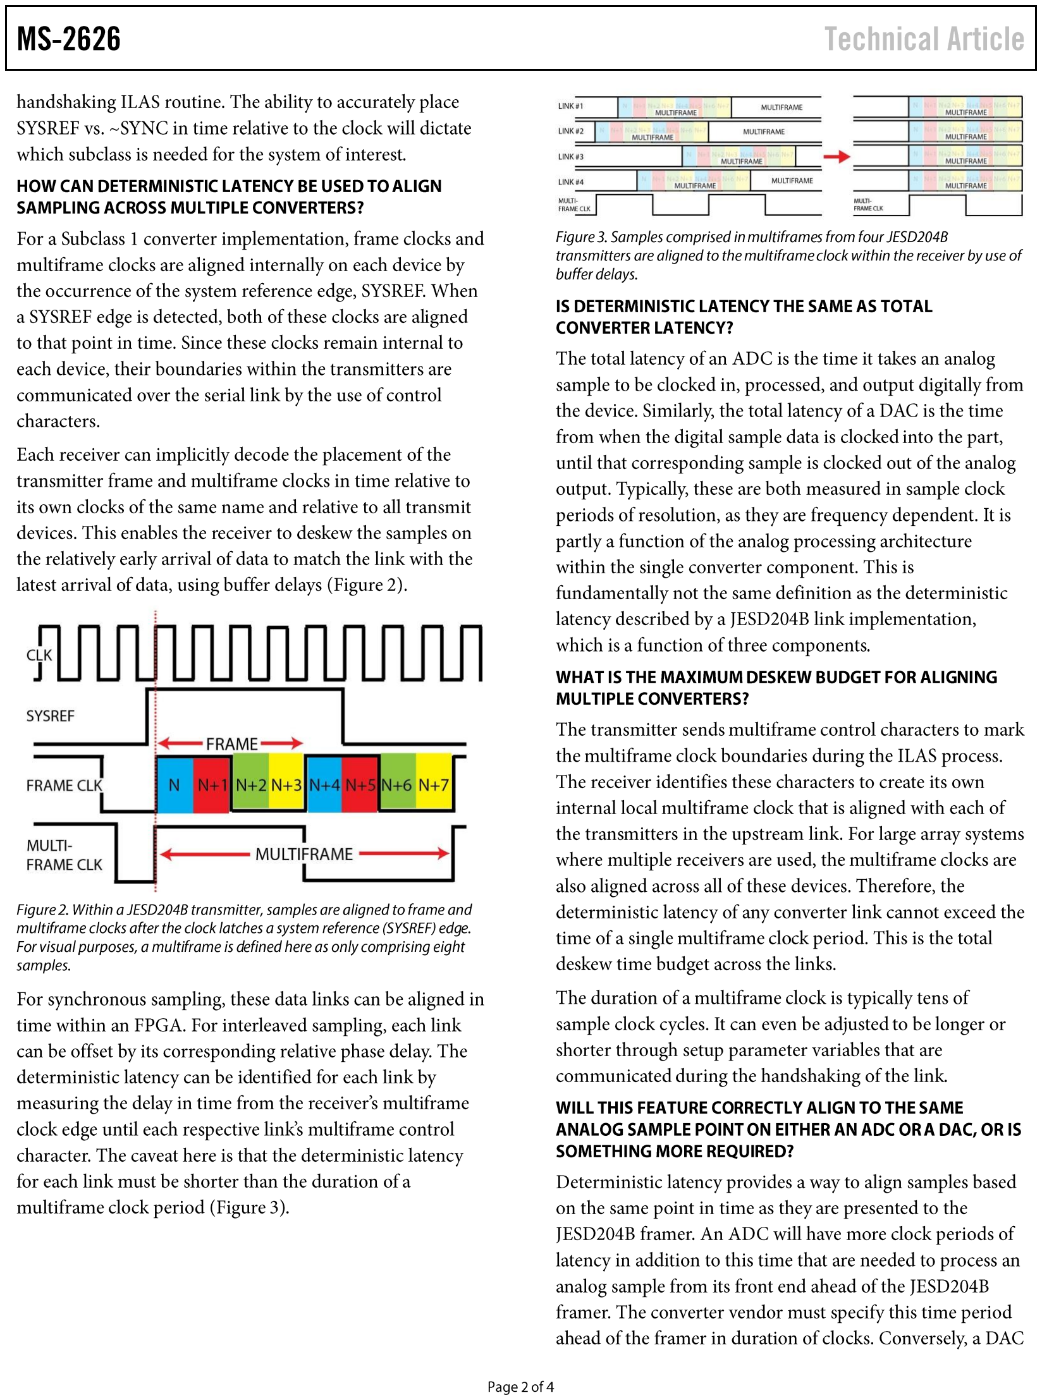
[picture p81: page 2]
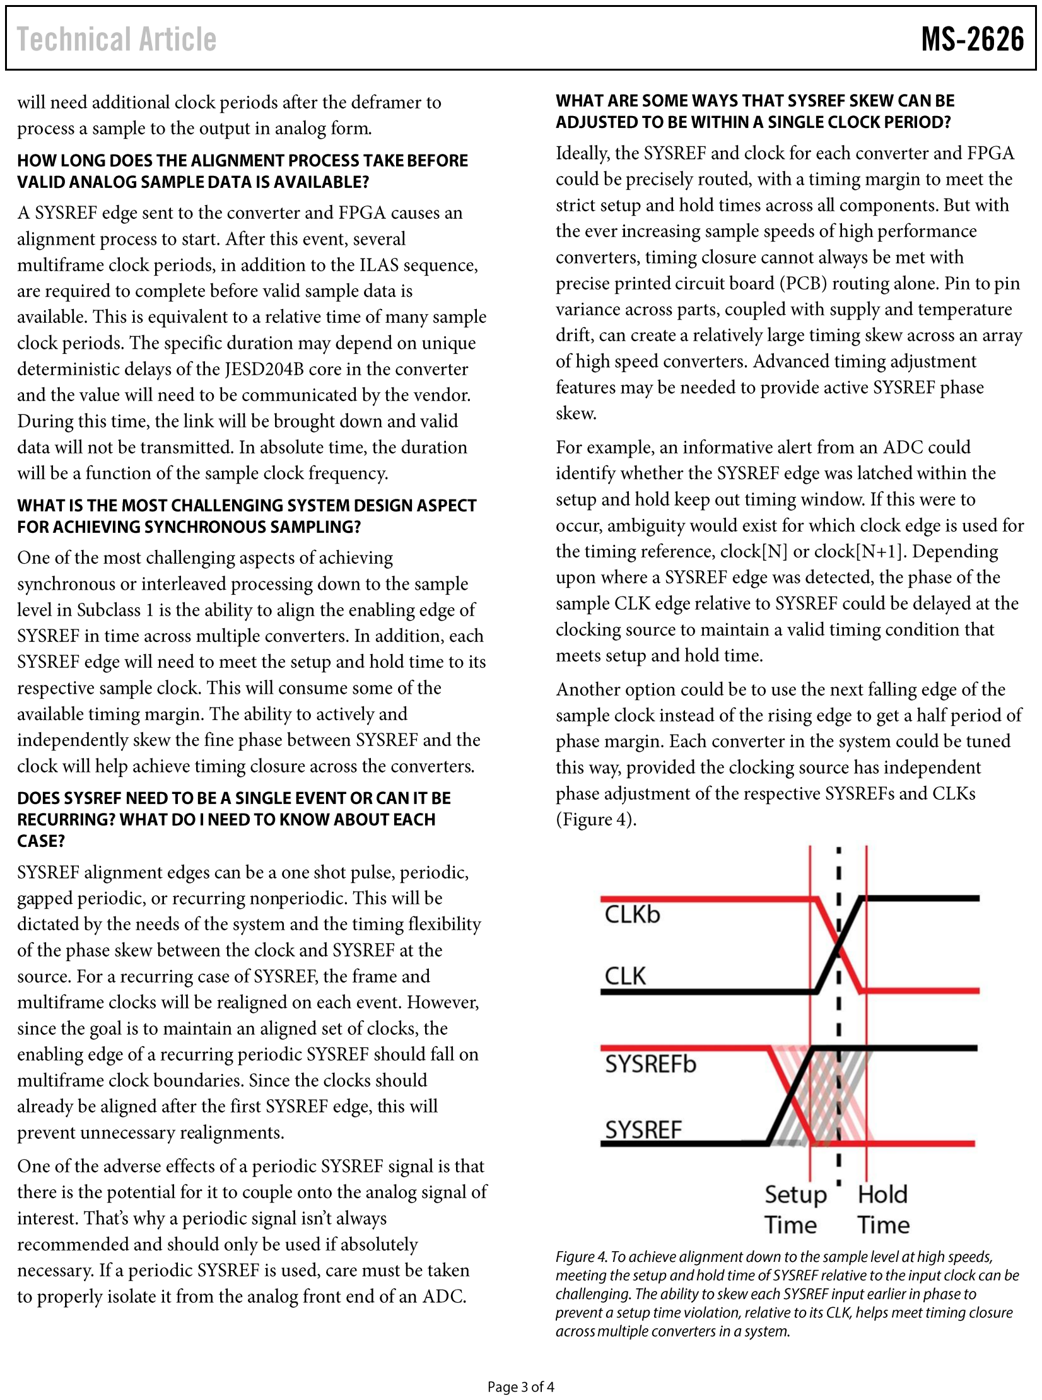
[picture p82: page 3]
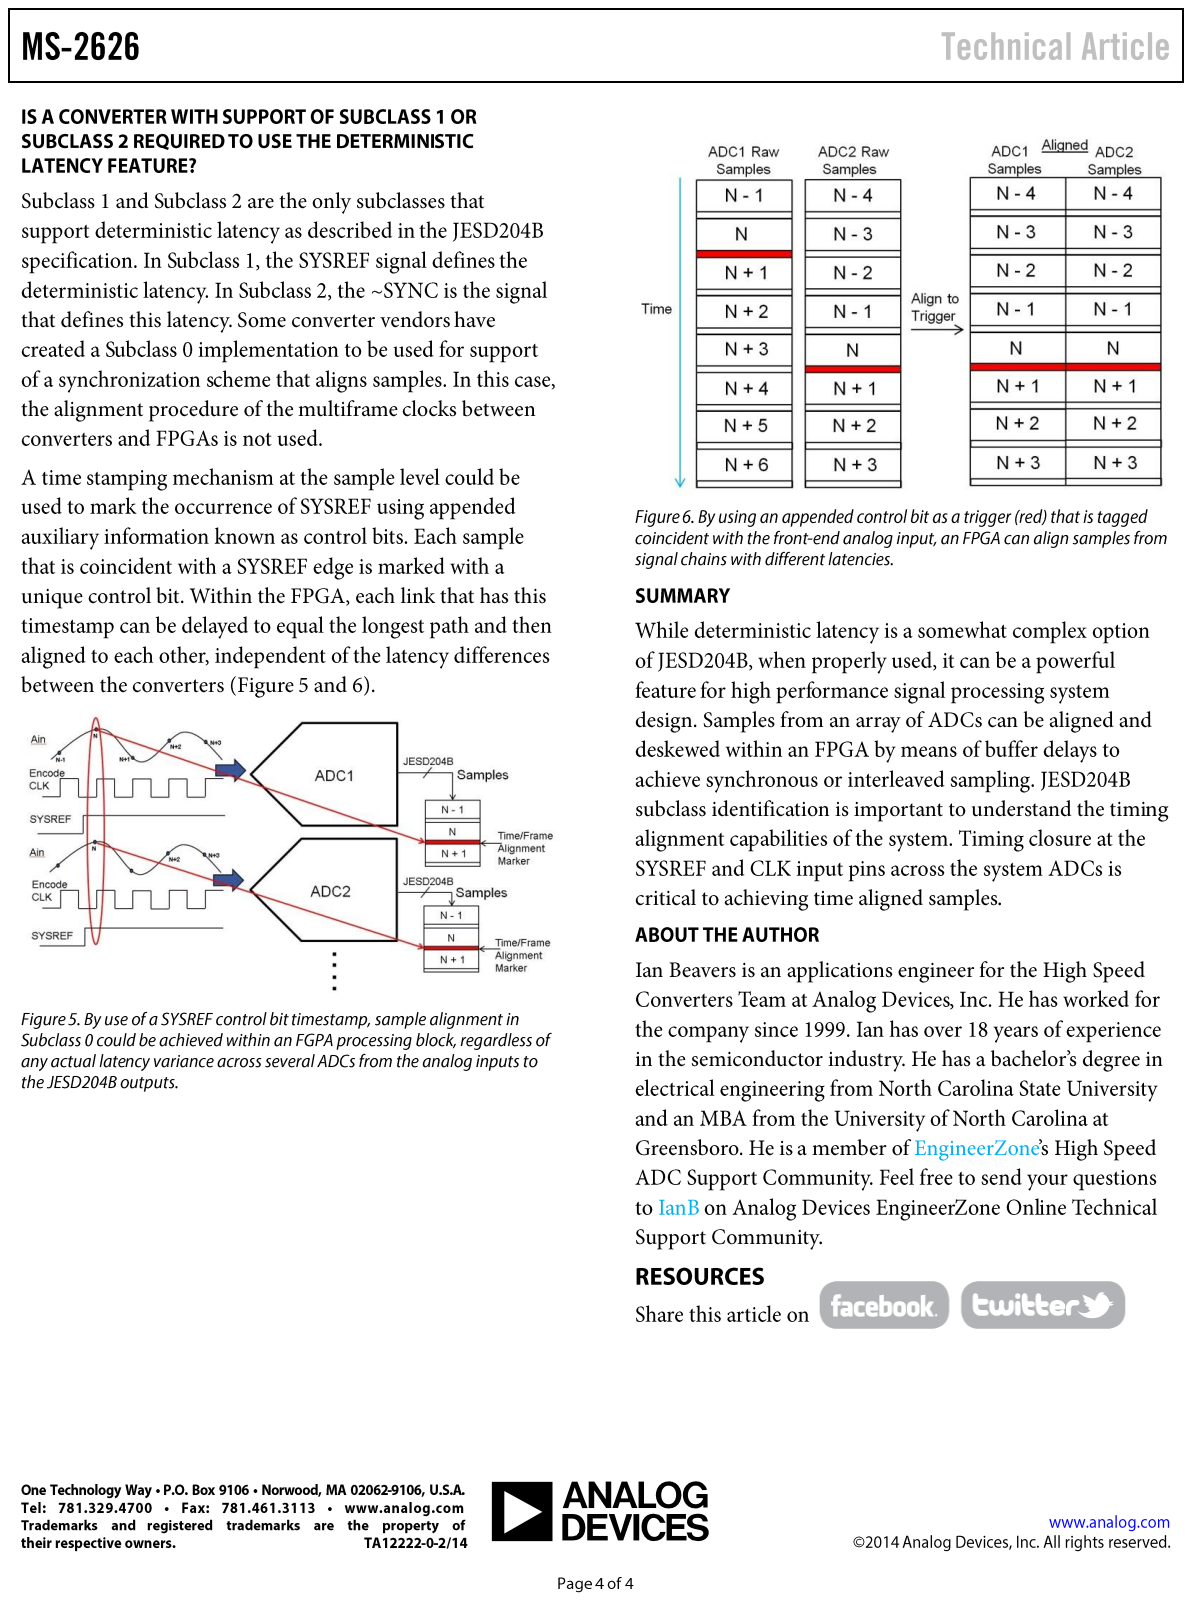
[picture p83: page 4]
