uw-acme/NANO_QLASER/src/hdl/fpga/zcu102/qlaser_top_zcu102_fmc0_2links.vhd

---------------------------------------------------------------
--  File         : qlaser_top_zcu102.vhd
--  Description  : Top-level of Qlaser FPGA with CPU interface 
--                 PL clock and reset come from PS.
--                 Contains 4 PL blocks with a CPU bus driven from PS
--                 qlaser_dacs_dc       :
--                 qlaser_dacs_pulse    :
--                 qlaser_misc          : 
--                 PS (ps1)             : CPU with GPIO and CPUbus interfaces
----------------------------------------------------------------
library ieee;
use     ieee.std_logic_1164.all;
use     ieee.numeric_std.all;
use     ieee.std_logic_misc.all;

use     work.qlaser_pkg.all;

library UNISIM;
use     UNISIM.vcomponents.all;

entity qlaser_top is
port (
    p_reset                 : in    std_logic;          -- Reset. Check polarity is correct 

    -- Interface SPI bus to 8-channel PMOD for DC channels 0-7
    p_dc0_sclk              : out   std_logic;          -- Clock (50 MHz?)
    p_dc0_mosi              : out   std_logic;          -- Master out, Slave in. (Data to DAC)
    p_dc0_cs_n              : out   std_logic;          -- Active low chip select (sync_n)

    -- Interface SPI bus to 8-channel PMOD for DC channels 8-15
    p_dc1_sclk              : out   std_logic;  
    p_dc1_mosi              : out   std_logic;  
    p_dc1_cs_n              : out   std_logic;  

    -- Interface SPI bus to 8-channel PMOD for DC channels 16-23
    p_dc2_sclk              : out   std_logic;  
    p_dc2_mosi              : out   std_logic;  
    p_dc2_cs_n              : out   std_logic;  

    -- Interface SPI bus to 8-channel PMOD for DC channels 24-31
    p_dc3_sclk              : out   std_logic; 
    p_dc3_mosi              : out   std_logic;  
    p_dc3_cs_n              : out   std_logic;  

    -- User buttons
    p_btn_e                 : in    std_logic; 
    p_btn_s                 : in    std_logic; 
    p_btn_n                 : in    std_logic; 
    p_btn_w                 : in    std_logic; 
    p_btn_c                 : in    std_logic; 

    -- Indicator LEDs
    p_leds                  : out   std_logic_vector( 7 downto 0);      -- 

    -- Interface to DAC board through FMC0 (HPC)
    p_fmc0_tx_sync_p        : in    std_logic_vector( 3 downto 0);  -- LVS sync for each link
    p_fmc0_tx_sync_n        : in    std_logic_vector( 3 downto 0);
    p_fmc0_tx_sysref_p      : in    std_logic;
    p_fmc0_tx_sysref_n      : in    std_logic;
    p_fmc0_tx_refclk_p      : in    std_logic;
    p_fmc0_tx_refclk_n      : in    std_logic;

    -- Differential JESD outputs for FMC0. 8 lanes in 4 links
    p_fmc0_txp_out          : out   std_logic_vector( 7 downto 0);  
    p_fmc0_txn_out          : out   std_logic_vector( 7 downto 0);

    -- Debug port (if present)
    p_debug_out             : out   std_logic_vector( 7 downto 0)       -- 
);
end entity;

---------------------------------------------------------------------------
-- Version of the ZCU102 using only FMC0 with two JESD IP blocks (links)
-- with 2 lanes per link.
-- A full FMC216 connection has 4 links, one to each DAC.
---------------------------------------------------------------------------
architecture zc102_fmc0_x2 of qlaser_top is

signal clk                  : std_logic;
signal reset                : std_logic;

-- CPU interface
signal cpu_sels             : std_logic_vector(C_NUM_BLOCKS-1 downto 0);    -- CPU block selects 
signal cpu_wr               : std_logic;
signal cpu_addr             : std_logic_vector(13 downto 0);
signal cpu_din              : std_logic_vector(31 downto 0);
signal cpu_debug            : std_logic_vector( 3 downto 0);

signal arr_cpu_dout         : t_arr_cpu_dout;
signal arr_cpu_dout_dv      : std_logic_vector(C_NUM_BLOCKS-1 downto 0);

constant SEL_DAC_DC         : integer :=  0;    -- For DC DACs
constant SEL_DAC_PULSE      : integer :=  1;    -- For Pulse DACs
constant SEL_MISC           : integer :=  2;    -- Misc, LEDs, switches, version number etc.
constant SEL_SPARE          : integer :=  3;    -- Spare

signal misc_leds            : std_logic_vector( 3 downto 0);
signal misc_leds_en         : std_logic_vector( 3 downto 0);
signal misc_flash           : std_logic;
signal tick_msec            : std_logic;                        --  Timing intervals
signal tick_sec             : std_logic;            
signal misc_dbg_ctrl        : std_logic_vector( 3 downto 0);
signal misc_trigger         : std_logic;

-- PS (Processor) outputs to PL
signal ps_clk0                  : std_logic;
signal ps_resetn0               : std_logic;
signal ps_leds                  : std_logic_vector( 7 downto 0);
signal ps_gpin                  : std_logic_vector(31 downto 0);
signal ps_gpout                 : std_logic_vector(31 downto 0);
-- Connections to PS axi_cpuint IP block
signal ps_clk_cpu               : std_logic;
signal ps_cpu_addr              : std_logic_vector(17 downto 0);
signal ps_cpu_wdata             : std_logic_vector(31 downto 0);
signal ps_cpu_wr                : std_logic;
signal ps_cpu_rd                : std_logic;
signal cif_cpu_rdata            : std_logic_vector( 31 downto 0);
signal cif_cpu_rdata_dv         : std_logic;

signal pulse                    : std_logic_vector( 3 downto 0);
signal pulse_stretched          : std_logic_vector( 3 downto 0);

signal trigger_dacs_pulse       : std_logic;
signal ps_enable_dacs_pulse     : std_logic;

signal any_dacs_busy            : std_logic;
signal dacs_dc_busy             : std_logic_vector( 3 downto 0);    -- Set to '1' while SPI bus is busy
signal dacs_pulse_ready         : std_logic;                        -- Status signal indicating all JESD channels are sync'ed.
signal dacs_pulse_busy          : std_logic;                        -- Running a waveform generation sequence.
signal dacs_pulse_error         : std_logic;                        -- Instantanous JESD sync status.
signal dacs_pulse_error_latched : std_logic;                        -- JESD lost sync after ready. Cleared by trigger
                
 -- Array of 32 AXI-Stream buses. Each with 16-bit data. Interface to JESD TX Interfaces
signal dacs_pulse_axis_treadys  : std_logic_vector(31 downto 0);    -- axi_stream ready from downstream modules
signal dacs_pulse_axis_tdatas   : t_arr_slv32x16b;                  -- axi stream output data array
signal dacs_pulse_axis_tvalids  : std_logic_vector(31 downto 0);    -- axi_stream output data valid
signal dacs_pulse_axis_tlasts   : std_logic_vector(31 downto 0);    -- axi_stream output set on last data  

signal gpio_btns                : std_logic_vector( 4 downto 0); 

-- JESD_0 interface (4 links, each with 2 lanes)
signal axis_fmc0_tx0_tdata      : std_logic_vector(63 downto 0);
signal axis_fmc0_tx0_tready     : std_logic;
signal axis_fmc0_tx1_tdata      : std_logic_vector(63 downto 0);
signal axis_fmc0_tx1_tready     : std_logic;
signal axis_fmc0_tx2_tdata      : std_logic_vector(63 downto 0);
signal axis_fmc0_tx2_tready     : std_logic;
signal axis_fmc0_tx3_tdata      : std_logic_vector(63 downto 0);
signal axis_fmc0_tx3_tready     : std_logic;

signal fmc0_tx_core_reset       : std_logic;
signal fmc0_tx_refclk           : std_logic;
signal fmc0_tx_sysref           : std_logic;
signal fmc0_tx_syncs            : std_logic_vector( 3 downto 0);

signal fmc0_txp_out             : std_logic_vector( 7 downto 0);
signal fmc0_txn_out             : std_logic_vector( 7 downto 0);
signal fmc0_tx_sof              : std_logic_vector(15 downto 0);
signal fmc0_tx_sofm             : std_logic_vector(15 downto 0);
signal fmc0_tx_aresetn          : std_logic_vector( 3 downto 0);
signal fmc0_tx_reset_done       : std_logic_vector( 3 downto 0);
signal fmc0_gt_pgood            : std_logic_vector( 3 downto 0);
signal fmc0_irq                 : std_logic_vector( 3 downto 0);

-- One for each link.
signal jesd_syncs               : std_logic_vector(31 downto 0) := (others=>'1');

begin

    clk     <= ps_clk0;
    reset   <= not(ps_resetn0);

    -- Combine p_btn trigger (from pad) with misc block trigger and ps_gpout(0) to create internal trigger
    trigger_dacs_pulse      <= p_btn_c or misc_trigger or ps_gpout(0);
    ps_enable_dacs_pulse    <= ps_gpout(1);
    any_dacs_busy           <= dacs_dc_busy(0) or dacs_dc_busy(1) or dacs_dc_busy(2) or dacs_dc_busy(3) or dacs_pulse_busy;

    
    gpio_btns(0)            <= p_btn_e;
    gpio_btns(1)            <= p_btn_s;
    gpio_btns(2)            <= p_btn_n;
    gpio_btns(3)            <= p_btn_w;
    gpio_btns(4)            <= p_btn_c;


    ---------------------------------------------------------------------------------
    -- Processing system.  CPU, JESD interfaces, Console UART etc
    ---------------------------------------------------------------------------------
    u_ps1 : entity work.ps1_wrapper
    port map(
        reset                   => p_reset                  , -- in  std_logic
        
        -- Signals to/from axi_cpuint peripheral
        clk_cpu                 => ps_clk_cpu               , -- out std_logic;
        cpu_addr                => ps_cpu_addr              , -- out std_logic_vector(17 downto 0);
        cpu_wdata               => ps_cpu_wdata             , -- out std_logic_vector(31 downto 0);
        cpu_wr                  => ps_cpu_wr                , -- out std_logic;
        cpu_rd                  => ps_cpu_rd                , -- out std_logic;
        cpu_rdata               => cif_cpu_rdata            , -- in  std_logic_vector( 31 downto 0);
        cpu_rdata_dv            => cif_cpu_rdata_dv         , -- in  std_logic;

        pl_clk0                 => ps_clk0                  , -- out std_logic;
        pl_resetn0              => ps_resetn0               , -- out std_logic;

        gpio_leds_tri_o         => ps_leds                  , -- out std_logic_vector( 7 downto 0);
        gpio_pbtns_tri_i        => gpio_btns                , -- in  std_logic_vector( 4 downto 0);

        gpio_int_in_tri_i       => ps_gpin                  , -- in  std_logic_vector(31 downto 0);
        gpio_int_out_tri_o      => ps_gpout                 , -- out std_logic_vector(31 downto 0);

        ------------------------------------------------------------------------    
        -- JESD_0 interface (4 links, each with 2 lanes)
        ------------------------------------------------------------------------    
        s_axis_fmc0_tx0_tdata   => axis_fmc0_tx0_tdata      , -- in  std_logic_vector(63 downto 0);
        s_axis_fmc0_tx0_tready  => axis_fmc0_tx0_tready     , -- out std_logic;
        s_axis_fmc0_tx1_tdata   => axis_fmc0_tx1_tdata      , -- in  std_logic_vector(63 downto 0);
        s_axis_fmc0_tx1_tready  => axis_fmc0_tx1_tready     , -- out std_logic;
        s_axis_fmc0_tx2_tdata   => axis_fmc0_tx2_tdata      , -- in  std_logic_vector(63 downto 0);
        s_axis_fmc0_tx2_tready  => axis_fmc0_tx2_tready     , -- out std_logic;
        s_axis_fmc0_tx3_tdata   => axis_fmc0_tx3_tdata      , -- in  std_logic_vector(63 downto 0);
        s_axis_fmc0_tx3_tready  => axis_fmc0_tx3_tready     , -- out std_logic;

        fmc0_tx_core_reset      => fmc0_tx_core_reset       , -- in  std_logic;
        fmc0_tx_refclk          => fmc0_tx_refclk           , -- in  std_logic;
        fmc0_tx_sysref          => fmc0_tx_sysref           , -- in  std_logic;
        fmc0_tx_syncs           => fmc0_tx_syncs            , -- in  std_logic_vector( 3 downto 0);
        fmc0_txp_out            => fmc0_txp_out             , -- out std_logic_vector( 7 downto 0);
        fmc0_txn_out            => fmc0_txn_out             , -- out std_logic_vector( 7 downto 0);
        fmc0_tx_sof             => fmc0_tx_sof              , -- out std_logic_vector(15 downto 0);
        fmc0_tx_sofm            => fmc0_tx_sofm             , -- out std_logic_vector(15 downto 0);
        fmc0_tx_aresetn         => fmc0_tx_aresetn          , -- out std_logic_vector( 3 downto 0);
        fmc0_tx_reset_done      => fmc0_tx_reset_done       , -- out std_logic_vector( 3 downto 0);
        fmc0_gt_pgood           => fmc0_gt_pgood            , -- out std_logic_vector( 3 downto 0);
        fmc0_irq                => fmc0_irq                   -- out std_logic_vector( 3 downto 0)
    );
    -- Connect FMC0 control and status signals to PS GPIOs
    ps_gpin(3 downto 0)     <= fmc0_tx_reset_done;
    ps_gpin(7 downto 4)     <= fmc0_gt_pgood;
    fmc0_tx_core_reset      <= ps_gpout(4);

    -- Connect JESD data lines to pads
    p_fmc0_txp_out          <= fmc0_txp_out;  
    p_fmc0_txn_out          <= fmc0_txn_out;  

    -- Instantiate differential pads for FMC0 sync inputs
    -- TODO fmc0_tx_sync0,1,2,3
    u_sync0 : IBUFDS  
    port map(
        I     => p_fmc0_tx_sync_p(0),
        IB    => p_fmc0_tx_sync_n(0),
        O     => fmc0_tx_syncs(0)
    );
    u_sync1 : IBUFDS  
    port map(
        I     => p_fmc0_tx_sync_p(1),
        IB    => p_fmc0_tx_sync_n(1),
        O     => fmc0_tx_syncs(1)
    );
    u_sync2 : IBUFDS  
    port map(
        I     => p_fmc0_tx_sync_p(2),
        IB    => p_fmc0_tx_sync_n(2),
        O     => fmc0_tx_syncs(2)
    );
    u_sync3 : IBUFDS  
    port map(
        I     => p_fmc0_tx_sync_p(3),
        IB    => p_fmc0_tx_sync_n(3),
        O     => fmc0_tx_syncs(3)
    );

    --jesd_syncs  <=   fmc1_tx_sync3 & fmc1_tx_sync3 & fmc1_tx_sync3 & fmc1_tx_sync3 
    --               & fmc1_tx_sync2 & fmc1_tx_sync2 & fmc1_tx_sync2 & fmc1_tx_sync2  
    --               & fmc1_tx_sync1 & fmc1_tx_sync1 & fmc1_tx_sync1 & fmc1_tx_sync1  
    --               & fmc1_tx_sync0 & fmc1_tx_sync0 & fmc1_tx_sync0 & fmc1_tx_sync0  
    --               & fmc0_tx_sync3 & fmc0_tx_sync3 & fmc0_tx_sync3 & fmc0_tx_sync3  
    --               & fmc0_tx_sync2 & fmc0_tx_sync2 & fmc0_tx_sync2 & fmc0_tx_sync2  
    --               & fmc0_tx_sync1 & fmc0_tx_sync1 & fmc0_tx_sync1 & fmc0_tx_sync1  
    --               & fmc0_tx_sync0 & fmc0_tx_sync0 & fmc0_tx_sync0 & fmc0_tx_sync0; 
    jesd_syncs  <= (others=>'1'); 

    -- Instantiate differential pads for FMC0 clock inputs
    u_sysref : IBUFDS 
    port map(
        I     => p_fmc0_tx_sysref_p,
        IB    => p_fmc0_tx_sysref_n,
        O     => fmc0_tx_sysref
    );
    u_refclk : IBUFDS_GTE4  
    port map(
        I     => p_fmc0_tx_refclk_p,
        IB    => p_fmc0_tx_refclk_n,
        ODIV2 => open,
        CEB   => '0',
        O     => fmc0_tx_refclk
    );



    -- Connect pulse generator outputs to JESD AXI-Stream port
    -- Each link (2 lanes) transmits data for four 16-bit converters in a DAC chip
    axis_fmc0_tx0_tdata         <= dacs_pulse_axis_tdatas(3) & dacs_pulse_axis_tdatas(2) 
                                 & dacs_pulse_axis_tdatas(1) & dacs_pulse_axis_tdatas(0);
    dacs_pulse_axis_treadys(0)  <= axis_fmc0_tx0_tready;
    dacs_pulse_axis_treadys(1)  <= axis_fmc0_tx0_tready;
    dacs_pulse_axis_treadys(2)  <= axis_fmc0_tx0_tready;
    dacs_pulse_axis_treadys(3)  <= axis_fmc0_tx0_tready;

    axis_fmc0_tx1_tdata         <= dacs_pulse_axis_tdatas(7) & dacs_pulse_axis_tdatas(6) 
                                 & dacs_pulse_axis_tdatas(5) & dacs_pulse_axis_tdatas(4);
    dacs_pulse_axis_treadys(4)  <= axis_fmc0_tx1_tready;
    dacs_pulse_axis_treadys(5)  <= axis_fmc0_tx1_tready;
    dacs_pulse_axis_treadys(6)  <= axis_fmc0_tx1_tready;
    dacs_pulse_axis_treadys(7)  <= axis_fmc0_tx1_tready;

    axis_fmc0_tx2_tdata         <= dacs_pulse_axis_tdatas(11) & dacs_pulse_axis_tdatas(10) 
                                 & dacs_pulse_axis_tdatas(8) & dacs_pulse_axis_tdatas(8);
    dacs_pulse_axis_treadys(8)  <= axis_fmc0_tx2_tready;
    dacs_pulse_axis_treadys(9)  <= axis_fmc0_tx2_tready;
    dacs_pulse_axis_treadys(10) <= axis_fmc0_tx2_tready;
    dacs_pulse_axis_treadys(11) <= axis_fmc0_tx2_tready;

    axis_fmc0_tx3_tdata         <= dacs_pulse_axis_tdatas(15) & dacs_pulse_axis_tdatas(14) 
                                 & dacs_pulse_axis_tdatas(13) & dacs_pulse_axis_tdatas(12);
    dacs_pulse_axis_treadys(12) <= axis_fmc0_tx3_tready;
    dacs_pulse_axis_treadys(13) <= axis_fmc0_tx3_tready;
    dacs_pulse_axis_treadys(14) <= axis_fmc0_tx3_tready;
    dacs_pulse_axis_treadys(15) <= axis_fmc0_tx3_tready;


    ---------------------------------------------------------------------------------
    -- Adapter from PS CPU interface and PL CPU bus. 
    -- Generates block selects and merges rdata readback.
    ---------------------------------------------------------------------------------
    u_cif : entity work.qlaser_cif      -- Cpu InterFace
    port map(
        clk                 => clk                  , -- in  std_logic;
        reset               => reset                , -- in  std_logic;
        -- From PS
        ps_clk_cpu          => ps_clk_cpu           , -- in  std_logic;
        ps_cpu_addr         => ps_cpu_addr          , -- in  std_logic_vector(17 downto 0);
        ps_cpu_wdata        => ps_cpu_wdata         , -- in  std_logic_vector(31 downto 0);
        ps_cpu_wr           => ps_cpu_wr            , -- in  std_logic;
        ps_cpu_rd           => ps_cpu_rd            , -- in  std_logic;
        -- to PS
        ps_cpu_rdata        => cif_cpu_rdata        , -- out std_logic_vector( 31 downto 0);
        ps_cpu_rdata_dv     => cif_cpu_rdata_dv     , -- out std_logic;

        -- to CPU peripherals
        cpu_addr            => cpu_addr             , -- out std_logic_vector(15 downto 2);             -- Address input to core blocks (13:0)
        cpu_wdata           => cpu_din              , -- out std_logic_vector(31 downto 0);             -- Data input
        cpu_wr              => cpu_wr               , -- out std_logic;                                 -- Write enable 
        cpu_sels            => cpu_sels             , -- out std_logic_vector(C_NUM_BLOCKS-1 downto 0); -- Block select
        -- from CPU peripherals
        arr_cpu_rdata       => arr_cpu_dout         , -- in  t_arr_cpu_dout                             -- Data output
        arr_cpu_rdata_dv    => arr_cpu_dout_dv        -- in  std_logic_vector(C_NUM_BLOCKS-1 downto 0); -- Acknowledge output
    );


    ---------------------------------------------------------------------------------
    -- DC DAC interface
    ---------------------------------------------------------------------------------
    u_dacs_dc : entity work.qlaser_dacs_dc
    port map(
        clk                 => clk                          , -- in  std_logic; 
        reset               => reset                        , -- in  std_logic;
    
        busy                => dacs_dc_busy                 , -- out std_logic_vector( 3 downto 0);    -- Set to '1' while pulse outputs are occurring
    
        -- CPU interface
        cpu_addr            => cpu_addr(5 downto 0)         , -- in  std_logic_vector(5 downto 0);    -- Address input
        cpu_wdata           => cpu_din(11 downto 0)         , -- in  std_logic_vector(31 downto 0);    -- Data input
        cpu_wr              => cpu_wr                       , -- in  std_logic;                        -- Write enable 
        cpu_sel             => cpu_sels(SEL_DAC_DC)         , -- in  std_logic;                        -- Block select
        cpu_rdata           => arr_cpu_dout(SEL_DAC_DC)     , -- out std_logic_vector(31 downto 0);    -- Data output
        cpu_rdata_dv        => arr_cpu_dout_dv(SEL_DAC_DC)  , -- out std_logic;                        -- Acknowledge output
                       
        -- Interface SPI bus to 8-channel PMOD for DC channels 0-7
        dc0_sclk            => p_dc0_sclk                   , -- out   std_logic;          -- Clock (50 MHz?)
        dc0_mosi            => p_dc0_mosi                   , -- out   std_logic;          -- Master out, Slave in. (Data to DAC)
        dc0_cs_n            => p_dc0_cs_n                   , -- out   std_logic;          -- Active low chip select (sync_n)
        --
        -- Interface SPI bus to 8-channel PMOD for DC channels 8-15
        dc1_sclk            => p_dc1_sclk                   , -- out   std_logic;  
        dc1_mosi            => p_dc1_mosi                   , -- out   std_logic;  
        dc1_cs_n            => p_dc1_cs_n                   , -- out   std_logic;  
        
        -- Interface SPI bus to 8-channel PMOD for DC channels 16-23
        dc2_sclk            => open                         , -- out   std_logic;  
        dc2_mosi            => open                         , -- out   std_logic;  
        dc2_cs_n            => open                         , -- out   std_logic;  
        
        -- Interface SPI bus to 8-channel PMOD for DC channels 24-31
        dc3_sclk            => open                   , -- out   std_logic; 
        dc3_mosi            => open                   , -- out   std_logic;  
        dc3_cs_n            => open                     -- out   std_logic;
        
    );
    
   
    -----------------------------------------------------------------------------------
    ---- Pulse DAC interface
    -----------------------------------------------------------------------------------
    u_dacs_pulse : entity work.qlaser_dacs_pulse
    generic map(
        G_NCHANS            => 32                                 -- integer := 1
    )
    port map(
        clk                 => clk                              , -- in  std_logic; 
        reset               => reset                            , -- in  std_logic;
    
        enable              => ps_enable_dacs_pulse             , -- in  std_logic;                         -- Set when DAC interface is running
        trigger             => trigger_dacs_pulse               , -- in  std_logic;                         -- Set when pulse generation sequence begins (trigger)
        jesd_syncs          => jesd_syncs                       , -- in  std_logic_vector(31 downto 0);     -- Inputs from each JESD TX interface

        -- Status signals
        ready               => dacs_pulse_ready                 , -- out std_logic;                         -- Status signal indicating all JESD channels are sync'ed.
        busy                => dacs_pulse_busy                  , -- out std_logic;                         -- Running a waveform generation sequence.
        error               => dacs_pulse_error                 , -- out std_logic;                         -- Instantanous JESD sync status.
        error_latched       => dacs_pulse_error_latched         , -- out std_logic;                         -- JESD lost sync after ready. Cleared by trigger
    
        -- CPU interface
        cpu_addr            => cpu_addr(12 downto 0)            , -- in  std_logic_vector(11 downto 0);     -- Address input
        cpu_wdata           => cpu_din                          , -- in  std_logic_vector(31 downto 0);     -- Data input
        cpu_wr              => cpu_wr                           , -- in  std_logic;                         -- Write enable 
        cpu_sel             => cpu_sels(SEL_DAC_PULSE)          , -- in  std_logic;                         -- Block select
        cpu_rdata           => arr_cpu_dout(SEL_DAC_PULSE)      , -- out std_logic_vector(31 downto 0);     -- Data output
        cpu_rdata_dv        => arr_cpu_dout_dv(SEL_DAC_PULSE)   , -- out std_logic;                         -- Acknowledge output
                       
        -- Array of 32 AXI-Stream buses. Each with 16-bit data. Interface to JESD TX Interfaces
        axis_treadys        => dacs_pulse_axis_treadys          , -- in  std_logic_vector(31 downto 0);     -- axi_stream ready from downstream modules
        axis_tdatas         => dacs_pulse_axis_tdatas           , -- out t_arr_slv32x16b;                   -- axi stream output data array
        axis_tvalids        => dacs_pulse_axis_tvalids          , -- out std_logic_vector(31 downto 0);     -- axi_stream output data valid
        axis_tlasts         => dacs_pulse_axis_tlasts             -- out std_logic_vector(31 downto 0)      -- axi_stream output set on last data  
    );
    

    ---------------------------------------------------------------------------------
    -- Misc interfaces. LEDs, Debug
    ---------------------------------------------------------------------------------
    u_misc_if : entity work.qlaser_misc
    port map(
        clk                 => clk                      , -- in  std_logic; 
        reset               => reset                    , -- in  std_logic;

        -- CPU interface
        cpu_addr            => cpu_addr(11 downto 0)    , -- in  std_logic_vector(11 downto 0);    -- Address input
        cpu_wdata           => cpu_din                  , -- in  std_logic_vector(31 downto 0);    -- Data input
        cpu_wr              => cpu_wr                   , -- in  std_logic;                        -- Write enable 
        cpu_sel             => cpu_sels(SEL_MISC)       , -- in  std_logic;                        -- Block select
        cpu_rdata           => arr_cpu_dout(SEL_MISC)   , -- out std_logic_vector(31 downto 0);    -- Data output
        cpu_rdata_dv        => arr_cpu_dout_dv(SEL_MISC), -- out std_logic;                        -- Data valid
                       
        pulse               => pulse                    , -- in  std_logic_vector( 3 downto 0);
        pulse_stretched     => pulse_stretched          , -- out std_logic_vector( 3 downto 0);

        -- Block outputs              
        leds                => misc_leds                , -- out std_logic_vector( 3 downto 0);    -- LED output
        leds_en             => misc_leds_en             , -- out std_logic_vector( 3 downto 0);    -- CPU controlled LED enable 
        flash               => misc_flash               , -- out std_logic;    --     
        tick_msec           => tick_msec                , -- out std_logic;                        -- Single cycle high every 1 msec. Used by SD interface debug registers
        tick_sec            => tick_sec                 , -- out std_logic;                        -- Single cycle high every N msec. 

        dbg_ctrl            => misc_dbg_ctrl            , -- out std_logic_vector( 3 downto 0);
        trigger             => misc_trigger               -- out std_logic
    );

 
    -- Input to pulse stretcher in the misc block which can be used to make signals visible on the LEDs
    pulse(0)    <= trigger_dacs_pulse or dacs_dc_busy(0) or dacs_dc_busy(1) or dacs_dc_busy(2) or dacs_dc_busy(3) or dacs_pulse_busy;
    pulse(1)    <= '0';
    pulse(2)    <= tick_sec;
    pulse(3)    <= '0';

    p_leds(0)   <= misc_flash or gpio_btns(0);          -- 
    p_leds(1)   <= pulse_stretched(0);  -- trigger, dac busy, etc.
    p_leds(2)   <= pulse_stretched(1);  
    p_leds(3)   <= misc_leds(0);
    p_leds(4)   <= misc_leds(1);  
    p_leds(5)   <= or_reduce(dacs_pulse_axis_tdatas(1)) or ps_leds(0);  
    p_leds(6)   <= or_reduce(dacs_pulse_axis_tdatas(2)) or ps_leds(1);  
    p_leds(7)   <= or_reduce(dacs_pulse_axis_tdatas(3)) or ps_leds(2) or gpio_btns(4);  
    
    
 
    ---------------------------------------------------------------------------------
    -- Debug output mux.
    ---------------------------------------------------------------------------------
    pr_dbg_mux : process (clk)
    begin
        if rising_edge(clk) then

            p_debug_out(0)              <= trigger_dacs_pulse;
            p_debug_out(1)              <= any_dacs_busy;
            p_debug_out(2)              <= '0';
            p_debug_out(3)              <= or_reduce(dacs_pulse_axis_tvalids);
            p_debug_out(4)              <= or_reduce(dacs_pulse_axis_tdatas(0));
            p_debug_out(5)              <= or_reduce(dacs_pulse_axis_tdatas(1));
            p_debug_out(6)              <= or_reduce(dacs_pulse_axis_tdatas(2));
            p_debug_out(7)              <= or_reduce(dacs_pulse_axis_tdatas(3));

        end if;
    end process;


end zc102_fmc0_x2;
