uw-acme/NANO_QLASER/src/hdl/ip_custom/axi_qlaser_v1_0/axi_qlaser_v1_0_S00_AXI.vhd

------------------------------------------------------------------------------
-- Filename:          axi_if_qlaser.vhd
-- Version:           1.00.a
-- Description:       Convert axi-lite bus into a simple CPU bus to read/write 
-- Date:              Thu May 08 15:52:10 2014 (by Create and Import Peripheral Wizard)
-- VHDL Standard:     VHDL'93
------------------------------------------------------------------------------
-- Convert axi-lite to an external 'cpu' bus
-- This file was originally generated by the Xilinx tools then modified by 
-- gjones to add the interface logic for the external ports.
------------------------------------------------------------------------------
library ieee;
use ieee.std_logic_1164.all;
use ieee.numeric_std.all;

entity axi_qlaser_v1_0_S00_AXI is
	generic (
    C_S_AXI_DATA_WIDTH  : integer   := 32;      -- Width of S_AXI data bus
    C_S_AXI_ADDR_WIDTH  : integer   := 18       -- Width of S_AXI address bus
	);
	port (
		-- Users to add ports here
        -- CPU slave interface  to/from the block external to the CPU system
        clk_cpu             : out std_logic;
        cpu_wr              : out std_logic;                        -- Write enable
        cpu_rd              : out std_logic;                        -- Read enable
        cpu_addr            : out std_logic_vector(17 downto 0);    -- Address
        cpu_wdata           : out std_logic_vector(31 downto 0);    -- Write data
        cpu_rdata           : in  std_logic_vector(31 downto 0);    -- Read data
        cpu_rdata_dv        : in  std_logic;                        -- Read data valid
		-- User ports ends
		-- Do not modify the ports beyond this line

		-- Global Clock Signal
		S_AXI_ACLK	: in std_logic;
		-- Global Reset Signal. This Signal is Active LOW
		S_AXI_ARESETN	: in std_logic;
		-- Write address (issued by master, acceped by Slave)
		S_AXI_AWADDR	: in std_logic_vector(C_S_AXI_ADDR_WIDTH-1 downto 0);
		-- Write channel Protection type. This signal indicates the
    		-- privilege and security level of the transaction, and whether
    		-- the transaction is a data access or an instruction access.
		S_AXI_AWPROT	: in std_logic_vector(2 downto 0);
		-- Write address valid. This signal indicates that the master signaling
    		-- valid write address and control information.
		S_AXI_AWVALID	: in std_logic;
		-- Write address ready. This signal indicates that the slave is ready
    		-- to accept an address and associated control signals.
		S_AXI_AWREADY	: out std_logic;
		-- Write data (issued by master, acceped by Slave) 
		S_AXI_WDATA	: in std_logic_vector(C_S_AXI_DATA_WIDTH-1 downto 0);
		-- Write strobes. This signal indicates which byte lanes hold
    		-- valid data. There is one write strobe bit for each eight
    		-- bits of the write data bus.    
		S_AXI_WSTRB	: in std_logic_vector((C_S_AXI_DATA_WIDTH/8)-1 downto 0);
		-- Write valid. This signal indicates that valid write
    		-- data and strobes are available.
		S_AXI_WVALID	: in std_logic;
		-- Write ready. This signal indicates that the slave
    		-- can accept the write data.
		S_AXI_WREADY	: out std_logic;
		-- Write response. This signal indicates the status
    		-- of the write transaction.
		S_AXI_BRESP	: out std_logic_vector(1 downto 0);
		-- Write response valid. This signal indicates that the channel
    		-- is signaling a valid write response.
		S_AXI_BVALID	: out std_logic;
		-- Response ready. This signal indicates that the master
    		-- can accept a write response.
		S_AXI_BREADY	: in std_logic;
		-- Read address (issued by master, acceped by Slave)
		S_AXI_ARADDR	: in std_logic_vector(C_S_AXI_ADDR_WIDTH-1 downto 0);
		-- Protection type. This signal indicates the privilege
    		-- and security level of the transaction, and whether the
    		-- transaction is a data access or an instruction access.
		S_AXI_ARPROT	: in std_logic_vector(2 downto 0);
		-- Read address valid. This signal indicates that the channel
    		-- is signaling valid read address and control information.
		S_AXI_ARVALID	: in std_logic;
		-- Read address ready. This signal indicates that the slave is
    		-- ready to accept an address and associated control signals.
		S_AXI_ARREADY	: out std_logic;
		-- Read data (issued by slave)
		S_AXI_RDATA	: out std_logic_vector(C_S_AXI_DATA_WIDTH-1 downto 0);
		-- Read response. This signal indicates the status of the
    		-- read transfer.
		S_AXI_RRESP	: out std_logic_vector(1 downto 0);
		-- Read valid. This signal indicates that the channel is
    		-- signaling the required read data.
		S_AXI_RVALID	: out std_logic;
		-- Read ready. This signal indicates that the master can
    		-- accept the read data and response information.
		S_AXI_RREADY	: in std_logic
	);
end axi_qlaser_v1_0_S00_AXI;

architecture arch_imp of axi_qlaser_v1_0_S00_AXI is

	-- AXI4LITE signals
	signal axi_awaddr	: std_logic_vector(C_S_AXI_ADDR_WIDTH-1 downto 0);
	signal axi_awready	: std_logic;
	signal axi_wready	: std_logic;
	signal axi_bresp	: std_logic_vector(1 downto 0);
	signal axi_bvalid	: std_logic;
	signal axi_araddr	: std_logic_vector(C_S_AXI_ADDR_WIDTH-1 downto 0);
	signal axi_arready	: std_logic;
	signal axi_rdata	: std_logic_vector(C_S_AXI_DATA_WIDTH-1 downto 0);
	signal axi_rresp	: std_logic_vector(1 downto 0);
	signal axi_rvalid	: std_logic;

	------------------------------------------------
---- Signals for user logic 
	--------------------------------------------------
	signal slv_reg_wren	: std_logic;

signal cpu_waddr    : std_logic_vector(17 downto 0);    -- Write address
signal cpu_raddr    : std_logic_vector(17 downto 0);    -- Read address
signal cpu_rd_i     : std_logic;

begin

    -- I/O Connections assignments
	S_AXI_AWREADY	<= axi_awready;
	S_AXI_WREADY	<= axi_wready;
	S_AXI_BRESP	<= axi_bresp;
	S_AXI_BVALID	<= axi_bvalid;
	S_AXI_ARREADY	<= axi_arready;
	S_AXI_RDATA	<= axi_rdata;
	S_AXI_RRESP	<= axi_rresp;
	S_AXI_RVALID	<= axi_rvalid;
	-- Implement axi_awready generation
	-- axi_awready is asserted for one S_AXI_ACLK clock cycle when both
	-- S_AXI_AWVALID and S_AXI_WVALID are asserted. axi_awready is
	-- de-asserted when reset is low.

	process (S_AXI_ACLK)
	begin
	  if rising_edge(S_AXI_ACLK) then 
	    if S_AXI_ARESETN = '0' then
	      axi_awready <= '0';
	    else
          if (axi_awready = '0' and S_AXI_AWVALID = '1' and S_AXI_WVALID = '1') then
	        -- slave is ready to accept write address when
	        -- there is a valid write address and write data
	        -- on the write address and data bus. This design 
	        -- expects no outstanding transactions. 
	           axi_awready <= '1';
	      else
	        axi_awready <= '0';
	      end if;
	    end if;
	  end if;
	end process;


	-- Implement axi_awaddr latching
	-- This process is used to latch the address when both 
	-- S_AXI_AWVALID and S_AXI_WVALID are valid. 

	process (S_AXI_ACLK)
	begin
	  if rising_edge(S_AXI_ACLK) then 
	    if S_AXI_ARESETN = '0' then
	      axi_awaddr <= (others => '0');
	    else
          if (axi_awready = '0' and S_AXI_AWVALID = '1' and S_AXI_WVALID = '1') then
	        -- Write Address latching
	        axi_awaddr <= S_AXI_AWADDR;
	      end if;
	    end if;
	  end if;                   
	end process; 


	-- Implement axi_wready generation
	-- axi_wready is asserted for one S_AXI_ACLK clock cycle when both
	-- S_AXI_AWVALID and S_AXI_WVALID are asserted. axi_wready is 
	-- de-asserted when reset is low. 

	process (S_AXI_ACLK)
	begin
	  if rising_edge(S_AXI_ACLK) then 
	    if S_AXI_ARESETN = '0' then
	      axi_wready <= '0';
	    else
          if (axi_wready = '0' and S_AXI_WVALID = '1' and S_AXI_AWVALID = '1') then
	          -- slave is ready to accept write data when 
	          -- there is a valid write address and write data
	          -- on the write address and data bus. This design 
	          -- expects no outstanding transactions.           
	          axi_wready <= '1';
	      else
	        axi_wready <= '0';
	      end if;
	    end if;
	  end if;
	end process; 


    --------------------------------------------------------------------------------
    -- *** MODIFIED ***
    -- Removed internal registers. Now drives cpu_wr, cpu_waddr and cpu_wdata
    --------------------------------------------------------------------------------
	-- Implement memory mapped register select and write logic generation
	-- The write data is accepted and written to memory mapped registers when
    -- axi_awready, S_AXI_WVALID, axi_wready and S_AXI_WVALID are asserted. 
    -- write enable is asserted when valid address and data are available
	-- and the slave is ready to accept the write address and write data.
    --------------------------------------------------------------------------------
	slv_reg_wren <= axi_wready and S_AXI_WVALID and axi_awready and S_AXI_AWVALID ;

	process (S_AXI_ACLK)
	begin
	  if rising_edge(S_AXI_ACLK) then 
        if (S_AXI_ARESETN = '0') then
          cpu_wr    <= '0';
          cpu_waddr <= (others=>'0');
          cpu_wdata <= (others=>'0');
	    else
	      if (slv_reg_wren = '1') then
            cpu_wr    <= '1';
            cpu_waddr <= axi_awaddr;
            cpu_wdata <= S_AXI_WDATA;
          else
            cpu_wr    <= '0';
            cpu_waddr <= (others=>'0');
            cpu_wdata <= (others=>'0');
	      end if;
	    end if;
	  end if;                   
	end process; 


	-- Implement write response logic generation
	-- The write response and response valid signals are asserted by the slave 
	-- when axi_wready, S_AXI_WVALID, axi_wready and S_AXI_WVALID are asserted.  
	-- This marks the acceptance of address and indicates the status of 
	-- write transaction.
	process (S_AXI_ACLK)
	begin
	  if rising_edge(S_AXI_ACLK) then 
	    if S_AXI_ARESETN = '0' then
	      axi_bvalid  <= '0';
	      axi_bresp   <= "00"; --need to work more on the responses
	    else
	      if (axi_awready = '1' and S_AXI_AWVALID = '1' and axi_wready = '1' and S_AXI_WVALID = '1' and axi_bvalid = '0'  ) then
	        axi_bvalid <= '1';
	        axi_bresp  <= "00"; 
	      elsif (S_AXI_BREADY = '1' and axi_bvalid = '1') then   --check if bready is asserted while bvalid is high)
	        axi_bvalid <= '0';                                 -- (there is a possibility that bready is always asserted high)
	      end if;
	    end if;
	  end if;                   
	end process; 

	-- Implement axi_arready generation
	-- axi_arready is asserted for one S_AXI_ACLK clock cycle when
	-- S_AXI_ARVALID is asserted. axi_awready is 
	-- de-asserted when reset (active low) is asserted. 
	-- The read address is also latched when S_AXI_ARVALID is 
	-- asserted. axi_araddr is reset to zero on reset assertion.

	process (S_AXI_ACLK)
	begin
	  if rising_edge(S_AXI_ACLK) then 
	    if S_AXI_ARESETN = '0' then
	      axi_arready <= '0';
	      axi_araddr  <= (others => '1');
	    else
	      if (axi_arready = '0' and S_AXI_ARVALID = '1') then
	        -- indicates that the slave has acceped the valid read address
	        axi_arready <= '1';
	        -- Read Address latching 
	        axi_araddr  <= S_AXI_ARADDR;           
	      else
	        axi_arready <= '0';
	      end if;
	    end if;
	  end if;                   
	end process; 

    --------------------------------------------------------------------------------
    -- *** ADDED ***
    -- Removed internal registers. Now drives cpu_rd, cpu_raddr
    --------------------------------------------------------------------------------
    --------------------------------------------------------------------------------
    process (S_AXI_ACLK)
    begin
      if rising_edge(S_AXI_ACLK) then 

        if S_AXI_ARESETN = '0' then
          cpu_rd_i    <= '0';
          cpu_raddr   <= (others=>'0');
        else

          -- New. Drive cpu_rd and the read address until data is returned
	      if (axi_arready = '0' and S_AXI_ARVALID = '1') then
            cpu_rd_i    <= '1';
            cpu_raddr   <= S_AXI_ARADDR;           
          elsif (cpu_rdata_dv = '1') then
            cpu_rd_i    <= '0';
            cpu_raddr   <= (others=>'0');
          end if;

        end if;
      end if;                   

    end process; 
    cpu_rd    <= cpu_rd_i;


    --------------------------------------------------------------------------------
    -- *** MODIFIED ***
    -- Removed internal registers. Set axi_rvalid with additional cpu_rdata_dv
    --------------------------------------------------------------------------------
	-- Implement axi_arvalid generation
	-- axi_rvalid is asserted for one S_AXI_ACLK clock cycle when both 
	-- S_AXI_ARVALID and axi_arready are asserted. The slave registers 
	-- data are available on the axi_rdata bus at this instance. The 
	-- assertion of axi_rvalid marks the validity of read data on the 
	-- bus and axi_rresp indicates the status of read transaction.axi_rvalid 
	-- is deasserted on reset (active low). axi_rresp and axi_rdata are 
	-- cleared to zero on reset (active low).  
	process (S_AXI_ACLK)
	begin
	  if rising_edge(S_AXI_ACLK) then

        if (S_AXI_ARESETN = '0') then
	      axi_rvalid <= '0';
	      axi_rresp  <= "00";
	    else
          if (axi_rvalid = '0' and cpu_rd_i='1' and cpu_rdata_dv='1') then
	        -- Valid read data is available at the read data bus
	        axi_rvalid <= '1';
	        axi_rresp  <= "00"; -- 'OKAY' response
	      elsif (axi_rvalid = '1' and S_AXI_RREADY = '1') then
	        -- Read data is accepted by the master
	        axi_rvalid <= '0';
	      end if;            
	    end if;
	  end if;

	end process; 


    --------------------------------------------------------------------------------
    -- *** MODIFIED ***
    -- Removed internal registers. Now returns cpu_rdata instead of register data
    --------------------------------------------------------------------------------
	process( S_AXI_ACLK ) is
	begin
      if rising_edge (S_AXI_ACLK) then
	    if ( S_AXI_ARESETN = '0' ) then
	      axi_rdata  <= (others => '0');
	    else
          if (cpu_rdata_dv = '1') then
              axi_rdata     <= cpu_rdata;
	      end if;   
	    end if;
	  end if;
	end process;


    clk_cpu     <= S_AXI_ACLK;              -- Pass through the AXI bus clock
    cpu_addr    <= cpu_raddr or cpu_waddr;  -- Combine the addresses into one bus

end arch_imp;
