uw-acme/NANO_QLASER/src/hdl/testbench/gj_uart_tb.vhd

-------------------------------------------------------------------------------
--  File Name   : gj_uart_tb.vhd
--  Purpose     : 8-bit UART, odd,even or no parity.
--                Meant for testbench use. Allows forcing of transmit erros.
-------------------------------------------------------------------------------
library ieee;
use     ieee.std_logic_1164.all;
use     ieee.std_logic_arith.all;
use     ieee.std_logic_unsigned.all;

entity gj_uart_tb is
port
(
    reset       : in  std_logic;
    clk         : in  std_logic;

    -- Configuration
    bitwidth    : in  std_logic_vector(11 downto 0);    -- Baud rate divisor 
    parity_on   : in  std_logic;                        -- Enable parity checking and addition
    parity_odd  : in  std_logic;                        -- Set parity to 'odd', else 'even'
    err_parity  : in  std_logic;                        -- Force a parity error
    err_data    : in  std_logic;                        -- Force a data error

    data_tx     : in  std_logic_vector( 7 downto 0);    -- Data to transmit
    data_tx_wr  : in  std_logic;                        -- Write control for data_tx
    tx_ready    : out std_logic;                        -- Ready for transmit data

    data_rx     : out std_logic_vector( 7 downto 0);    -- Received data
    data_rx_dv  : out std_logic;                        -- Received data valid
    data_rx_err : out std_logic;                        -- Error in received data
    
    -- Serial interface
    rxd         : in  std_logic;                        -- Serial input/receive data
    txd         : out std_logic                         -- Serial output/transmit data 
);  
end gj_uart_tb;

architecture rtl of gj_uart_tb is

signal parity_tx        : std_logic;  
signal rx_err_parity    : std_logic;  
signal rx_err_framing   : std_logic;  

signal sreg_tx          : std_logic_vector( 7 downto 0);  
signal cnt_bit_tx       : std_logic_vector( 3 downto 0);  
signal cnt_tick_tx      : std_logic_vector(bitwidth'high downto bitwidth'low);  

signal sreg_rx          : std_logic_vector( 7 downto 0);  
signal cnt_bit_rx       : std_logic_vector( 3 downto 0);  
signal cnt_tick_rx      : std_logic_vector(bitwidth'high downto bitwidth'low);  
signal filtreg_rxd      : std_logic_vector( 7 downto 0);  
signal rxd_filtered     : std_logic;

-- State variable type definitions
type t_state_tx is (S_TX_IDLE, S_TX_START, S_TX_DATA, S_TX_PARITY, S_TX_STOP);
signal state_tx         : t_state_tx;

type t_state_rx is (S_RX_IDLE, S_RX_START, S_RX_DATA, S_RX_PARITY, S_RX_STOP, S_RX_DONE);
signal state_rx         : t_state_rx;
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
