uw-acme/NANO_QLASER/(commit log)

2022-10-23 Added src/hdl/serial_io files for UART-to-CPUbus interface
2022-11-03 Added 16-bit SPI interface
2022-11-03 Add spreadsheet for serial interface calculations
    [Qlaser_serial_prog_time.xlsx]
2022-11-08 Update model_ad5628.vhd
    Fix name of chip
    [model_ad5628.vhd]
2022-11-14 Added 1 SPI interface
2022-11-21 SPI module update
    Changed spi to output valid data on the falling edge of the clock.
2022-11-22 Added 3 more spi interfaces to the design
2023-01-20 Update Laser Control FPGA User Guide.docx
2023-02-01 Added Visio diagram of board usage.
    Also PDF export from Visio
2023-02-03 Add version read button to gui
2023-02-17 Fixed missing 'begin' in ps1_wrapper._sim.vhd
    Duh!
    [ps1_wrapper_sim.vhd]
2023-04-05 pulsed dac state machine and python updates
    [Experiment1.xlsx]
2023-04-14 Fixed some typos for compilation
    [qlaser_dacs_pulse_tb.vhd, qlaser_jesd_tx.vhd, qlaser_jesd_tx_tb.vhd]
2023-11-11 Updates to old pulse channel and PDF docs
    [Qlaser_serial_1chan_prog_time.xlsx]
2023-11-16 Python GUI name change. Obsolete file removal
    Changed name of
    Removed obsolete Python files.
    [Experiment1.xlsx]
2024-11-04 Added datasheets for devices on Abaco board
2024-11-21 Added Visio drawings, PDFs, Excel sheets and Word doc to Diagrams directory
    [FMC_connector_pinout.xlsx]
